openxc/openxc-accessories/README.md

# openxc-accessories
OpenXC Accessories

These devices are not released for public consumption yet.

# License

Copyright (c) 2017 Ford Motor Company Licensed under the BSD license.
