openxc/openxc-accessories/docs/design-sources.rst

==============
Design Sources
==============

.. toctree::
    :maxdepth: 1

    electrical
    mechanical
    assembly
