openxc/openxc-accessories/docs/electrical/Modem/SCHEMATIC-02-Block Diagram.pdf

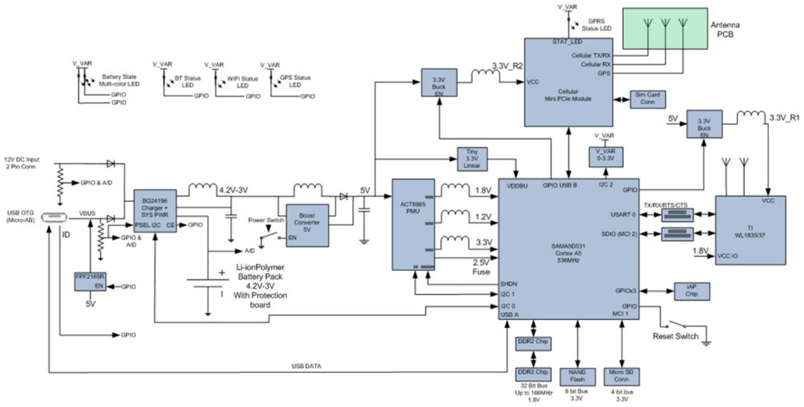
[picture p14: page 1]
