openxc/openxc-accessories/docs/pictures/Figure 5.PNG

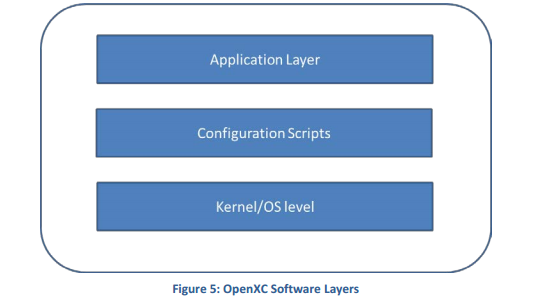
docs/pictures/Figure 5.PNG
