openxc/openxc-accessories/docs/electrical/V2X/BOM_DVT_20160208.xls

Level | Number | Part Type | Description | Commodity Code | BOM.Qty | BOM.UOM | BOM.Ref Des | Manufacturers.Mfr. Name | Manufacturers.Mfr. Part Number
0 | ASY-00001506-001 | Part | ASY,MECHANICAL BOM,OPEN XC V2X
1 | HWR-00001311-000 | Part | ROUND SPACER 0.105" NYLON 5.46MM | HARDWARE (HDW) | 2 | ea |  | BIVAR | 907-215
1 | HWR-00001484-000 | Part | SPACER,NYLON,3/16" OD X 7/32" LENGTH,UNTHREADED,4 | HARDWARE (HDW) | 2 | ea |  | MCMASTER CARR | 94639A617
1 | HWR-00001485-000 | Part | SCR,PAN HD,SLOTTED,MACHINE,NYLON,2x12mm,M2 | HARDWARE (HDW) | 2 | ea |  | MCMASTER CARR | 94270A108
1 | HWR-00001314-000 | Part | SCR,METRIC 18-8 SS PAN HD PHIL MACHINE W/WASHER M2.5 X 8mm LONG | HARDWARE (HDW) | 5 | ea |  | MCMASTER-CARR SUPPLY | 90317A105
1 | HWR-00001317-000 | Part | SCR,18-8 SS FLAT HEAD PHILLIPS BLACK OXIDE, M2 X 10mm LONG | HARDWARE (HDW) | 4 | ea |  | MCMASTER-CARR SUPPLY | 91698A206
1 | HWR-00001489-000 | Part | WASHER,LOCK,SPLIT,18-8 SS,M2 Screw Size,2.4mm ID,4.4mm OD | HARDWARE (HDW) | 2 | ea |  | MCMASTER CARR SUPPLY | 92148A050
1 | HWR-00001490-000 | Part | NUT,HIGH HEX,STEEL,ZINC,LOW-STRENGTH,M2x0.4 THREAD,4mm WIDE,2mm HIGH | HARDWARE (HDW) | 2 | ea |  | MCMASTER CARR SUPPLY | 90725A010
1 | MCH-00002535-000 | Part | BATTERY ADHESSIVE STRIP, 5930P .75in x 4.5 |  | 2 | ea |  | DUMMY MANUFACTURER | No MPN
1 | HWR-00001493-000 | Part | ADHESIVE,J-B WELD,50112, QUICK SETTING, 0.85 OUNCE SYRINGE | HARDWARE (HDW) | 0.001 | ea |  | MCMASTER-CARR SUPPLY | 7605A18
1 | ELC-00002536-000 | Part | ANTENNA,TERMINAL MOUNTED VERTICAL,W/SWIVEL CONNECTOR |  | 2 | ea |  | PULSE ELECTRONICS | W1010
1 | MCH-00001323-000 | Part | TOP HOUSING,INJECTION MOLDED, FMC OPENXC MODEM | NONE | 1 | ea |  | MODEL SOLUTION | MCH-00001323-000
1 | MCH-00001324-000 | Part | BOTTOM HOUSING,INJECTION MOLDED, FMC OPENXC MODEM | NONE | 1 | ea |  | MODEL SOLUTION | MCH-00001324-000
1 | MCH-00001326-000 | Part | BUTTON,INJECTION MOLDED, FMC OPENXC MODEM | NONE | 1 | ea |  | MODEL SOLUTION | MCH-00001326-000
1 | MCH-00001842-000 | Part | Custom Part: Battery Light Pipe-Injection Molded |  | 1 | ea |  | MODEL SOLUTION | No MPN
1 | MCH-00002537-000 | Part | CUSTOM PART: BLUETOOTH LIGHT PIPE-INJECTION MOLDED-V2X |  | 1 | ea |  | MODEL SOLUTION | MCH-00002537-000
1 | MCH-00002538-000 | Part | CUSTOM PART: WIFI LIGHT PIPE-INJECTION MOLDED-V2X |  | 1 | ea |  | MODEL SOLUTION | MCH-00002538-000
1 | MCH-00002539-000 | Part | CUSTOM PART: 802.11P LIGHT PIPE-INJECTION MOLDED-V2X |  | 1 | ea |  | MODEL SOLUTION | MCH-00002539-000
1 | PCA-00001143-002 | Part | PCA,FMC,MAIN,OpenXC | PCA's | 1 | ea |  | FLEXTRONICS INTERNATIONAL | PCA-00001143-001
2 | ELC-00001205-000 | Part | ANTENNA WLAN DUALBAND CERAM CHIP | NONE | 2 | EA | ANT1,ANT2 | PULSE | W3006
2 | CAP-00001213-000 | Part | CAP CER 10UF 35V 10% X7R 1206 | CAP,CERAMIC | 3 | EA | C1,C3,C5 | SAMSUNG | CL31B106KLHNFNE
2 | CAP-00000023-000 | Part | CAP CER 4.7UF 10V 10% X5R 0402 | Capacitors | 16 | EA | C2,C9,C10,C17,C29,C33,C46,C47,C48,C52,C53,C74,C114,C116,C149,C154 | SAMSUNG ELECTRONICS | CL05A475KP5NRNC
2 | CAP-00000018-000 | Part | CAP CER 1UF 10V 20% X5R 0201 | CAP, CER, SMT, 0201 PCK | 50 | EA | C4,C16,C22,C26,C27,C28,C42,C44,C45,C50,C51,C54,C55,C56,C57,C58,C59,C60,C61,C62,C63,C64,C65,C67,C69,C71,C72,C75,C76,C118,C119,C120,C121,C126,C128,C132,C133,C138,C141,C142,C143,C145,C147,C148,C150,C151,C152,C155,C158,C159 | SAMSUNG ELECTRONICS | CL03A105MP3NSNC
2 | CAP-00001214-000 | Part | CAP CER 0.047UF 10V 10% X5R 0201 | CAP, CER, SMT, 0402 PCK | 2 | EA | C6,C40 | SAMSUNG | CL03A473KP3NNNC
2 | CAP-00001215-000 | Part | CAP CER 22UF 25V 20% X5R 0805 | CAP, CER, SMT, 0805 PCK | 9 | EA | C7,C14,C15,C19,C20,C21,C125,C137,C156 | SAMSUNG | CL21A226MAQNNNE
2 | CAP-00001216-000 | Part | CAP CER 10UF 25V 10% X5R 0805 | CAP, CER, SMT, 0805 PCK | 6 | EA | C8,C23,C24,C25,C124,C136 | SAMSUNG | CL21A106KAFN3NE
2 | CAP-00000020-000 | Part | CAP CER 10UF 10V 20% X5R 0402 | CAP, CER, SMT, 0402 PCK | 9 | EA | C11,C12,C30,C31,C34,C35,C37,C38,C144 | SAMSUNG | CL05A106MP5NUNC
2 | CAP-00000024-000 | Part | CAP CER 0.1UF 10V 10% X5R 0201 | Capacitors | 47 | EA | C13,C32,C36,C39,C41,C43,C79,C80,C81,C82,C83,C84,C85,C86,C87,C88,C89,C90,C91,C92,C93,C94,C95,C96,C97,C98,C99,C100,C101,C102,C103,C104,C105,C106,C107,C108,C109,C110,C111,C112,C113,C115,C117,C146,C153,C157,C160 | SAMSUNG ELECTRONICS | CL03A104KP3NNNC
2 | CAP-00000025-000 | Part | CAP CER 10000PF 10V 10% X5R 0201 | Capacitors | 6 | EA | C18,C49,C127,C129,C139,C140 | MURATA ELECTRONICS | GRM033R61A103KA01D
2 | CAP-00001217-000 | Part | CAP CER 15PF 50V 5% NP0 0201 | CAP, CER, SMT, 0201 PCK | 2 | EA | C66,C68 | MURATA MANUFACTURING | GRM0335C1H150JA01D
2 | CAP-00001218-000 | Part | CAP CER 20PF 25V 5% NP0 0201 | CAP, CER, SMT, 0201 PCK | 2 | EA | C70,C73 | MURATA MANUFACTURING | GRM0335C1E200JA01D
2 | CAP-00000122-000 | Part | CAP CER 10PF 50V 2% NP0 0402 | CAP, CER, SMT, 0402 PCK | 1 | EA | C77 | MURATA MANUFACTURING | GRM1555C1H100GA01D
2 | RES-00000102-000 | Part | RES,0R OHM,1/16W,0402 | RESISTORS | 1 | EA | C130 | WALSIN TECHNOLOGY | WR04X000 PTL
 |  |  |  |  |  |  |  | YAGEO | RC0402JR-070RL
 |  |  |  |  |  |  |  | KOA SPEER ELECTRONICS | RK73Z1ETTP
2 | CAP-00001468-000 | Part | CAP CER 1.2PF 50V NP0 0402 | CAP,CERAMIC | 1 | EA | C131 | MURATA MANUFACTURING | GJM1555C1H1R2BB01D
2 | DIO-00001221-000 | Part | DIODE SCHOTTKY 100V 2A POWERMITE | Diodes | 1 | EA | D1 | ON SEMICONDUCTOR | MBRM2H100T3G
2 | DIO-00001222-000 | Part | TVS DIODE 14VWM 23.2VC SMB | Diodes | 1 | EA | D2 | ON SEMICONDUCTOR | 1SMB14CAT3G
2 | DIO-00001469-000 | Part | DIODE SCHOTTKY 20V 2A SOD323 | Diodes | 4 | EA | D3,D4,D6,D15 | NXP SEMICONDUCTORS | PMEG2020AEA,115
2 | DIO-00000623-000 | Part | TVS DIODE 5VWM 18VC SOD882 | Diodes | 2 | EA | D5,D9 | NXP SEMICONDUCTORS | PESD5V0S1UL,315
 |  |  |  |  |  |  |  | NXP SEMICONDUCTORS | PESD9X5.0L
2 | DIO-00000029-000 | Part | TVS DIODE 5VWM SOD882 | Diodes | 2 | EA | D7,D8 | NXP SEMICONDUCTORS | PESD5V0X1BL
 |  |  |  |  |  |  |  | NXP SEMICONDUCTORS | PESD5V0X1BL,315
2 | DIO-00001224-000 | Part | LED 3.2X1.0MM RD/GRN R/A SMD | Diodes | 1 | EA | D10 | KINGBRIGHT | APBA3010SURKCGKC-GX
2 | DIO-00001470-000 | Part | LED RA SMD BLUE 470NM | Diodes | 4 | EA | D11,D12,D13,D14 | KINGBRIGHT | APA3010QBC/D-GX
2 | CON-00001226-000 | Part | CONN HEADER 3POS .100" SNGL SMD | Diodes | 1 | EA | JP1 | SAMTEC | TSM-103-01-L-SV
2 | CON-00001150-000 | Part | CONN HEADER 3MM 2POS R/A TIN | CAP, CER, SMT, 0402 PCK | 1 | EA | J1 | TE CONNECTIVITY | 2-1445055-2
2 | CON-00001227-000 | Part | CONN HEADER PH SIDE 2POS 2MM SMD | CONNECTORS | 1 | EA | J2 | JST | S2B-PH-SM4-TB(LF)(SN)
2 | CON-00001228-000 | Part | CONN UUSB AB REC TOPMT FLANGE TH GRAY | CONNECTORS | 1 | EA | J3 | MOLEX | 47590-1001
2 | CON-00001229-000 | Part | CONN SOCKET MEMORY PCI-E 8H Type I PKG G/F 52P | CONNECTORS | 1 | EA | J4 | MOLEX | 48338-0080
 |  |  |  |  |  |  |  | TE CONNECTIVITY | 1759503-1
2 | CON-00001230-000 | Part | CONN SIM CARD PUSH-PUSH R/A SMD | CONNECTORS | 1 | EA | J5 | WURTH ELECTRONICS | 693 013 050 811
2 | CON-00000134-000 | Part | CONN MICRO SD R/A PUSH-PUSH SMD | CONNECTORS | 1 | EA | J6 | HIROSE | DM3AT-SF-PEJM5
2 | CON-00001471-000 | Part | CONN HEADER 6POS .100" SGL HRZ SMD | CONNECTORS | 1 | EA | J8 | SAMTEC | TSM-106-02-L-SH-P
2 | CON-00001307-000 | Part | CONN UMC JACK STR 50 OHM SMD | CONNECTORS | 2 | EA | J9,J10 | HIROSE | U.FL-R-SMT-1 (10)
2 | IND-00001233-000 | Part | FIXED POWER IND 2.2uH 20% 8A | Inductors | 1 | EA | L1 | COILCRAFT | XFL4020-222MEC
2 | IND-00001234-000 | Part | INDUCTOR 1uH 20% 11A FIXED PWR COMPOS | Inductors | 1 | EA | L2 | COILCRAFT | XFL4020-102MEC
2 | IND-00001235-000 | Part | FIXED IND 10UH 300MA 600 MOHM | Inductors | 4 | EA | L3,L5,L11,L12 | TDK | MLZ1608N100LT000
2 | IND-00001268-000 | Part | FIXED IND 2.2UH 1.3A 80 MOHM SMD | Inductors | 3 | EA | L4,L6,L7 | MURATA MANUFACTURING | LQM2HPN2R2MG0L
2 | IND-00001269-000 | Part | FERRITE CHIP 180OHM 1500MA 0603 | Inductors | 3 | EA | L8,L9,L10 | MURATA MANUFACTURING | BLM18PG181SN1D
2 | IND-00001270-000 | Part | IND .47uH 5.5A XFL4012 | Inductors | 2 | EA | L13,L18 | COILCRAFT | XFL4012-471MEC
2 | IND-00001272-000 | Part | FIXED IND 2.2NH 220MA 300 MOHM | Inductors | 1 | EA | L16 | MURATA ELECTRONICS | LQP15MN2N2B02D
2 | IND-00001472-000 | Part | FIXED IND 4.7NH 160MA 600 MOHM | Inductors | 1 | EA | L17 | MURATA MANUFACTURING | LQP15MN4N7B02D
2 | ICS-00001274-000 | Part | IC,MOSFET N-CH 20V 4.2A SOT-23 | IC,PROC,MICROPROCES | 5 | EA | Q1,Q3,Q4,Q5,Q6 | INTERNATIONAL RECTIFIER | IRLML2502TRPBF
2 | ICS-00001473-000 | Part | IC MOSFET P-CH 30V 3.6A SOT-23-3 | IC | 1 | ea | Q2 | INTERNATIONAL RECTIFIER | IRLML9301TRPBF
2 | RES-00000048-000 | Part | RES 15K OHM 1/20W 1% 0201 SMD | RES,CHIP THICK FILM,0201 | 1 | EA | R1 | PANASONIC | ERJ-1GEF1502C
2 | RES-00000039-000 | Part | RES 10K OHM 1/20W 1% 0201 SMD | RES,CHIP THICK FILM,0201 | 29 | ea | R2,R6,R7,R14,R15,R16,R17,R19,R21,R24,R34,R47,R51,R105,R139,R141,R148,R152,R188,R189,R190,R195,R200,R201,R202,R203,R209,R210,R215 | KOA SPEER ELECTRONICS | RK73H1HTTC1002F
2 | RES-00001275-000 | Part | RES 2K OHM 1/20W 1% 0201 SMD | RES,CHIP THICK FILM,0603 | 8 | ea | R3,R5,R13,R27,R28,R30,R31,R214 | PANASONIC | ERJ-1GEF2001C
2 | RES-00001474-000 | Part | RES SMD 4.32K OHM 1% 1/20W 0201 | RES,CHIP THICK FILM,0402 | 1 | ea | R4 | PANASONIC | ERJ-1GEF4321C
2 | RES-00000684-000 | Part | RES 20K OHM 1/20W 1% 0201 SMD | RES,CHIP THICK FILM,0201 | 1 | EA | R9 | PANASONIC | ERJ-1GEF2002C
2 | RES-00001278-000 | Part | THERMISTOR NTC 10K OHM 1% 0402 | RES,CHIP THICK FILM,0201 | 1 | EA | R11 | PANASONIC | ERT-J0EG103FA
2 | RES-00001279-000 | Part | RES 267 OHM 1/20W 1% 0201 SMD | RES,CHIP THICK FILM,0201 | 1 | EA | R12 | PANASONIC | ERJ-1GEF2670C
2 | RES-00000041-000 | Part | RES 1K OHM 1/20W 1% 0201 SMD | RES,CHIP THICK FILM,0201 | 5 | EA | R18,R36,R143,R144,R145 | KOA SPEER ELECTRONICS | RK73H1HTTC1001F
2 | RES-00000053-000 | Part | RES 200 OHM 1/20W 1% 0201 SMD | RES,CHIP THICK FILM,0201 | 5 | EA | R20,R65,R68,R187,R216 | PANASONIC | ERJ-1GEF2000C
2 | RES-00001280-000 | Part | RES 374 OHM 1/20W 1% 0201 SMD | RES,CHIP THICK FILM,0201 | 1 | EA | R22 | PANASONIC | ERJ-1GEF3740C
2 | RES-00001281-000 | Part | RES 1.27K OHM 1/20W 1% 0201 SMD | RES,CHIP THICK FILM,0201 | 1 | EA | R23 | PANASONIC | ERJ-1GEF1271C
2 | RES-00001478-000 | Part | RES SMD 33.2K OHM 1% 1/20W 0201 | RES,CHIP THICK FILM,0402 | 1 | ea | R25 | PANASONIC | ERJ-1GEF3322C
2 | RES-00000045-000 | Part | RES 100K OHM 1/20W 1% 0201 SMD | RES,CHIP THICK FILM,0201 | 13 | EA | R26,R40,R41,R44,R70,R71,R72,R107,R140,R154,R155,R156,R157 | PANASONIC | ERJ-1GEF1003C
2 | RES-00000872-000 | Part | RES 1 OHM 1/10W 5% 0402 SMD | RESISTORS | 3 | EA | R29,R48,R66 | PANASONIC | ERJ-2GEJ1R0X
2 | RES-00001282-000 | Part | RES 2.2 OHM 1/10W 5% 0402 SMD | RESISTORS | 3 | EA | R32,R35,R39 | PANASONIC | ERJ-2GEJ2R2X
2 | RES-00000040-000 | Part | RES 49.9K OHM 1/20W 1% 0201 SMD | RES,CHIP THICK FILM,0201 | 26 | ea | R37,R38,R146,R147,R149,R150,R158,R159,R169,R170,R171,R172,R173,R174,R175,R176,R177,R178,R179,R180,R181,R182,R183,R184,R185,R186 | PANASONIC | ERJ-1GEF4992C
2 | RES-00001283-000 | Part | RES 1.5K OHM 1/20W 1% 0201 SMD | RES,CHIP THICK FILM,0201 | 3 | EA | R43,R67,R69 | PANASONIC | ERJ-1GEF1501C
2 | RES-00001284-000 | Part | RES 5.62K OHM 1/20W 1% 0201 SMD | RES,CHIP THICK FILM,0201 | 1 | EA | R49 | PANASONIC | ERJ-1GEF5621C
2 | RES-00000148-000 | Part | RES 0.0 OHM 1/8W JUMP 0805 SMD | RES,CHIP THICK FILM,0805 | 2 | EA | R50,R206 | YAGEO | RC0805FR-070RL
2 | RES-00000043-000 | Part | RES 0.0 OHM 1/20W JUMP 0201 SMD | RES,CHIP THICK FILM,0201 | 18 | EA | R52,R59,R60,R106,R108,R162,R163,R164,R165,R166,R167,R168,R196,R198,R204,R208,R212,R217 | YAGEO | RC0201JR-070RL
2 | RES-00001479-000 | Part | RES SMD 140 OHM 1% 1/20W 0201 | RES,CHIP THICK FILM,0402 | 1 | ea | R53 | PANASONIC | ERJ-1GEF1400C
2 | RES-00001480-000 | Part | RES SMD 84.5 OHM 1% 1/20W 0201 | RES,CHIP THICK FILM,0402 | 4 | ea | R54,R55,R56,R142 | PANASONIC | ERJ-1GEF84R5C
2 | RES-00001285-000 | Part | RES 4.7K OHM 1/20W 1% 0201 SMD | RES,CHIP THICK FILM,0201 | 6 | EA | R61,R62,R63,R64,R194,R219 | PANASONIC | ERJ-1GEF4701C
2 | RES-00000050-000 | Part | RES 20 OHM 1/20W 1% 0201 SMD | RES,CHIP THICK FILM,0201 | 1 | EA | R153 | PANASONIC | ERJ-1GEF20R0C
2 | RES-00001481-000 | Part | RES SMD 402 OHM 1% 1/20W 0201 | RES,CHIP THICK FILM,0402 | 2 | ea | R191,R192 | PANASONIC | ERJ-1GEF4020C
2 | RES-00001276-000 | Part | RES 5.49K OHM 1/20W 1% 0201 SMD | RES,CHIP THICK FILM,0201 | 1 | EA | R193 | PANASONIC | ERJ-1GEF5491C
2 | RES-00001482-000 | Part | RES SMD 576 OHM 1% 1/20W 0201 | RES,CHIP THICK FILM,0201 | 1 | EA | R207 | PANASONIC | ERJ-1GEF5760C
2 | ELC-00001286-000 | Part | SWITCH PUSH SPDT 0.2A 30V | SWITCHES | 1 | EA | SW1 | C & K COMPONENTS | PN12SJNA03QE
2 | ELC-00000526-002 | Part | SWITCH TACTILE SPST-NO 0.05A 12V | Electrical | 1 | EA | SW2 | PANASONIC | EVQPUK02K
2 | ICS-00001287-000 | Part | IC BATT CHARGE MGMT 24VQFN | IC | 1 | EA | U1 | TEXAS INSTRUMENTS | bq24196RGET
2 | ICS-00001288-000 | Part | IC LOAD SW FULL FUNCT ADJ 6MLP | IC | 1 | EA | U2 | FAIRCHILD | FPF2165R
2 | ICS-00001289-000 | Part | IC REG LDO ADJ 0.15A 6MLF | IC | 1 | EA | U3 | MICREL | MIC5305YML
2 | ICS-00001290-000 | Part | IC REG BOOST SYNC 5V 5A 10SON | IC | 1 | EA | U4 | TEXAS INSTRUMENTS | TPS61232DRCT
2 | ICS-00001291-000 | Part | IC POT DGTL 32TAP NV TSOT23-6 | IC | 1 | EA | U5 | MAXIM INTEGRATED PRODUCTS | MAX5434LEZT+T
2 | ICS-00001292-000 | Part | IC PMU CONV/LDO REG 32TQFN | IC | 1 | EA | U6 | ACTIVE SEMI | ACT8865QI305-T
2 | ICS-00001293-000 | Part | IC REG LDO 3.3V 0.15A SOT23 | IC | 1 | EA | U7 | DIODES | AP2120N-3.3TRG1
2 | ICS-00001294-000 | Part | IC MCU 32BIT 160KB FLASH 324BGA | IC | 1 | EA | U8 | ATMEL | ATSAMA5D31A-CU
2 | ICS-00001295-000 | Part | IC DDR2 SDRAM 1GBIT 2.5NS 84FBGA | IC | 2 | EA | U9,U10 | MICRON | MT47H64M16HR-25E:H
2 | ICS-00001308-000 | Part | IC BUS TRANSCVR 4BIT 16-UQFN | IC | 2 | EA | U12,U13 | TEXAS INSTRUMENTS | SN74AVC4T245RSVR
2 | ICS-00001298-000 | Part | IC REG BUCK SYNC 3.3V 3A 16QFN | IC | 2 | EA | U14,U18 | TEXAS INSTRUMENTS | TPS62091RGTT
2 | ELC-00001299-000 | Part | MODULE WIFI WILINK | NONE | 1 | EA | U15 | TEXAS INSTRUMENTS | WL1835MODGBMOCT
 |  |  |  |  |  |  |  | TEXAS INSTRUMENTS | WL1835MODGBMOCR
 |  |  |  |  |  |  |  | TEXAS INSTRUMENTS | WL1837MODGIMOCT
 |  |  |  |  |  |  |  | TEXAS INSTRUMENTS | WL1837MODGIMOCR
2 | ICS-00001309-000 | Part | IC XLATR VOLT-LVL 8B BDIR 20QFN | IC | 1 | EA | U16 | TEXAS INSTRUMENTS | TXS0108ERGYR
2 | ICS-00001303-000 | Part | IC EEPROM 2KBIT 400KHZ TSOT23-5 | IC | 1 | EA | U19 | ON SEMICONDUCTOR | CAT24AA02TDI-GT3
2 | ICS-00001310-000 | Part | IC BUFF/DVR NON-INVERT SC705 | IC | 1 | EA | U21 | TEXAS INSTRUMENTS | SN74AUC1G07DCKR
2 | ICS-00001476-000 | Part | IC USB FS SERIAL UART 32-QFN | IC | 1 | ea | U22 | FUTURE TECHNOLOGY DEVICES INTERNATIONAL | FT232RQ-REEL
2 | OSC-00001304-000 | Part | OSC XO 32.768KHZ CMOS SMD | OSC | 1 | EA | X1 | TXC CORPORATION | 7XZ-32.768KDA-T
2 | XTL-00001305-000 | Part | CRYSTAL 12MHZ 12PF SMD | Crystal | 1 | EA | Y1 | EPSON | FA-238V 12.0000MB-W3
2 | XTL-00000186-003 | Part | CRYSTAL 32.768KHZ 12.5PF SMD | Crystal | 1 | EA | Y2 | SEIKO INSTRUMENTS | SSPT7F-12.5PF20-R
2 | PCB-00001143-002 | Part | PCB,(FAB),FMC,MAIN,OpenXC | PCA's | 1 | EA |  | HALLMARK CIRCUITS | PCB-00001143-001
2 | RES-00001597-000 | Part | RES SMD 2.15K OHM 1% 1/20W 0201 | RES,CHIP THIN FILM | 1 | ea | R8 | PANASONIC | ERJ-1GNF2151C
2 | RES-00001598-000 | Part | RES SMD 7.5K OHM 1% 1/20W 0201 | RES,CHIP THIN FILM | 1 | ea | R10 | PANASONIC | ERJ-1GNF7501C
2 | RES-00001599-000 | Part | RES SMD 41.2K OHM 1% 1/20W 0201 | RES,CHIP THIN FILM | 1 | ea | R211 | PANASONIC | ERJ-1GNF4122C
2 | ICS-00001593-000 | Part | IC FLASH 4GBIT 48TSOP | IC | 1 | ea | U11 | MICRON TECHNOLOGY | MT29F4G08ABADAWP:D TR
1 | PCA-00001382-001 | Part | PCA Board, FMC,CARRIER,OpenXC V2X V2 |  | 1 | ea
2 | CAP-00002250-000 | Part | CAP CER 47UF 10V X5R 0805 | CAP, CER, SMT, 0805 PCK | 4 | ea | C15,C16,C17,C18 | TDK | C2012X5R1A476M125AC
2 | CAP-00000925-000 | Part | CAP CER 0.1UF 50V 10% X7R 0805 | CAP, CER, SMT, 0805 PCK | 1 | ea | C19 | KEMET ELECTRONICS | C0805C104K5RACAUTO
2 | RES-00002253-000 | Part | RES SMD 0.0 OHM JUMPER 1/16W 0402 | RES,CHIP THICK FILM | 4 | ea | C20,C21,C26,C27 | VISHAY | CRCW04020000Z0ED
2 | CON-00001431-000 | Part | CONN SMA JACK 50 OHM EDGE MNT | Connectors/Terminals/Lugs | 2 | ea | J2,J3 | AMPHENOL | 132289
2 | RES-00001380-000 | Part | RES SMD 0.0 OHM JUMPER 1/16W | RES,CHIP THICK FILM | 9 | ea | L1,L2,R1,R4,R5,R7,R8,R9,R10 | VISHAY | CRCW04020000Z0EDHP
2 | ICS-00001432-000 | Part | IC MOSFET N-CH 20V 1.2A SOT-23 | IC | 1 | ea | Q1 | INTERNATIONAL RECTIFIER | IRLML2502TRPBF
2 | RES-00000104-000 | Part | RES 10K OHM 1/16W 1% 0402 SMD | RESISTORS | 1 | ea | R3 | KOA SPEER ELECTRONICS | RK73H1ETTP1002F
 |  |  |  |  |  |  |  | YAGEO | RC0402FR-0710KL
 |  |  |  |  |  |  |  | WALSIN TECHNOLOGY | WR04X1002FTL
2 | ELC-00001440-000 | Part | MODULE,COHDA WIRELESS,MOBILE BROADBAND,MK5 | NONE | 1 | ea | U1 | COHDA WIRELESS | CWD-P0052-HWM-DATA-WW01-061
2 | PCB-00001382-001 | Part | PCB Board, FMC,CARRIER,OpenXC V2X V2 |  | 1 | ea
1 | LBL-00002540-000 | Part | LABEL,OPENXC V2X,1.5 Inch WIDE X .4 Inch HIGH |  | 1 | ea |  | DUMMY MANUFACTURER | No MPN
1 | ELC-00002541-000 | Part | BATTERY SUBASSEMBLY |  | 1 | ea
2 | CON-00001851-000 | Part | CONN HOUSING PH 2POS 2MM WHITE |  | 1 | ea |  | JST | PHR-2
2 | CON-00001852-000 | Part | CONN TERMINAL 28-24AWG TIN |  | 2 | ea |  | JST | SPH-002T-P0.5L
2 | ELC-00002542-000 | Part | Tenergy Li-Polymer 3.7V 5500mAh (7550140) Battery w/ PCB |  | 1 | ea |  | DUMMY MANUFACTURER | No MPN
