openxc/openxc-accessories/docs/electrical/Modem/Modem_COSTED_BOM_QUOTE.xlsx

Sheet: CBOM
Costed BOM |  |  |  |  |  |  |  |  |  |  |  |  | Quote Terms & Condition:
Project: |  |  | QUOTE ID#: 580 FORD |  |  |  |  |  |  |  |  |  | Quote valid for current revision of BOM
Volume: |  |  | 1-3 |  |  |  |  |  |  |  |  |  | Quote is based on combination of distributor and mfg stock.
Currency: |  |  | USD |  |  |  |  |  |  |  |  |  | Est cost on no distributor stock items will be updated once stock is found
Report On: |  |  | Selected Cost |  |  |  |  |  |  |  |  |  | Stock for low volumes reflects current avail and may be sold at any time - true price will be what is avail at time of purchase
Sort By: |  |  | Line Number |  |  |  |  |  |  |  |  |  | Quoted Price is valid for 30 days – subject to market conditions
Time Generated: |  |  | 8/4/15 5:22:50 PM |  |  |  |  |  |  |  |  |  | NCNR, MOQ and Excess buys, to be approved as required
 |  |  |  |  |  |  |  |  |  |  |  |  | Customer help is needed for missing pricing due to imcomplete AVL
*** Assembly Summary |  |  |  |  |  |  |  |  |  |  |  |  | Customer help is needed in the case of LOA and misalignment condition
Assembly | Line | Description | Ext Cost #1 | Ext Vol Qty #1 | Ext Vol Cost #1 | Ext Cost #2 | Ext Vol Qty #2 | Ext Vol Cost #2 | Ext Cost #3 | Ext Vol Qty #3 | Ext Vol Cost #3
TLA-00001300-002 | 1 | TLA,FMC,XCMODEM V1-DVT VERSION | 441.564379 | 50 | 22078.21895 | 409.633019 | 100 | 40963.3019 | 332.465999 | 500 | 166232.9995
TLA-00001300-002 ATTRITION | 2 | TLA,FMC,XCMODEM V1-DVT VERSION | 24.75356 | 50 | 618.839 | 10.94097 | 100 | 547.0485 | 1.5792912 | 500 | 394.8228
 |  |  | 466.317939 |  | 22697.05795 | 420.573989 |  | 41510.3504 | 334.0452902 |  | 166627.8223
*** Assembly: TLA-00001300-002 rev 1 Line #1
Part Number | Line | Part Qty | Unit | Description | Commodity | AML | Mfg ID | Mfg Part Number | Corrected MPN | Supp ID | No Bid | Lead Time | Inventory | MOQ | Delivery Terms | NCNR | Short Comment | Long Comment | Raw Currency | Currency | NRE Charge | Cost #1 | Ext Cost #1 | Cost #2 | Ext Cost #2 | Cost #3 | Ext Cost #3 | Ownership
ELC-00001321-000 | 1 | 1 | EA | MODULE,3G,MINI PCIE |  | X | TELIT | HEPCIGPS204T701 |  | ARROW |  | 7 | 498 | 3 | FOB |  |  |  | USD | USD |  | 87.52 | 87.52 | 87.52 | 87.52 | 81.14 | 81.14
ELC-00001327-000 | 2 | 1 | EA | PCA,ANTENNA BOARD,FMC OPENXC |  |  | WORLDPROD | WPANT10074-C2A |  | WPG |  | 16 | 100 | 100 |  |  |  |  | USD | USD |  | 2.48 | 2.48 | 2.48 | 2.48 | 2.48 | 2.48
ELC-00001836-000 | 3 | 1 | EA | 12 * 12 * 2MM PASSIVE GPS ANTENNA CABLE LENGTH 70MM |  | X | ISSUE | ELC-00001836-000 |  | ISSUE |  |  |  |  |  |  |  |  | USD | USD |  | 0 | 0
ELC-00001847-000 | 4 | 1 |  | BATTERY SUBASSEMBLY |  |  |  |  |  |  |  |  |  |  |  |  |  |  |  | USD |  | 40.1518 | 40.1518 | 40.1502 | 40.1502 | 40.12642 | 40.12642
HWR-00001311-000 | 5 | 2 | EA | ROUND SPACER 0.105 NYLON 5.46MM |  | X | BIVAR | 907-215 | 907-215 | MOUSER ELE |  | 4 | 3000 | 1 | N/A |  |  | QUOTE VALID FOR 30 DAYS - STANDOFFS & SPACERS PLASTIC SPCR .215 IN NYLON WHITE | USD | USD |  | 0.051 | 0.102 | 0.051 | 0.102 | 0.034 | 0.068
HWR-00001312-000 | 6 | 2 | EA | 18-8 STAINLESS STEEL METRIC PAN HEAD PHILLIPS MACHINE SCREW |  | X | MCMASTER | 92000A019 |  | MCMASTER |  | 4 | 2000 | 100 |  |  |  |  | USD | USD |  | 0.0476 | 0.0952 | 0.0476 | 0.0952 | 0.0476 | 0.0952
HWR-00001314-000 | 7 | 5 | EA | SCR,METRIC 18-8 SS PAN HD PHIL MACHINE W/WASHER M2.5 X 8MM LONG |  | X | MCMASTER | 90317A105 |  | MCMASTER |  | 4 | 5000 | 25 |  |  |  |  | USD | USD |  | 0.328 | 1.64 | 0.328 | 1.64 | 0.328 | 1.64
HWR-00001317-000 | 8 | 4 | EA | SCR,18-8 SS FLAT HEAD PHILLIPS BLACK OXIDE, M2 X 10MM LONG |  | X | MCMASTER | 91698A206 |  | MCMASTER |  | 4 | 4000 | 100 |  |  |  |  | USD | USD |  | 0.0992 | 0.3968 | 0.0992 | 0.3968 | 0.0992 | 0.3968
HWR-00001489-000 | 9 | 2 | EA | WASHER,LOCK,SPLIT,18-8 SS,M2 SCREW SIZE,2.4MM ID,4.4MM OD |  | X | MCMASTER | 92148A050 |  | MCMASTER |  | 4 | 2000 | 100 |  |  |  |  | USD | USD |  | 0.0118 | 0.0236 | 0.0118 | 0.0236 | 0.0118 | 0.0236
HWR-00001490-000 | 10 | 2 | EA | NUT,HIGH HEX,STEEL,ZINC,LOW-STRENGTH,M2X0.4 THREAD,4MM WIDE,2MM HIGH |  | X | MCMASTER | 90725A010 |  | MCMASTER |  | 4 | 2000 | 25 |  |  |  |  | USD | USD |  | 0.3128 | 0.6256 | 0.3128 | 0.6256 | 0.3128 | 0.6256
HWR-00001491-000 | 11 | 17.67 | IN | TAPE,FOAM,3M VHB,ADHESIVE ON BOTH SIDES,#4926,3/4 W X 72 YARDS L, .015 THICK |  | X | MCMASTER | 8127A72 |  | MCMASTER |  | 4 | 50000 | 2592 |  |  |  | PRICE FOR EACH INCHE | USD | USD |  | 0.0757 | 1.337619 | 0.0757 | 1.337619 | 0.0757 | 1.337619
HWR-00001492-000 | 12 | 1 | EA | TIE,CABLE,NYLON,4 LONG, 7/8 BUNDLE DIAMETER,10 LB. BREAK STRENGTH, BLACK |  | X | MCMASTER | 7130K52 |  | MCMASTER |  | 4 | 2000 | 100 |  |  |  |  | USD | USD |  | 0.0243 | 0.0243 | 0.0243 | 0.0243 | 0.0243 | 0.0243
HWR-00001493-000 | 13 | 0.07 | EA | ADHESIVE,J-B WELD,50112, QUICK SETTING, 0.85 OUNCE SYRINGE |  | X | MCMASTER | 7605A18 |  | MCMASTER |  | 4 | 100 | 1 |  |  |  | PRICE FOR BOTTLE OF 0.85 OUNCE | USD | USD |  | 5.74 | 0.4018 | 5.74 | 0.4018 | 5.74 | 0.4018
LBL-00001884-000 | 14 | 1 | EA | LABEL,OPENXC MODEM,1.5 INCH WIDE X .4 INCH HIGH |  | X | ISSUE | LBL-00001884-000 |  | ISSUE |  |  |  |  |  |  |  |  | USD | USD |  | 0 | 0
MCH-00001323-000 | 15 | 1 | EA | TOP HOUSING,INJECTION MOLDED, FMC OPENXC MODEM |  | X | CONSIGN | MCH-00001323-000 |  | CONSIGNED |  |  |  |  |  |  |  |  | USD | USD |  | 0 | 0
MCH-00001324-000 | 16 | 1 | EA | BOTTOM HOUSING,INJECTION MOLDED, FMC OPENXC MODEM |  | X | CONSIGN | MCH-00001324-000 |  | CONSIGNED |  |  |  |  |  |  |  |  | USD | USD |  | 0 | 0
MCH-00001326-000 | 17 | 1 | EA | BUTTON,INJECTION MOLDED, FMC OPENXC MODEM |  | X | CONSIGN | MCH-00001326-000 |  | CONSIGNED |  |  |  |  |  |  |  |  | USD | USD |  | 0 | 0
MCH-00001837-000 | 18 | 1 | EA | FERRITE COVER FOR PCB-NEC/TOKIN FLEX SUPPRESSOR EFF(03) T0800 |  | X | KEMET | EFF(03)-240X240T0800 |  | DIGIKEY |  | 18 |  | 10 |  |  |  |  | USD | USD |  | 85.74 | 85.74 | 85.74 | 85.74 | 82.5088 | 82.5088
MCH-00001842-000 | 19 | 1 | EA | CUSTOM PART: BATTERY LIGHT PIPE-INJECTION MOLDED |  | X | CONSIGN | MCH-00001842-000 |  | CONSIGNED |  |  |  |  |  |  |  |  | USD | USD |  | 0 | 0
MCH-00001843-000 | 20 | 1 | EA | CUSTOM PART:BLUETOOTH LIGHT PIPE-INJECTION MOLDED |  | X | CONSIGN | MCH-00001843-000 |  | CONSIGNED |  |  |  |  |  |  |  |  | USD | USD |  | 0 | 0
MCH-00001844-000 | 21 | 1 | EA | CUSTOM PART: 3G LIGHT PIPE-INJECTION MOLDED |  | X | CONSIGN | MCH-00001844-000 |  | CONSIGNED |  |  |  |  |  |  |  |  | USD | USD |  | 0 | 0
MCH-00001845-000 | 22 | 1 | EA | CUSTOM PART: GPS LIGHT PIPE-INJECTION MOLDED |  | X | CONSIGN | MCH-00001845-000 |  | CONSIGNED |  |  |  |  |  |  |  |  | USD | USD |  | 0 | 0
MCH-00001846-000 | 23 | 1 | EA | CUSTOM PART: WIFI LIGHT PIPE-INJECTION MOLDED |  | X | CONSIGN | MCH-00001846-000 |  | CONSIGNED |  |  |  |  |  |  |  |  | USD | USD |  | 0 | 0
PCA-00001143-002 | 24 | 1 |  | PCA,FMC,MAIN,OPENXC |  |  |  |  |  |  |  |  |  |  |  |  |  |  |  | USD |  | 221.02566 | 221.02566 | 189.0959 | 189.0959 | 121.59786 | 121.59786
SWR-00001994-000 | 25 | 1 | EA | XCMODEM-UPGRADE-0.14.MD5 |  | X | REFERENCE | SWR-00001994-000 |  | REFERENCE |  |  |  |  |  |  |  |  | USD | USD |  | 0 | 0
SWR-00001995-000 | 26 | 1 | EA | SAMA5D3_XPLAINED-V1.1 |  | X | REFERENCE | SWR-00001995-000 |  | REFERENCE |  |  |  |  |  |  |  |  | USD | USD |  | 0 | 0
TLA-00001300-002-BOMCHECKER | 27 | 0 | EA | BOMCHECKER |  | X | REFERENCE | TLA-00001300-002-BOMCHECKER |  | REFERENCE |  |  |  |  |  |  |  |  | USD | USD |  | 0 | 0
TLA-00001300-002-ORIGINAL BOM | 28 | 0 | EA | ORIGINAL BOM |  | X | REFERENCE | TLA-00001300-002-ORIGINAL BOM |  | REFERENCE |  |  |  |  |  |  |  |  | USD | USD |  | 0 | 0
TLA-00001300-002-PI | 29 | 0 | EA | PROCESS INSTRUCTIONS |  | X | REFERENCE | TLA-00001300-002-PI |  | REFERENCE |  |  |  |  |  |  |  |  | USD | USD |  | 0 | 0
 |  |  |  |  |  |  |  |  |  |  |  |  |  |  |  |  |  |  |  |  |  |  | 441.564379 |  | 409.633019 |  | 332.465999
*** Assembly: ELC-00001847-000 Line #1.4
Part Number | Line | Part Qty | Unit | Description | Commodity | AML | Mfg ID | Mfg Part Number | Corrected MPN | Supp ID | No Bid | Lead Time | Inventory | MOQ | Delivery Terms | NCNR | Short Comment | Long Comment | Raw Currency | Currency | NRE Charge | Cost #1 | Ext Cost #1 | Cost #2 | Ext Cost #2 | Cost #3 | Ext Cost #3 | Ownership
CON-00001851-000 | 1 | 1 | EA | CONN HOUSING PH 2POS 2MM WHITE |  | X | JST | PHR-2 |  | DIGIKEY |  | 14 | 191030 | 50 |  |  |  |  | USD | USD |  | 0.05 | 0.05 | 0.0484 | 0.0484 | 0.04004 | 0.04004
CON-00001852-000 | 2 | 2 | EA | CONN TERMINAL 28-24AWG TIN |  | X | JST | SPH-002T-P0.5L |  | DIGIKEY |  | 14 | 22349 | 100 |  |  |  |  | USD | USD |  | 0.0309 | 0.0618 | 0.0309 | 0.0618 | 0.02319 | 0.04638
ELC-00001848-000 | 3 | 1 | EA | HIGH CAPACITY 3200MAH 3.8V LI-ION RECHARGEABLE |  | X | SAMSUNG | B800BU | EB-B800BUBESTA | SAMSUNG EM |  | 16 | 0 | 1 |  |  |  |  | USD | USD |  | 39.99 | 39.99 | 39.99 | 39.99 | 39.99 | 39.99
ELC-00001849-000 | 4 | 1 | EA | STRANDED WIRE, 300V AC, 24 GAUGE,BLACK |  |  | MCMASTER | 8054T22 |  | MCMASTER |  | 4 | 2000 | 127 |  |  |  | ROLL OF 25 FT | USD | USD |  | 0.025 | 0.025 | 0.025 | 0.025 | 0.025 | 0.025
ELC-00001850-000 | 5 | 1 | EA | STRANDED WIRE, 300V AC, 24 GAUGE,RED |  |  | MCMASTER | 8054T22-RED |  | MCMASTER |  | 4 |  | 127 |  |  |  | ROLL OF 25 FT | USD | USD |  | 0.025 | 0.025 | 0.025 | 0.025 | 0.025 | 0.025
 |  |  |  |  |  |  |  |  |  |  |  |  |  |  |  |  |  |  |  |  |  |  | 40.1518 |  | 40.1502 |  | 40.12642
*** Assembly: PCA-00001143-002 Line #1.24
Part Number | Line | Part Qty | Unit | Description | Commodity | AML | Mfg ID | Mfg Part Number | Corrected MPN | Supp ID | No Bid | Lead Time | Inventory | MOQ | Delivery Terms | NCNR | Short Comment | Long Comment | Raw Currency | Currency | NRE Charge | Cost #1 | Ext Cost #1 | Cost #2 | Ext Cost #2 | Cost #3 | Ext Cost #3 | Ownership
ELC-00001205-000 | 1 | 2 | EA | ANTENNA WLAN DUALBAND CERAM CHIP |  | X | PULSE | W3006 |  | DIGIKEY |  | 6 | 2796 | 100 |  |  |  |  | USD | USD |  | 1.4848 | 2.9696 | 1.4848 | 2.9696 | 0.851 | 1.702
CAP-00001213-000 | 2 | 3 | EA | CAP CER 10UF 35V 10% X7R 1206 |  | X | SAMSUNG | CL31B106KLHNFNE |  | DIGIKEY |  | 13 | 3487 | 100 |  |  |  |  | USD | USD |  | 0.471 | 1.413 | 0.471 | 1.413 | 0.32665 | 0.97995
CAP-00000023-000 | 3 | 16 | EA | CAP CER 4.7UF 10V 10% X5R 0402 |  | X | SAMSUNG | CL05A475KP5NRNC |  | DIGIKEY |  | 10 | 92941 | 500 |  |  |  |  | USD | USD |  | 0.20188 | 3.23008 | 0.1854 | 2.9664 | 0.15244 | 2.43904
CAP-00000018-000 | 4 | 50 | EA | CAP CER 1UF 10V 20% X5R 0201 |  | X | SAMSUNG | CL03A105MP3NSNC |  | DIGIKEY |  | 13 | 1060904 | 1000 |  |  |  |  | USD | USD |  | 0.18127 | 9.0635 | 0.17198 | 8.599 | 0.17198 | 8.599
CAP-00001214-000 | 5 | 2 | EA | CAP CER 0.047UF 10V 10% X5R 0201 |  | X | SAMSUNG | CL03A473KP3NNNC |  | DIGIKEY |  | 10 | 13387 | 100 |  |  |  |  | USD | USD |  | 0.0856 | 0.1712 | 0.0856 | 0.1712 | 0.05199 | 0.10398
CAP-00001215-000 | 6 | 9 | EA | CAP CER 22UF 25V 20% X5R 0805 |  | X | SAMSUNG | CL21A226MAQNNNE |  | DIGIKEY |  | 10 | 492320 | 250 |  |  |  |  | USD | USD |  | 0.6 | 5.4 | 0.45 | 4.05 | 0.41 | 3.69
CAP-00001216-000 | 7 | 6 | EA | CAP CER 10UF 25V 10% X5R 0805 |  | X | SAMSUNG | CL21A106KAFN3NE |  | DIGIKEY |  | 10 | 92000 | 250 |  |  |  |  | USD | USD |  | 0.1024 | 0.6144 | 0.06784 | 0.40704 | 0.06016 | 0.36096
CAP-00000020-000 | 8 | 9 | EA | CAP CER 10UF 10V 20% X5R 0402 |  | X | SAMSUNG | CL05A106MP5NUNC |  | DIGIKEY |  | 10 | 1365756 | 250 |  |  |  |  | USD | USD |  | 0.3021 | 2.7189 | 0.22776 | 2.04984 | 0.18127 | 1.63143
CAP-00000024-000 | 9 | 47 | EA | CAP CER 0.1UF 10V 10% X5R 0201 |  | X | SAMSUNG | CL03A104KP3NNNC |  | DIGIKEY |  | 10 | 134292 | 1000 |  |  |  |  | USD | USD |  | 0.0081 | 0.3807 | 0.00729 | 0.34263 | 0.00675 | 0.31725
CAP-00000025-000 | 10 | 6 | EA | CAP CER 10000PF 10V 10% X5R 0201 |  | X | MURATA | GRM033R61A103KA01D |  | DIGIKEY |  | 10 | 1305112 | 250 |  |  |  |  | USD | USD |  | 0.009 | 0.054 | 0.0077 | 0.0462 | 0.006 | 0.036
CAP-00001217-000 | 11 | 2 | EA | CAP CER 15PF 50V 5% NP0 0201 |  | X | MURATA | GRM0335C1H150JA01D |  | DIGIKEY |  | 18 | 352426 | 100 |  |  |  |  | USD | USD |  | 0.0107 | 0.0214 | 0.0107 | 0.0214 | 0.0057 | 0.0114
CAP-00001218-000 | 12 | 2 | EA | CAP CER 20PF 25V 5% NP0 0201 |  | X | MURATA | GRM0335C1E200JA01D |  | DIGIKEY |  | 15 | 29288 | 100 |  |  |  |  | USD | USD |  | 0.0105 | 0.021 | 0.0105 | 0.021 | 0.0057 | 0.0114
CAP-00000122-000 | 13 | 1 | EA | CAP CER 10PF 50V 2% NP0 0402 |  | X | MURATA | GRM1555C1H100GA01D |  | DIGIKEY |  | 10 | 66090 | 50 |  |  |  |  | USD | USD |  | 0.0312 | 0.0312 | 0.0264 | 0.0264 | 0.01848 | 0.01848
RES-00000102-000 | 14 | 1 | EA | RES,0R OHM,1/16W,0402 |  | X | YAGEO | RC0402JR-070RL |  | DIGIKEY |  | 20 | 8438507 | 50 |  |  |  |  | USD | USD |  | 0.0092 | 0.0092 | 0.0053 | 0.0053 | 0.0032 | 0.0032
CAP-00001468-000 | 15 | 1 | EA | CAP CER 1.2PF 50V NP0 0402 |  | X | MURATA | GJM1555C1H1R2BB01D |  | DIGIKEY |  | 9 | 8252 | 50 |  |  |  |  | USD | USD |  | 0.0804 | 0.0804 | 0.0664 | 0.0664 | 0.04682 | 0.04682
DIO-00001221-000 | 16 | 1 | EA | DIODE SCHOTTKY 100V 2A POWERMITE |  | X | ON | MBRM2H100T3G |  | DIGIKEY |  | 4 | 15869 | 50 |  |  |  |  | USD | USD |  | 0.7576 | 0.7576 | 0.6603 | 0.6603 | 0.48926 | 0.48926
DIO-00001222-000 | 17 | 1 | EA | TVS DIODE 14VWM 23.2VC SMB |  | X | ON | 1SMB14CAT3G | 1SMB14CAT3G | MOUSER ELE |  | 14 | 1835 | 1 | N/A |  |  | QUOTE VALID FOR 30 DAYS - TVS DIODES - TRANSIENT VOLTAGE SUPPRESSORS 14V 600W BIDIRECTIONAL | USD | USD |  | 0.347 | 0.347 | 0.194 | 0.194 | 0.194 | 0.194
DIO-00001469-000 | 18 | 4 | EA | DIODE SCHOTTKY 20V 2A SOD323 |  | X | NXP | PMEG2020AEA,115 |  | DIGIKEY |  | 6 | 6420 | 100 |  |  |  |  | USD | USD |  | 0.2505 | 1.002 | 0.20752 | 0.83008 | 0.12839 | 0.51356
DIO-00000623-000 | 19 | 2 | EA | TVS DIODE 5VWM 18VC SOD882 |  | X | NXP | PESD9X5.0L,315 | PESD5V0L1UL,315 | DIGIKEY |  | 16 | 12864 | 100 |  |  |  |  | USD | USD |  | 0.2165 | 0.433 | 0.2165 | 0.433 | 0.0985 | 0.197
DIO-00000029-000 | 20 | 2 | EA | TVS DIODE 5VWM SOD882 |  | X | NXP | PESD5V0X1BL |  | DIGIKEY |  | 14 | 59069 | 100 |  |  |  |  | USD | USD |  | 0.3634 | 0.7268 | 0.3634 | 0.7268 | 0.2058 | 0.4116
DIO-00001224-000 | 21 | 1 | EA | LED 3.2X1.0MM RD/GRN R/A SMD |  | X | KINGBRIGHT | APBA3010SURKCGKC-GX |  | DIGIKEY |  | 8 | 82194 | 50 |  |  |  |  | USD | USD |  | 0.3432 | 0.3432 | 0.273 | 0.273 | 0.2028 | 0.2028
DIO-00001470-000 | 22 | 4 | EA | LED RA SMD BLUE 470NM |  | X | KINGBRIGHT | APA3010QBC/D-GX |  | DIGIKEY |  | 8 | 22986 | 100 |  |  |  |  | USD | USD |  | 0.2765 | 1.106 | 0.237 | 0.948 | 0.111 | 0.444
CON-00001226-000 | 23 | 1 | EA | CONN HEADER 3POS .100 SNGL SMD |  | X | SAMTEC | TSM-103-01-L-SV-P-TR |  | DIGIKEY |  | 2 |  | 325 |  |  |  |  | USD | USD |  | 0.58 | 0.58 | 0.58 | 0.58 | 0.58 | 0.58
CON-00001150-000 | 24 | 1 | EA | CONN HEADER 3MM 2POS R/A TIN |  | X | TE CONNEC | 2-1445055-2 |  | DIGIKEY |  | 14 | 2566 | 50 |  |  |  |  | USD | USD |  | 0.607 | 0.607 | 0.58 | 0.58 | 0.475 | 0.475
CON-00001227-000 | 25 | 1 | EA | CONN HEADER PH SIDE 2POS 2MM SMD |  | X | JST | S2B-PH-SM4-TB(LF)(SN) |  | DIGIKEY |  | 14 | 196000 | 50 |  |  |  |  | USD | USD |  | 0.4168 | 0.4168 | 0.3994 | 0.3994 | 0.34734 | 0.34734
CON-00001228-000 | 26 | 1 | EA | CONN UUSB AB REC TOPMT FLANGE TH GRAY |  | X | MOLEX | 47590-1001 | 47590-1001 | MOUSER ELE |  | 18 | 11779 | 1 | N/A |  |  | QUOTE VALID FOR 30 DAYS - USB CONNECTORS UUSB AB REC TOPMT FLANGE TH GRAY 0.60 | USD | USD |  | 0.822 | 0.822 | 0.708 | 0.708 | 0.517 | 0.517
CON-00001229-000 | 27 | 1 | EA | CONN SOCKET MEMORY PCI-E 8H TYPE I PKG G/F 52P |  | X | TE CONNEC | 1759503-1 |  | ARROW |  | 6 | 1200 | 2400 | FOB |  |  |  | USD | USD |  | 1.77 | 1.77 | 1.77 | 1.77 | 1.77 | 1.77
CON-00001230-000 | 28 | 1 | EA | CONN SIM CARD PUSH-PUSH R/A SMD |  | X | WURTH | 693 013 050 811 | 6.93E+11 | MOUSER ELE |  | 6 | 807 | 1 | N/A |  |  | QUOTE VALID FOR 30 DAYS - MEMORY CARD CONNECTORS WR-CRD MEGA SIM CARD 8PIN PUSH & PUSH | USD | USD |  | 3.03 | 3.03 | 2.48 | 2.48 | 2.48 | 2.48
CON-00000134-000 | 29 | 1 | EA | CONN MICRO SD R/A PUSH-PUSH SMD |  | X | HIROSE | DM3AT-SF-PEJM5 |  | DIGIKEY |  | 8 | 12647 | 50 |  |  |  |  | USD | USD |  | 2.3798 | 2.3798 | 2.2664 | 2.2664 | 1.92648 | 1.92648
CON-00001471-000 | 30 | 1 | EA | CONN HEADER 6POS .100 SGL HRZ SMD |  | X | SAMTEC | TSM-106-02-L-SH-P-TR |  | SAMTEC |  | 2 |  | 125 | FCA |  |  |  | USD | USD |  | 0.3 | 0.3 | 0.3 | 0.3 | 0.3 | 0.3
CON-00001307-000 | 31 | 2 | EA | CONN UMC JACK STR 50 OHM SMD |  | X | HIROSE | U.FL-R-SMT-1 (10) |  | DIGIKEY |  | 18 | 107993 | 100 |  |  |  |  | USD | USD |  | 0.9922 | 1.9844 | 0.9922 | 1.9844 | 0.7216 | 1.4432
IND-00001233-000 | 32 | 1 | EA | FIXED POWER IND 2.2UH 20% 8A |  | X | COILCRAFT | XFL4020-222MEB |  | COILCRAFT |  | 8 | 3269 | 100 | FCA |  |  |  | USD | USD |  | 1.85 | 1.85 | 1.55 | 1.55 | 0.75 | 0.75
IND-00001234-000 | 33 | 1 | EA | INDUCTOR 1UH 20% 11A FIXED PWR COMPOS |  | X | COILCRAFT | XFL4020-102MEC | XFL4020-102MEB | COILCRAFT |  | 8 | 266 | 100 | FCA |  |  |  | USD | USD |  | 1.85 | 1.85 | 1.55 | 1.55 | 0.75 | 0.75
IND-00001235-000 | 34 | 4 | EA | FIXED IND 10UH 300MA 600 MOHM |  | X | TDK | MLZ1608N100LT000 |  | DIGIKEY |  | 10 | 42905 | 100 |  |  |  |  | USD | USD |  | 0.105 | 0.42 | 0.105 | 0.42 | 0.078 | 0.312
IND-00001268-000 | 35 | 3 | EA | FIXED IND 2.2UH 1.3A 80 MOHM SMD |  | X | MURATA | LQM2HPN2R2MG0L |  | DIGIKEY |  | 7 | 134373 | 100 |  |  |  |  | USD | USD |  | 0.2217 | 0.6651 | 0.2046 | 0.6138 | 0.15686 | 0.47058
IND-00001269-000 | 36 | 3 | EA | FERRITE CHIP 180OHM 1500MA 0603 |  | X | MURATA | BLM18PG181SN1D |  | DIGIKEY |  | 6 | 143781 | 100 |  |  |  |  | USD | USD |  | 0.0501 | 0.1503 | 0.03644 | 0.10932 | 0.02884 | 0.08652
IND-00001270-000 | 37 | 2 | EA | IND .47UH 5.5A XFL4012 |  | X | COILCRAFT | XFL4012-471MEC |  | COILCRAFT |  | 8 | 376 | 1 | FCA |  |  |  | USD | USD |  | 1.23 | 2.46 | 1.23 | 2.46 | 0.68 | 1.36
IND-00001272-000 | 38 | 1 | EA | FIXED IND 2.2NH 220MA 300 MOHM |  | X | MURATA | LQP15MN2N2B02D |  | DIGIKEY |  | 8 | 165297 | 50 |  |  |  |  | USD | USD |  | 0.1302 | 0.1302 | 0.1169 | 0.1169 | 0.1002 | 0.1002
IND-00001472-000 | 39 | 1 | EA | FIXED IND 4.7NH 160MA 600 MOHM |  | X | MURATA | LQP15MN4N7B02D |  | DIGIKEY |  | 8 | 92971 | 50 |  |  |  |  | USD | USD |  | 0.1302 | 0.1302 | 0.1169 | 0.1169 | 0.1002 | 0.1002
ICS-00001274-000 | 40 | 5 | EA | IC,MOSFET N-CH 20V 4.2A SOT-23 |  | X | IR | IRLML2502TRPBF |  | DIGIKEY |  | 12 | 55266 | 250 |  |  |  |  | USD | USD |  | 0.131 | 0.655 | 0.11784 | 0.5892 | 0.11031 | 0.55155
ICS-00001473-000 | 41 | 1 | EA | IC MOSFET P-CH 30V 3.6A SOT-23-3 |  | X | IR | IRLML9301TRPBF |  | DIGIKEY |  | 14 | 19399 | 50 |  |  |  |  | USD | USD |  | 0.2306 | 0.2306 | 0.2062 | 0.2062 | 0.16864 | 0.16864
RES-00000048-000 | 42 | 1 | EA | RES 15K OHM 1/20W 1% 0201 SMD |  | X | PANASONIC | ERJ-1GEF1502C |  | DIGIKEY |  | 8 | 195230 | 50 |  |  |  |  | USD | USD |  | 0.0316 | 0.0316 | 0.0234 | 0.0234 | 0.01426 | 0.01426
RES-00000039-000 | 43 | 29 | EA | RES 10K OHM 1/20W 1% 0201 SMD |  | X | KOA | RK73H1HTTC1002F | RK73H1HTTC1002F | MOUSER ELE |  | 11 | 165247 | 1 | N/A |  |  | QUOTE VALID FOR 30 DAYS - THICK FILM RESISTORS - SMD 10K OHM 1% | USD | USD |  | 0.011 | 0.319 | 0.011 | 0.319 | 0.009 | 0.261
RES-00001275-000 | 44 | 8 | EA | RES 2K OHM 1/20W 1% 0201 SMD |  | X | PANASONIC | ERJ-1GEF2001C |  | DIGIKEY |  | 8 | 180974 | 250 |  |  |  |  | USD | USD |  | 0.01784 | 0.14272 | 0.01426 | 0.11408 | 0.01049 | 0.08392
RES-00001474-000 | 45 | 1 | EA | RES SMD 4.32K OHM 1% 1/20W 0201 |  | X | PANASONIC | ERJ1GEF4321C |  | DIGIKEY |  | 14 | 39030 | 50 |  |  |  |  | USD | USD |  | 0.0316 | 0.0316 | 0.0234 | 0.0234 | 0.0143 | 0.0143
RES-00000684-000 | 46 | 1 | EA | RES 20K OHM 1/20W 1% 0201 SMD |  | X | PANASONIC | ERJ-1GEF2002C |  | DIGIKEY |  | 8 | 386762 | 50 |  |  |  |  | USD | USD |  | 0.0316 | 0.0316 | 0.0234 | 0.0234 | 0.01426 | 0.01426
RES-00001278-000 | 47 | 1 | EA | THERMISTOR NTC 10K OHM 1% 0402 |  | X | PANASONIC | ERT-J0EG103FA |  | DIGIKEY |  | 6 | 5005 | 50 |  |  |  |  | USD | USD |  | 0.342 | 0.342 | 0.2342 | 0.2342 | 0.19722 | 0.19722
RES-00001279-000 | 48 | 1 | EA | RES 267 OHM 1/20W 1% 0201 SMD |  | X | PANASONIC | ERJ-1GEF2670C |  | DIGIKEY |  | 8 | 45663 | 50 |  |  |  |  | USD | USD |  | 0.0316 | 0.0316 | 0.0234 | 0.0234 | 0.01426 | 0.01426
RES-00000041-000 | 49 | 5 | EA | RES 1K OHM 1/20W 1% 0201 SMD |  | X | KOA | RK73H1HTTC1001F | RK73H1HTTC1001F | MOUSER ELE |  | 11 | 46356 | 1 | N/A |  |  | QUOTE VALID FOR 30 DAYS - THICK FILM RESISTORS - SMD 1/20W 1K OHM 1% 200PPM | USD | USD |  | 0.017 | 0.085 | 0.017 | 0.085 | 0.011 | 0.055
RES-00000053-000 | 50 | 5 | EA | RES 200 OHM 1/20W 1% 0201 SMD |  | X | PANASONIC | ERJ-1GEF2000C |  | DIGIKEY |  | 8 | 151292 | 250 |  |  |  |  | USD | USD |  | 0.01784 | 0.0892 | 0.01426 | 0.0713 | 0.01049 | 0.05245
RES-00001280-000 | 51 | 1 | EA | RES 374 OHM 1/20W 1% 0201 SMD |  | X | PANASONIC | ERJ-1GEF3740C |  | DIGIKEY |  | 8 | 32427 | 50 |  |  |  |  | USD | USD |  | 0.0316 | 0.0316 | 0.0234 | 0.0234 | 0.01426 | 0.01426
RES-00001281-000 | 52 | 1 | EA | RES 1.27K OHM 1/20W 1% 0201 SMD |  | X | PANASONIC | ERJ-1GEF1271C |  | DIGIKEY |  | 8 | 43165 | 50 |  |  |  |  | USD | USD |  | 0.0316 | 0.0316 | 0.0234 | 0.0234 | 0.01426 | 0.01426
RES-00001478-000 | 53 | 1 | EA | RES SMD 33.2K OHM 1% 1/20W 0201 |  | X | PANASONIC | ERJ1GEF3322C |  | DIGIKEY |  | 14 | 70498 | 50 |  |  |  |  | USD | USD |  | 0.0316 | 0.0316 | 0.0234 | 0.0234 | 0.0143 | 0.0143
RES-00000045-000 | 54 | 13 | EA | RES 100K OHM 1/20W 1% 0201 SMD |  | X | PANASONIC | ERJ-1GEF1003C |  | DIGIKEY |  | 8 | 5634508 | 500 |  |  |  |  | USD | USD |  | 0.01426 | 0.18538 | 0.01049 | 0.13637 | 0.00752 | 0.09776
RES-00000872-000 | 55 | 3 | EA | RES 1 OHM 1/10W 5% 0402 SMD |  | X | PANASONIC | ERJ-2GEJ1R0X |  | DIGIKEY |  | 6 | 291926 | 100 |  |  |  |  | USD | USD |  | 0.0078 | 0.0234 | 0.00596 | 0.01788 | 0.0035 | 0.0105
RES-00001282-000 | 56 | 3 | EA | RES 2.2 OHM 1/10W 5% 0402 SMD |  | X | PANASONIC | ERJ-2GEJ2R2X |  | DIGIKEY |  | 6 | 650460 | 100 |  |  |  |  | USD | USD |  | 0.0078 | 0.0234 | 0.00596 | 0.01788 | 0.0035 | 0.0105
RES-00000040-000 | 57 | 26 | EA | RES 49.9K OHM 1/20W 1% 0201 SMD |  | X | PANASONIC | ERJ-1GEF4992C |  | DIGIKEY |  | 8 | 1508030 | 1000 |  |  |  |  | USD | USD |  | 0.01049 | 0.27274 | 0.01049 | 0.27274 | 0.00752 | 0.19552
RES-00001283-000 | 58 | 3 | EA | RES 1.5K OHM 1/20W 1% 0201 SMD |  | X | PANASONIC | ERJ-1GEF1501C |  | DIGIKEY |  | 8 | 804079 | 100 |  |  |  |  | USD | USD |  | 0.0234 | 0.0702 | 0.01784 | 0.05352 | 0.01049 | 0.03147
RES-00001284-000 | 59 | 1 | EA | RES 5.62K OHM 1/20W 1% 0201 SMD |  | X | PANASONIC | ERJ-1GEF5621C |  | DIGIKEY |  | 8 | 26637 | 50 |  |  |  |  | USD | USD |  | 0.0316 | 0.0316 | 0.0234 | 0.0234 | 0.01426 | 0.01426
RES-00000148-000 | 60 | 2 | EA | RES 0.0 OHM 1/8W JUMP 0805 SMD |  | X | YAGEO | RC0805FR-070RL |  | DIGIKEY |  | 20 | 162017 | 100 |  |  |  |  | USD | USD |  | 0.0099 | 0.0198 | 0.0099 | 0.0198 | 0.00443 | 0.00886
RES-00000043-000 | 61 | 18 | EA | RES 0.0 OHM 1/20W JUMP 0201 SMD |  | X | YAGEO | RC0201JR-070RL |  | DIGIKEY |  | 20 | 1136671 | 500 |  |  |  |  | USD | USD |  | 0.0109 | 0.1962 | 0.00802 | 0.14436 | 0.00575 | 0.1035
RES-00001479-000 | 62 | 1 | EA | RES SMD 140 OHM 1% 1/20W 0201 |  | X | PANASONIC | ERJ1GEF1400C |  | DIGIKEY |  | 14 | 65631 | 50 |  |  |  |  | USD | USD |  | 0.0316 | 0.0316 | 0.0234 | 0.0234 | 0.0143 | 0.0143
RES-00001480-000 | 63 | 4 | EA | RES SMD 84.5 OHM 1% 1/20W 0201 |  | X | PANASONIC | ERJ1GEF84R5C |  | DIGIKEY |  | 14 | 68353 | 100 |  |  |  |  | USD | USD |  | 0.0234 | 0.0936 | 0.0178 | 0.0712 | 0.01 | 0.04
RES-00001285-000 | 64 | 6 | EA | RES 4.7K OHM 1/20W 1% 0201 SMD |  | X | PANASONIC | ERJ-1GEF4701C |  | DIGIKEY |  | 8 | 398674 | 250 |  |  |  |  | USD | USD |  | 0.01784 | 0.10704 | 0.01426 | 0.08556 | 0.01049 | 0.06294
RES-00000050-000 | 65 | 1 | EA | RES 20 OHM 1/20W 1% 0201 SMD |  | X | PANASONIC | ERJ-1GEF20R0C |  | DIGIKEY |  | 8 | 30482 | 50 |  |  |  |  | USD | USD |  | 0.0316 | 0.0316 | 0.0234 | 0.0234 | 0.01426 | 0.01426
RES-00001481-000 | 66 | 2 | EA | RES SMD 402 OHM 1% 1/20W 0201 |  | X | PANASONIC | ERJ1GEF4020C |  | DIGIKEY |  | 14 | 55759 | 100 |  |  |  |  | USD | USD |  | 0.0234 | 0.0468 | 0.0234 | 0.0468 | 0.0105 | 0.021
RES-00001276-000 | 67 | 1 | EA | RES 5.49K OHM 1/20W 1% 0201 SMD |  | X | PANASONIC | ERJ-1GEF5491C |  | DIGIKEY |  | 8 | 39417 | 50 |  |  |  |  | USD | USD |  | 0.0316 | 0.0316 | 0.0234 | 0.0234 | 0.01426 | 0.01426
RES-00001482-000 | 68 | 1 | EA | RES SMD 576 OHM 1% 1/20W 0201 |  | X | PANASONIC | ERJ1GEF5760C |  | DIGIKEY |  | 14 | 120378 | 50 |  |  |  |  | USD | USD |  | 0.0316 | 0.0316 | 0.0234 | 0.0234 | 0.0143 | 0.0143
ELC-00001286-000 | 69 | 1 | EA | SWITCH PUSH SPDT 0.2A 30V |  | X | C&K | PN12SJNA03QE |  | DIGIKEY |  | 8 | 2067 | 50 |  |  |  |  | USD | USD |  | 0.76 | 0.76 | 0.74 | 0.74 | 0.578 | 0.578
ELC-00000526-002 | 70 | 1 | EA | SWITCH TACTILE SPST-NO 0.05A 12V |  | X | PANASONIC | EVQPUK02K |  | DIGIKEY |  | 14 | 5389 | 50 |  |  |  |  | USD | USD |  | 0.5618 | 0.5618 | 0.538 | 0.538 | 0.3862 | 0.3862
ICS-00001287-000 | 71 | 1 | EA | IC BATT CHARGE MGMT 24VQFN |  | X | TI | BQ24196RGET |  | DIGIKEY |  | 6 | 670 | 50 |  |  |  |  | USD | USD |  | 5.01 | 5.01 | 4.77 | 4.77 | 3.29 | 3.29
ICS-00001288-000 | 72 | 1 | EA | IC LOAD SW FULL FUNCT ADJ 6MLP |  | X | FAIRCHILD | FPF2165R |  | DIGIKEY |  | 6 | 12448 | 50 |  |  |  |  | USD | USD |  | 1.0312 | 1.0312 | 0.9022 | 0.9022 | 0.70168 | 0.70168
ICS-00001289-000 | 73 | 1 | EA | IC REG LDO ADJ 0.15A 6MLF |  | X | MICREL | MIC5305YML |  | DIGIKEY |  | 16 | 14970 | 25 |  |  |  |  | USD | USD |  | 0.7776 | 0.7776 | 0.6804 | 0.6804 | 0.5292 | 0.5292
ICS-00001290-000 | 74 | 1 | EA | IC REG BOOST SYNC 5V 5A 10SON |  | X | TI | TPS61232DRCT | TPS61232DRCT | MOUSER ELE |  | 6 | 6332 | 1 | N/A |  |  | QUOTE VALID FOR 30 DAYS - VOLTAGE REGULATORS - SWITCHING REGULATORS HIGH EFF SYNC STEP UP CONVERTER | USD | USD |  | 2.55 | 2.55 | 2.43 | 2.43 | 1.97 | 1.97
ICS-00001291-000 | 75 | 1 | EA | IC POT DGTL 32TAP NV TSOT23-6 |  | X | MAXIM | MAX5434LEZT+T |  | DIGIKEY |  | 8 | 28309 | 50 |  |  |  |  | USD | USD |  | 1.2598 | 1.2598 | 1.1603 | 1.1603 | 1.0608 | 1.0608
ICS-00001292-000 | 76 | 1 | EA | IC PMU CONV/LDO REG 32TQFN |  | X | ACTIVE SEM | ACT8865QI305-T |  | DIGIKEY |  | 16 | 12599 | 50 |  |  |  |  | USD | USD |  | 2.3452 | 2.3452 | 2.1089 | 2.1089 | 1.6362 | 1.6362
ICS-00001293-000 | 77 | 1 | EA | IC REG LDO 3.3V 0.15A SOT23 |  | X | DIODES | AP2120N-3.3TRG1 |  | DIGIKEY |  | 9 | 3763 | 50 |  |  |  |  | USD | USD |  | 0.2388 | 0.2388 | 0.1807 | 0.1807 | 0.10228 | 0.10228
ICS-00001294-000 | 78 | 1 | EA | IC MCU 32BIT 160KB FLASH 324BGA |  | X | ATMEL | ATSAMA5D31A-CUR |  | DIGIKEY |  | 7 | 7137 | 50 |  |  |  |  | USD | USD |  | 12.1188 | 12.1188 | 11.1038 | 11.1038 | 9.20026 | 9.20026
ICS-00001295-000 | 79 | 2 | EA | IC DDR2 SDRAM 1GBIT 2.5NS 84FBGA |  | X | MICRON | MT47H64M16HR-25E:H TR | MT47H64M16NF-25E:M | DIGIKEY |  | 20 | 0 | 1000 |  |  |  |  | USD | USD |  | 3.3 | 6.6 | 3.3 | 6.6 | 3.3 | 6.6
ICS-00001308-000 | 80 | 2 | EA | IC BUS TRANSCVR 4BIT 16-UQFN |  | X | TI | SN74AVC4T245RSVR |  | DIGIKEY |  | 12 | 22415 | 100 |  |  |  |  | USD | USD |  | 0.71 | 1.42 | 0.71 | 1.42 | 0.495 | 0.99
ICS-00001298-000 | 81 | 2 | EA | IC REG BUCK SYNC 3.3V 3A 16QFN |  | X | TI | TPS62091RGTT | TPS62091RGTT | MOUSER ELE |  | 6 | 939 | 1 | N/A |  |  | QUOTE VALID FOR 30 DAYS - VOLTAGE REGULATORS - SWITCHING REGULATORS 3A,2.5-6VIN,97% EFF SYNC SD CONVERTER | USD | USD |  | 2.26 | 4.52 | 2.26 | 4.52 | 1.22 | 2.44
ELC-00001299-000 | 82 | 1 | EA | MODULE WIFI WILINK |  | X | TI | WL1835MODGBMOCT |  | DIGIKEY |  | 10 | 974 | 50 |  |  |  |  | USD | USD |  | 21.69 | 21.69 | 21.24 | 21.24 | 17.88002 | 17.88002
ICS-00001309-000 | 83 | 1 | EA | IC XLATR VOLT-LVL 8B BDIR 20QFN |  | X | TI | TXS0108ERGYR |  | DIGIKEY |  | 2 | 6325 | 50 |  |  |  |  | USD | USD |  | 1.69 | 1.69 | 1.67 | 1.67 | 1.26 | 1.26
ICS-00001303-000 | 84 | 1 | EA | IC EEPROM 2KBIT 400KHZ TSOT23-5 |  | X | ON | CAT24AA02TDI-GT3 |  | DIGIKEY |  | 15 | 21947 | 50 |  |  |  |  | USD | USD |  | 0.2908 | 0.2908 | 0.2368 | 0.2368 | 0.16204 | 0.16204
ICS-00001310-000 | 85 | 1 | EA | IC BUFF/DVR NON-INVERT SC705 |  | X | TI | SN74AUC1G07DCKR |  | DIGIKEY |  | 6 | 10662 | 50 |  |  |  |  | USD | USD |  | 0.33 | 0.33 | 0.155 | 0.155 | 0.155 | 0.155
ICS-00001476-000 | 86 | 1 | EA | IC USB FS SERIAL UART 32-QFN |  | X | FTDI | FT232RQ-REEL |  | DIGIKEY |  | 12 | 88474 | 50 |  |  |  |  | USD | USD |  | 3.85 | 3.85 | 3.65 | 3.65 | 2.85 | 2.85
OSC-00001304-000 | 87 | 1 | EA | OSC XO 32.768KHZ CMOS SMD |  | X | TXC | 7XZ-32.768KDA-T |  | DIGIKEY |  | 14 | 8414 | 50 |  |  |  |  | USD | USD |  | 2.3814 | 2.3814 | 2.0866 | 2.0866 | 2.02986 | 2.02986
XTL-00001305-000 | 88 | 1 | EA | CRYSTAL 12MHZ 12PF SMD |  | X | EPSON | FA-238V 12.0000MB-W3 |  | DIGIKEY |  | 10 | 5480 | 50 |  |  |  |  | USD | USD |  | 0.904 | 0.904 | 0.8 | 0.8 | 0.612 | 0.612
XTL-00000186-003 | 89 | 1 | EA | CRYSTAL 32.768KHZ 12.5PF SMD |  | X | SEIKO | SSPT7F-12.5PF20-R |  | DIGIKEY |  | 10 | 22567 | 50 |  |  |  |  | USD | USD |  | 0.472 | 0.472 | 0.42 | 0.42 | 0.4 | 0.4
PCB-00001143-002 | 90 | 1 | EA | PCB,(FAB),FMC,MAIN,OPENXC |  | X | HALLCIRCT | PCB-00001143-001 |  | HALLCIRCT |  | 5 |  | 50 |  |  |  |  | USD | USD |  | 90.93 | 90.93 | 68.75 | 68.75 | 23.85 | 23.85
RES-00001597-000 | 91 | 1 | EA | RES SMD 2.15K OHM 1% 1/20W 0201 |  | X | PANASONIC | ERJ-1GNF2151C | ERJ-1GNF2151C | MOUSER ELE |  | 10 | 0 | 1 | N/A |  |  | QUOTE VALID FOR 30 DAYS - THICK FILM RESISTORS - SMD 0201 2.15KOHM 1% HALOGEN FREE | USD | USD |  | 0.041 | 0.041 | 0.017 | 0.017 | 0.017 | 0.017
RES-00001598-000 | 92 | 1 | EA | RES SMD 7.5K OHM 1% 1/20W 0201 |  | X | PANASONIC | ERJ-1GNF7501C | ERJ-1GNF7501C | MOUSER ELE |  | 10 | 27400 | 1 | N/A |  |  | QUOTE VALID FOR 30 DAYS - THICK FILM RESISTORS - SMD 0201 7.5KOHM 1% HALOGEN FREE | USD | USD |  | 0.04 | 0.04 | 0.017 | 0.017 | 0.017 | 0.017
RES-00001599-000 | 93 | 1 | EA | RES SMD 41.2K OHM 1% 1/20W 0201 |  | X | PANASONIC | ERJ-1GNF4122C | ERJ-1GNF4122C | MOUSER ELE |  | 8 | 15618 | 1 | N/A |  |  | QUOTE VALID FOR 30 DAYS - THICK FILM RESISTORS - SMD 0201 41.2KOHM 1% HALOGEN FREE | USD | USD |  | 0.04 | 0.04 | 0.017 | 0.017 | 0.017 | 0.017
ICS-00001593-000 | 94 | 1 | EA | IC FLASH 4GBIT 48TSOP |  | X | MICRON | MT29F4G08ABADAWP:D TR |  | DIGIKEY |  | 12 | 2650 | 50 |  |  |  |  | USD | USD |  | 5.452 | 5.452 | 4.8906 | 4.8906 | 4.56856 | 4.56856
DWG-00001143-002-PCA | 95 | 0 | EA | DWG,PCA,FMC,MAIN,OPENXC |  | X | REFERENCE | DWG-00001143-002-PCA |  | REFERENCE |  |  |  |  |  |  |  |  | USD | USD |  | 0 | 0
DWG-00001143-002-SCH | 96 | 0 | EA | DWG,SCHEMATIC,FMC,MAIN,OPENXC |  | X | REFERENCE | DWG-00001143-002-SCH |  | REFERENCE |  |  |  |  |  |  |  |  | USD | USD |  | 0 | 0
PCA-00001143-002-BOMCHECKER | 97 | 0 | EA | BOMCHECKER |  | X | REFERENCE | PCA-00001143-002-BOMCHECKER |  | REFERENCE |  |  |  |  |  |  |  |  | USD | USD |  | 0 | 0
PCA-00001143-002-CADMATCHER | 98 | 0 | EA | CADMATCHER |  | X | REFERENCE | PCA-00001143-002-CADMATCHER |  | REFERENCE |  |  |  |  |  |  |  |  | USD | USD |  | 0 | 0
PCA-00001143-002-FABMASTER | 99 | 0 | EA | FABMASTER |  | X | REFERENCE | PCA-00001143-002-FABMASTER |  | REFERENCE |  |  |  |  |  |  |  |  | USD | USD |  | 0 | 0
PCA-00001143-002-ORIGINAL BOM | 100 | 0 | EA | ORIGINAL BOM |  | X | REFERENCE | PCA-00001143-002-ORIGINAL BOM |  | REFERENCE |  |  |  |  |  |  |  |  | USD | USD |  | 0 | 0
PCA-00001143-002-PI | 101 | 0 | EA | PROCESS INSTRUCTIONS |  | X | REFERENCE | PCA-00001143-002-PI |  | REFERENCE |  |  |  |  |  |  |  |  | USD | USD |  | 0 | 0
PCA-00001143-002-QA | 102 | 0 | EA | QUALITY ASSURANCE |  | X | REFERENCE | PCA-00001143-002-QA |  | REFERENCE |  |  |  |  |  |  |  |  | USD | USD |  | 0 | 0
PCA-00001143-002-SMT PROGRAM | 103 | 0 | EA | SMT PROGRAM |  | X | REFERENCE | PCA-00001143-002-SMT PROGRAM |  | REFERENCE |  |  |  |  |  |  |  |  | USD | USD |  | 0 | 0
PCA-00001143-002-VISUAL AIDE | 104 | 0 | EA | VISUAL AIDE |  | X | REFERENCE | PCA-00001143-002-VISUAL AIDE |  | REFERENCE |  |  |  |  |  |  |  |  | USD | USD |  | 0 | 0
 |  |  |  |  |  |  |  |  |  |  |  |  |  |  |  |  |  |  |  |  |  |  | 221.02566 |  | 189.0959 |  | 121.59786
*** Assembly: TLA-00001300-002 ATTRITION rev 1 Line #2
Part Number | Line | Part Qty | Unit | Description | Commodity | AML | Mfg ID | Mfg Part Number | Corrected MPN | Supp ID | No Bid | Lead Time | Inventory | MOQ | Delivery Terms | NCNR | Short Comment | Long Comment | Raw Currency | Currency | NRE Charge | Cost #1 | Ext Cost #1 | Cost #2 | Ext Cost #2 | Cost #3 | Ext Cost #3 | Ownership
ELC-00001321-000 | 1 | 0 | EA | MODULE,3G,MINI PCIE |  | X | TELIT | HEPCIGPS204T701 |  | ARROW |  | 7 | 498 | 3 | FOB |  |  |  | USD | USD |  | 87.52 | 0 | 87.52 | 0 | 81.14 | 0
ELC-00001327-000 | 2 | 0 | EA | PCA,ANTENNA BOARD,FMC OPENXC |  |  | WORLDPROD | WPANT10074-C2A |  | WPG |  | 16 | 100 | 100 |  |  |  |  | USD | USD |  | 2.48 | 0 | 2.48 | 0 | 2.48 | 0
ELC-00001836-000 | 3 | 0 | EA | 12 * 12 * 2MM PASSIVE GPS ANTENNA CABLE LENGTH 70MM |  | X | ISSUE | ELC-00001836-000 |  | ISSUE |  |  |  |  |  |  |  |  | USD | USD |  | 0 | 0
ELC-00001847-000 ATTRITION | 4 | 1 |  | BATTERY SUBASSEMBLY |  |  |  |  |  |  |  |  |  |  |  |  |  |  |  | USD |  | 0 | 0 | 0 | 0 | 0 | 0
HWR-00001311-000 | 5 | 5 | EA | ROUND SPACER 0.105 NYLON 5.46MM |  | X | BIVAR | 907-215 | 907-215 | MOUSER ELE |  | 4 | 3000 | 1 | N/A |  |  | QUOTE VALID FOR 30 DAYS - STANDOFFS & SPACERS PLASTIC SPCR .215 IN NYLON WHITE | USD | USD |  | 0.051 | 0.255 | 0.051 | 0.255 | 0.034 | 0.17
HWR-00001312-000 | 6 | 5 | EA | 18-8 STAINLESS STEEL METRIC PAN HEAD PHILLIPS MACHINE SCREW |  | X | MCMASTER | 92000A019 |  | MCMASTER |  | 4 | 2000 | 100 |  |  |  |  | USD | USD |  | 0.0476 | 0.238 | 0.0476 | 0.238 | 0.0476 | 0.238
HWR-00001314-000 | 7 | 5 | EA | SCR,METRIC 18-8 SS PAN HD PHIL MACHINE W/WASHER M2.5 X 8MM LONG |  | X | MCMASTER | 90317A105 |  | MCMASTER |  | 4 | 5000 | 25 |  |  |  |  | USD | USD |  | 0.328 | 1.64 | 0.328 | 1.64 | 0.328 | 1.64
HWR-00001317-000 | 8 | 5 | EA | SCR,18-8 SS FLAT HEAD PHILLIPS BLACK OXIDE, M2 X 10MM LONG |  | X | MCMASTER | 91698A206 |  | MCMASTER |  | 4 | 4000 | 100 |  |  |  |  | USD | USD |  | 0.0992 | 0.496 | 0.0992 | 0.496 | 0.0992 | 0.496
HWR-00001489-000 | 9 | 5 | EA | WASHER,LOCK,SPLIT,18-8 SS,M2 SCREW SIZE,2.4MM ID,4.4MM OD |  | X | MCMASTER | 92148A050 |  | MCMASTER |  | 4 | 2000 | 100 |  |  |  |  | USD | USD |  | 0.0118 | 0.059 | 0.0118 | 0.059 | 0.0118 | 0.059
HWR-00001490-000 | 10 | 5 | EA | NUT,HIGH HEX,STEEL,ZINC,LOW-STRENGTH,M2X0.4 THREAD,4MM WIDE,2MM HIGH |  | X | MCMASTER | 90725A010 |  | MCMASTER |  | 4 | 2000 | 25 |  |  |  |  | USD | USD |  | 0.3128 | 1.564 | 0.3128 | 1.564 | 0.3128 | 1.564
HWR-00001491-000 | 11 | 5 | IN | TAPE,FOAM,3M VHB,ADHESIVE ON BOTH SIDES,#4926,3/4 W X 72 YARDS L, .015 THICK |  | X | MCMASTER | 8127A72 |  | MCMASTER |  | 4 | 50000 | 2592 |  |  |  | PRICE FOR EACH INCHE | USD | USD |  | 0.0757 | 0.3785 | 0.0757 | 0.3785 | 0.0757 | 0.3785
HWR-00001492-000 | 12 | 5 | EA | TIE,CABLE,NYLON,4 LONG, 7/8 BUNDLE DIAMETER,10 LB. BREAK STRENGTH, BLACK |  | X | MCMASTER | 7130K52 |  | MCMASTER |  | 4 | 2000 | 100 |  |  |  |  | USD | USD |  | 0.0243 | 0.1215 | 0.0243 | 0.1215 | 0.0243 | 0.1215
HWR-00001493-000 | 13 | 0 | EA | ADHESIVE,J-B WELD,50112, QUICK SETTING, 0.85 OUNCE SYRINGE |  | X | MCMASTER | 7605A18 |  | MCMASTER |  | 4 | 100 | 1 |  |  |  | PRICE FOR BOTTLE OF 0.85 OUNCE | USD | USD |  | 5.74 | 0 | 5.74 | 0 | 5.74 | 0
LBL-00001884-000 | 14 | 0 | EA | LABEL,OPENXC MODEM,1.5 INCH WIDE X .4 INCH HIGH |  | X | ISSUE | LBL-00001884-000 |  | ISSUE |  |  |  |  |  |  |  |  | USD | USD |  | 0 | 0
MCH-00001323-000 | 15 | 0 | EA | TOP HOUSING,INJECTION MOLDED, FMC OPENXC MODEM |  | X | CONSIGN | MCH-00001323-000 |  | CONSIGNED |  |  |  |  |  |  |  |  | USD | USD |  | 0 | 0
MCH-00001324-000 | 16 | 0 | EA | BOTTOM HOUSING,INJECTION MOLDED, FMC OPENXC MODEM |  | X | CONSIGN | MCH-00001324-000 |  | CONSIGNED |  |  |  |  |  |  |  |  | USD | USD |  | 0 | 0
MCH-00001326-000 | 17 | 0 | EA | BUTTON,INJECTION MOLDED, FMC OPENXC MODEM |  | X | CONSIGN | MCH-00001326-000 |  | CONSIGNED |  |  |  |  |  |  |  |  | USD | USD |  | 0 | 0
MCH-00001837-000 | 18 | 0 | EA | FERRITE COVER FOR PCB-NEC/TOKIN FLEX SUPPRESSOR EFF(03) T0800 |  | X | KEMET | EFF(03)-240X240T0800 |  | DIGIKEY |  | 18 |  | 10 |  |  |  |  | USD | USD |  | 85.74 | 0 | 85.74 | 0 | 82.5088 | 0
MCH-00001842-000 | 19 | 0 | EA | CUSTOM PART: BATTERY LIGHT PIPE-INJECTION MOLDED |  | X | CONSIGN | MCH-00001842-000 |  | CONSIGNED |  |  |  |  |  |  |  |  | USD | USD |  | 0 | 0
MCH-00001843-000 | 20 | 0 | EA | CUSTOM PART:BLUETOOTH LIGHT PIPE-INJECTION MOLDED |  | X | CONSIGN | MCH-00001843-000 |  | CONSIGNED |  |  |  |  |  |  |  |  | USD | USD |  | 0 | 0
MCH-00001844-000 | 21 | 0 | EA | CUSTOM PART: 3G LIGHT PIPE-INJECTION MOLDED |  | X | CONSIGN | MCH-00001844-000 |  | CONSIGNED |  |  |  |  |  |  |  |  | USD | USD |  | 0 | 0
MCH-00001845-000 | 22 | 0 | EA | CUSTOM PART: GPS LIGHT PIPE-INJECTION MOLDED |  | X | CONSIGN | MCH-00001845-000 |  | CONSIGNED |  |  |  |  |  |  |  |  | USD | USD |  | 0 | 0
MCH-00001846-000 | 23 | 0 | EA | CUSTOM PART: WIFI LIGHT PIPE-INJECTION MOLDED |  | X | CONSIGN | MCH-00001846-000 |  | CONSIGNED |  |  |  |  |  |  |  |  | USD | USD |  | 0 | 0
PCA-00001143-002 ATTRITION | 24 | 1 |  | PCA,FMC,MAIN,OPENXC |  |  |  |  |  |  |  |  |  |  |  |  |  |  |  | USD |  | 614.087 | 614.087 | 542.2965 | 542.2965 | 390.1558 | 390.1558
SWR-00001994-000 | 25 | 0 | EA | XCMODEM-UPGRADE-0.14.MD5 |  | X | REFERENCE | SWR-00001994-000 |  | REFERENCE |  |  |  |  |  |  |  |  | USD | USD |  | 0 | 0
SWR-00001995-000 | 26 | 0 | EA | SAMA5D3_XPLAINED-V1.1 |  | X | REFERENCE | SWR-00001995-000 |  | REFERENCE |  |  |  |  |  |  |  |  | USD | USD |  | 0 | 0
TLA-00001300-002-BOMCHECKER | 27 | 0 | EA | BOMCHECKER |  | X | REFERENCE | TLA-00001300-002-BOMCHECKER |  | REFERENCE |  |  |  |  |  |  |  |  | USD | USD |  | 0 | 0
TLA-00001300-002-ORIGINAL BOM | 28 | 0 | EA | ORIGINAL BOM |  | X | REFERENCE | TLA-00001300-002-ORIGINAL BOM |  | REFERENCE |  |  |  |  |  |  |  |  | USD | USD |  | 0 | 0
TLA-00001300-002-PI | 29 | 0 | EA | PROCESS INSTRUCTIONS |  | X | REFERENCE | TLA-00001300-002-PI |  | REFERENCE |  |  |  |  |  |  |  |  | USD | USD |  | 0 | 0
 |  |  |  |  |  |  |  |  |  |  |  |  |  |  |  |  |  |  |  |  |  |  | 618.839 |  | 547.0485 |  | 394.8228
*** Assembly: ELC-00001847-000 ATTRITION Line #2.4
Part Number | Line | Part Qty | Unit | Description | Commodity | AML | Mfg ID | Mfg Part Number | Corrected MPN | Supp ID | No Bid | Lead Time | Inventory | MOQ | Delivery Terms | NCNR | Short Comment | Long Comment | Raw Currency | Currency | NRE Charge | Cost #1 | Ext Cost #1 | Cost #2 | Ext Cost #2 | Cost #3 | Ext Cost #3 | Ownership
CON-00001851-000 | 1 | 0 | EA | CONN HOUSING PH 2POS 2MM WHITE |  | X | JST | PHR-2 |  | DIGIKEY |  | 14 | 191030 | 50 |  |  |  |  | USD | USD |  | 0.05 | 0 | 0.0484 | 0 | 0.04004 | 0
CON-00001852-000 | 2 | 0 | EA | CONN TERMINAL 28-24AWG TIN |  | X | JST | SPH-002T-P0.5L |  | DIGIKEY |  | 14 | 22349 | 100 |  |  |  |  | USD | USD |  | 0.0309 | 0 | 0.0309 | 0 | 0.02319 | 0
ELC-00001848-000 | 3 | 0 | EA | HIGH CAPACITY 3200MAH 3.8V LI-ION RECHARGEABLE |  | X | SAMSUNG | B800BU | EB-B800BUBESTA | SAMSUNG EM |  | 16 | 0 | 1 |  |  |  |  | USD | USD |  | 39.99 | 0 | 39.99 | 0 | 39.99 | 0
ELC-00001849-000 | 4 | 0 | EA | STRANDED WIRE, 300V AC, 24 GAUGE,BLACK |  |  | MCMASTER | 8054T22 |  | MCMASTER |  | 4 | 2000 | 127 |  |  |  | ROLL OF 25 FT | USD | USD |  | 0.025 | 0 | 0.025 | 0 | 0.025 | 0
ELC-00001850-000 | 5 | 0 | EA | STRANDED WIRE, 300V AC, 24 GAUGE,RED |  |  | MCMASTER | 8054T22-RED |  | MCMASTER |  | 4 |  | 127 |  |  |  | ROLL OF 25 FT | USD | USD |  | 0.025 | 0 | 0.025 | 0 | 0.025 | 0
 |  |  |  |  |  |  |  |  |  |  |  |  |  |  |  |  |  |  |  |  |  |  | 0 |  | 0 |  | 0
*** Assembly: PCA-00001143-002 ATTRITION Line #2.24
Part Number | Line | Part Qty | Unit | Description | Commodity | AML | Mfg ID | Mfg Part Number | Corrected MPN | Supp ID | No Bid | Lead Time | Inventory | MOQ | Delivery Terms | NCNR | Short Comment | Long Comment | Raw Currency | Currency | NRE Charge | Cost #1 | Ext Cost #1 | Cost #2 | Ext Cost #2 | Cost #3 | Ext Cost #3 | Ownership
ELC-00001205-000 | 1 | 0 | EA | ANTENNA WLAN DUALBAND CERAM CHIP |  | X | PULSE | W3006 |  | DIGIKEY |  | 6 | 2796 | 100 |  |  |  |  | USD | USD |  | 1.4848 | 0 | 1.4848 | 0 | 0.851 | 0
CAP-00001213-000 | 2 | 20 | EA | CAP CER 10UF 35V 10% X7R 1206 |  | X | SAMSUNG | CL31B106KLHNFNE |  | DIGIKEY |  | 13 | 3487 | 100 |  |  |  |  | USD | USD |  | 0.471 | 9.42 | 0.471 | 9.42 | 0.32665 | 6.533
CAP-00000023-000 | 3 | 60 | EA | CAP CER 4.7UF 10V 10% X5R 0402 |  | X | SAMSUNG | CL05A475KP5NRNC |  | DIGIKEY |  | 10 | 92941 | 500 |  |  |  |  | USD | USD |  | 0.20188 | 12.1128 | 0.1854 | 11.124 | 0.15244 | 9.1464
CAP-00000018-000 | 4 | 80 | EA | CAP CER 1UF 10V 20% X5R 0201 |  | X | SAMSUNG | CL03A105MP3NSNC |  | DIGIKEY |  | 13 | 1060904 | 1000 |  |  |  |  | USD | USD |  | 0.18127 | 14.5016 | 0.17198 | 13.7584 | 0.17198 | 13.7584
CAP-00001214-000 | 5 | 80 | EA | CAP CER 0.047UF 10V 10% X5R 0201 |  | X | SAMSUNG | CL03A473KP3NNNC |  | DIGIKEY |  | 10 | 13387 | 100 |  |  |  |  | USD | USD |  | 0.0856 | 6.848 | 0.0856 | 6.848 | 0.05199 | 4.1592
CAP-00001215-000 | 6 | 30 | EA | CAP CER 22UF 25V 20% X5R 0805 |  | X | SAMSUNG | CL21A226MAQNNNE |  | DIGIKEY |  | 10 | 492320 | 250 |  |  |  |  | USD | USD |  | 0.6 | 18 | 0.45 | 13.5 | 0.41 | 12.3
CAP-00001216-000 | 7 | 30 | EA | CAP CER 10UF 25V 10% X5R 0805 |  | X | SAMSUNG | CL21A106KAFN3NE |  | DIGIKEY |  | 10 | 92000 | 250 |  |  |  |  | USD | USD |  | 0.1024 | 3.072 | 0.06784 | 2.0352 | 0.06016 | 1.8048
CAP-00000020-000 | 8 | 60 | EA | CAP CER 10UF 10V 20% X5R 0402 |  | X | SAMSUNG | CL05A106MP5NUNC |  | DIGIKEY |  | 10 | 1365756 | 250 |  |  |  |  | USD | USD |  | 0.3021 | 18.126 | 0.22776 | 13.6656 | 0.18127 | 10.8762
CAP-00000024-000 | 9 | 80 | EA | CAP CER 0.1UF 10V 10% X5R 0201 |  | X | SAMSUNG | CL03A104KP3NNNC |  | DIGIKEY |  | 10 | 134292 | 1000 |  |  |  |  | USD | USD |  | 0.0081 | 0.648 | 0.00729 | 0.5832 | 0.00675 | 0.54
CAP-00000025-000 | 10 | 80 | EA | CAP CER 10000PF 10V 10% X5R 0201 |  | X | MURATA | GRM033R61A103KA01D |  | DIGIKEY |  | 10 | 1305112 | 250 |  |  |  |  | USD | USD |  | 0.009 | 0.72 | 0.0077 | 0.616 | 0.006 | 0.48
CAP-00001217-000 | 11 | 80 | EA | CAP CER 15PF 50V 5% NP0 0201 |  | X | MURATA | GRM0335C1H150JA01D |  | DIGIKEY |  | 18 | 352426 | 100 |  |  |  |  | USD | USD |  | 0.0107 | 0.856 | 0.0107 | 0.856 | 0.0057 | 0.456
CAP-00001218-000 | 12 | 80 | EA | CAP CER 20PF 25V 5% NP0 0201 |  | X | MURATA | GRM0335C1E200JA01D |  | DIGIKEY |  | 15 | 29288 | 100 |  |  |  |  | USD | USD |  | 0.0105 | 0.84 | 0.0105 | 0.84 | 0.0057 | 0.456
CAP-00000122-000 | 13 | 60 | EA | CAP CER 10PF 50V 2% NP0 0402 |  | X | MURATA | GRM1555C1H100GA01D |  | DIGIKEY |  | 10 | 66090 | 50 |  |  |  |  | USD | USD |  | 0.0312 | 1.872 | 0.0264 | 1.584 | 0.01848 | 1.1088
RES-00000102-000 | 14 | 60 | EA | RES,0R OHM,1/16W,0402 |  | X | YAGEO | RC0402JR-070RL |  | DIGIKEY |  | 20 | 8438507 | 50 |  |  |  |  | USD | USD |  | 0.0092 | 0.552 | 0.0053 | 0.318 | 0.0032 | 0.192
CAP-00001468-000 | 15 | 60 | EA | CAP CER 1.2PF 50V NP0 0402 |  | X | MURATA | GJM1555C1H1R2BB01D |  | DIGIKEY |  | 9 | 8252 | 50 |  |  |  |  | USD | USD |  | 0.0804 | 4.824 | 0.0664 | 3.984 | 0.04682 | 2.8092
DIO-00001221-000 | 16 | 15 | EA | DIODE SCHOTTKY 100V 2A POWERMITE |  | X | ON | MBRM2H100T3G |  | DIGIKEY |  | 4 | 15869 | 50 |  |  |  |  | USD | USD |  | 0.7576 | 11.364 | 0.6603 | 9.9045 | 0.48926 | 7.3389
DIO-00001222-000 | 17 | 10 | EA | TVS DIODE 14VWM 23.2VC SMB |  | X | ON | 1SMB14CAT3G | 1SMB14CAT3G | MOUSER ELE |  | 14 | 1835 | 1 | N/A |  |  | QUOTE VALID FOR 30 DAYS - TVS DIODES - TRANSIENT VOLTAGE SUPPRESSORS 14V 600W BIDIRECTIONAL | USD | USD |  | 0.347 | 3.47 | 0.194 | 1.94 | 0.194 | 1.94
DIO-00001469-000 | 18 | 20 | EA | DIODE SCHOTTKY 20V 2A SOD323 |  | X | NXP | PMEG2020AEA,115 |  | DIGIKEY |  | 6 | 6420 | 100 |  |  |  |  | USD | USD |  | 0.2505 | 5.01 | 0.20752 | 4.1504 | 0.12839 | 2.5678
DIO-00000623-000 | 19 | 60 | EA | TVS DIODE 5VWM 18VC SOD882 |  | X | NXP | PESD9X5.0L,315 | PESD5V0L1UL,315 | DIGIKEY |  | 16 | 12864 | 100 |  |  |  |  | USD | USD |  | 0.2165 | 12.99 | 0.2165 | 12.99 | 0.0985 | 5.91
DIO-00000029-000 | 20 | 60 | EA | TVS DIODE 5VWM SOD882 |  | X | NXP | PESD5V0X1BL |  | DIGIKEY |  | 14 | 59069 | 100 |  |  |  |  | USD | USD |  | 0.3634 | 21.804 | 0.3634 | 21.804 | 0.2058 | 12.348
DIO-00001224-000 | 21 | 20 | EA | LED 3.2X1.0MM RD/GRN R/A SMD |  | X | KINGBRIGHT | APBA3010SURKCGKC-GX |  | DIGIKEY |  | 8 | 82194 | 50 |  |  |  |  | USD | USD |  | 0.3432 | 6.864 | 0.273 | 5.46 | 0.2028 | 4.056
DIO-00001470-000 | 22 | 20 | EA | LED RA SMD BLUE 470NM |  | X | KINGBRIGHT | APA3010QBC/D-GX |  | DIGIKEY |  | 8 | 22986 | 100 |  |  |  |  | USD | USD |  | 0.2765 | 5.53 | 0.237 | 4.74 | 0.111 | 2.22
CON-00001226-000 | 23 | 5 | EA | CONN HEADER 3POS .100 SNGL SMD |  | X | SAMTEC | TSM-103-01-L-SV-P-TR |  | DIGIKEY |  | 2 |  | 325 |  |  |  |  | USD | USD |  | 0.58 | 2.9 | 0.58 | 2.9 | 0.58 | 2.9
CON-00001150-000 | 24 | 5 | EA | CONN HEADER 3MM 2POS R/A TIN |  | X | TE CONNEC | 2-1445055-2 |  | DIGIKEY |  | 14 | 2566 | 50 |  |  |  |  | USD | USD |  | 0.607 | 3.035 | 0.58 | 2.9 | 0.475 | 2.375
CON-00001227-000 | 25 | 5 | EA | CONN HEADER PH SIDE 2POS 2MM SMD |  | X | JST | S2B-PH-SM4-TB(LF)(SN) |  | DIGIKEY |  | 14 | 196000 | 50 |  |  |  |  | USD | USD |  | 0.4168 | 2.084 | 0.3994 | 1.997 | 0.34734 | 1.7367
CON-00001228-000 | 26 | 0 | EA | CONN UUSB AB REC TOPMT FLANGE TH GRAY |  | X | MOLEX | 47590-1001 | 47590-1001 | MOUSER ELE |  | 18 | 11779 | 1 | N/A |  |  | QUOTE VALID FOR 30 DAYS - USB CONNECTORS UUSB AB REC TOPMT FLANGE TH GRAY 0.60 | USD | USD |  | 0.822 | 0 | 0.708 | 0 | 0.517 | 0
CON-00001229-000 | 27 | 0 | EA | CONN SOCKET MEMORY PCI-E 8H TYPE I PKG G/F 52P |  | X | TE CONNEC | 1759503-1 |  | ARROW |  | 6 | 1200 | 2400 | FOB |  |  |  | USD | USD |  | 1.77 | 0 | 1.77 | 0 | 1.77 | 0
CON-00001230-000 | 28 | 0 | EA | CONN SIM CARD PUSH-PUSH R/A SMD |  | X | WURTH | 693 013 050 811 | 6.93E+11 | MOUSER ELE |  | 6 | 807 | 1 | N/A |  |  | QUOTE VALID FOR 30 DAYS - MEMORY CARD CONNECTORS WR-CRD MEGA SIM CARD 8PIN PUSH & PUSH | USD | USD |  | 3.03 | 0 | 2.48 | 0 | 2.48 | 0
CON-00000134-000 | 29 | 0 | EA | CONN MICRO SD R/A PUSH-PUSH SMD |  | X | HIROSE | DM3AT-SF-PEJM5 |  | DIGIKEY |  | 8 | 12647 | 50 |  |  |  |  | USD | USD |  | 2.3798 | 0 | 2.2664 | 0 | 1.92648 | 0
CON-00001471-000 | 30 | 0 | EA | CONN HEADER 6POS .100 SGL HRZ SMD |  | X | SAMTEC | TSM-106-02-L-SH-P-TR |  | SAMTEC |  | 2 |  | 125 | FCA |  |  |  | USD | USD |  | 0.3 | 0 | 0.3 | 0 | 0.3 | 0
CON-00001307-000 | 31 | 5 | EA | CONN UMC JACK STR 50 OHM SMD |  | X | HIROSE | U.FL-R-SMT-1 (10) |  | DIGIKEY |  | 18 | 107993 | 100 |  |  |  |  | USD | USD |  | 0.9922 | 4.961 | 0.9922 | 4.961 | 0.7216 | 3.608
IND-00001233-000 | 32 | 10 | EA | FIXED POWER IND 2.2UH 20% 8A |  | X | COILCRAFT | XFL4020-222MEB |  | COILCRAFT |  | 8 | 3269 | 100 | FCA |  |  |  | USD | USD |  | 1.85 | 18.5 | 1.55 | 15.5 | 0.75 | 7.5
IND-00001234-000 | 33 | 10 | EA | INDUCTOR 1UH 20% 11A FIXED PWR COMPOS |  | X | COILCRAFT | XFL4020-102MEC | XFL4020-102MEB | COILCRAFT |  | 8 | 266 | 100 | FCA |  |  |  | USD | USD |  | 1.85 | 18.5 | 1.55 | 15.5 | 0.75 | 7.5
IND-00001235-000 | 34 | 40 | EA | FIXED IND 10UH 300MA 600 MOHM |  | X | TDK | MLZ1608N100LT000 |  | DIGIKEY |  | 10 | 42905 | 100 |  |  |  |  | USD | USD |  | 0.105 | 4.2 | 0.105 | 4.2 | 0.078 | 3.12
IND-00001268-000 | 35 | 20 | EA | FIXED IND 2.2UH 1.3A 80 MOHM SMD |  | X | MURATA | LQM2HPN2R2MG0L |  | DIGIKEY |  | 7 | 134373 | 100 |  |  |  |  | USD | USD |  | 0.2217 | 4.434 | 0.2046 | 4.092 | 0.15686 | 3.1372
IND-00001269-000 | 36 | 40 | EA | FERRITE CHIP 180OHM 1500MA 0603 |  | X | MURATA | BLM18PG181SN1D |  | DIGIKEY |  | 6 | 143781 | 100 |  |  |  |  | USD | USD |  | 0.0501 | 2.004 | 0.03644 | 1.4576 | 0.02884 | 1.1536
IND-00001270-000 | 37 | 10 | EA | IND .47UH 5.5A XFL4012 |  | X | COILCRAFT | XFL4012-471MEC |  | COILCRAFT |  | 8 | 376 | 1 | FCA |  |  |  | USD | USD |  | 1.23 | 12.3 | 1.23 | 12.3 | 0.68 | 6.8
IND-00001272-000 | 38 | 60 | EA | FIXED IND 2.2NH 220MA 300 MOHM |  | X | MURATA | LQP15MN2N2B02D |  | DIGIKEY |  | 8 | 165297 | 50 |  |  |  |  | USD | USD |  | 0.1302 | 7.812 | 0.1169 | 7.014 | 0.1002 | 6.012
IND-00001472-000 | 39 | 60 | EA | FIXED IND 4.7NH 160MA 600 MOHM |  | X | MURATA | LQP15MN4N7B02D |  | DIGIKEY |  | 8 | 92971 | 50 |  |  |  |  | USD | USD |  | 0.1302 | 7.812 | 0.1169 | 7.014 | 0.1002 | 6.012
ICS-00001274-000 | 40 | 20 | EA | IC,MOSFET N-CH 20V 4.2A SOT-23 |  | X | IR | IRLML2502TRPBF |  | DIGIKEY |  | 12 | 55266 | 250 |  |  |  |  | USD | USD |  | 0.131 | 2.62 | 0.11784 | 2.3568 | 0.11031 | 2.2062
ICS-00001473-000 | 41 | 20 | EA | IC MOSFET P-CH 30V 3.6A SOT-23-3 |  | X | IR | IRLML9301TRPBF |  | DIGIKEY |  | 14 | 19399 | 50 |  |  |  |  | USD | USD |  | 0.2306 | 4.612 | 0.2062 | 4.124 | 0.16864 | 3.3728
RES-00000048-000 | 42 | 80 | EA | RES 15K OHM 1/20W 1% 0201 SMD |  | X | PANASONIC | ERJ-1GEF1502C |  | DIGIKEY |  | 8 | 195230 | 50 |  |  |  |  | USD | USD |  | 0.0316 | 2.528 | 0.0234 | 1.872 | 0.01426 | 1.1408
RES-00000039-000 | 43 | 80 | EA | RES 10K OHM 1/20W 1% 0201 SMD |  | X | KOA | RK73H1HTTC1002F | RK73H1HTTC1002F | MOUSER ELE |  | 11 | 165247 | 1 | N/A |  |  | QUOTE VALID FOR 30 DAYS - THICK FILM RESISTORS - SMD 10K OHM 1% | USD | USD |  | 0.011 | 0.88 | 0.011 | 0.88 | 0.009 | 0.72
RES-00001275-000 | 44 | 80 | EA | RES 2K OHM 1/20W 1% 0201 SMD |  | X | PANASONIC | ERJ-1GEF2001C |  | DIGIKEY |  | 8 | 180974 | 250 |  |  |  |  | USD | USD |  | 0.01784 | 1.4272 | 0.01426 | 1.1408 | 0.01049 | 0.8392
RES-00001474-000 | 45 | 80 | EA | RES SMD 4.32K OHM 1% 1/20W 0201 |  | X | PANASONIC | ERJ1GEF4321C |  | DIGIKEY |  | 14 | 39030 | 50 |  |  |  |  | USD | USD |  | 0.0316 | 2.528 | 0.0234 | 1.872 | 0.0143 | 1.144
RES-00000684-000 | 46 | 80 | EA | RES 20K OHM 1/20W 1% 0201 SMD |  | X | PANASONIC | ERJ-1GEF2002C |  | DIGIKEY |  | 8 | 386762 | 50 |  |  |  |  | USD | USD |  | 0.0316 | 2.528 | 0.0234 | 1.872 | 0.01426 | 1.1408
RES-00001278-000 | 47 | 60 | EA | THERMISTOR NTC 10K OHM 1% 0402 |  | X | PANASONIC | ERT-J0EG103FA |  | DIGIKEY |  | 6 | 5005 | 50 |  |  |  |  | USD | USD |  | 0.342 | 20.52 | 0.2342 | 14.052 | 0.19722 | 11.8332
RES-00001279-000 | 48 | 80 | EA | RES 267 OHM 1/20W 1% 0201 SMD |  | X | PANASONIC | ERJ-1GEF2670C |  | DIGIKEY |  | 8 | 45663 | 50 |  |  |  |  | USD | USD |  | 0.0316 | 2.528 | 0.0234 | 1.872 | 0.01426 | 1.1408
RES-00000041-000 | 49 | 80 | EA | RES 1K OHM 1/20W 1% 0201 SMD |  | X | KOA | RK73H1HTTC1001F | RK73H1HTTC1001F | MOUSER ELE |  | 11 | 46356 | 1 | N/A |  |  | QUOTE VALID FOR 30 DAYS - THICK FILM RESISTORS - SMD 1/20W 1K OHM 1% 200PPM | USD | USD |  | 0.017 | 1.36 | 0.017 | 1.36 | 0.011 | 0.88
RES-00000053-000 | 50 | 80 | EA | RES 200 OHM 1/20W 1% 0201 SMD |  | X | PANASONIC | ERJ-1GEF2000C |  | DIGIKEY |  | 8 | 151292 | 250 |  |  |  |  | USD | USD |  | 0.01784 | 1.4272 | 0.01426 | 1.1408 | 0.01049 | 0.8392
RES-00001280-000 | 51 | 80 | EA | RES 374 OHM 1/20W 1% 0201 SMD |  | X | PANASONIC | ERJ-1GEF3740C |  | DIGIKEY |  | 8 | 32427 | 50 |  |  |  |  | USD | USD |  | 0.0316 | 2.528 | 0.0234 | 1.872 | 0.01426 | 1.1408
RES-00001281-000 | 52 | 80 | EA | RES 1.27K OHM 1/20W 1% 0201 SMD |  | X | PANASONIC | ERJ-1GEF1271C |  | DIGIKEY |  | 8 | 43165 | 50 |  |  |  |  | USD | USD |  | 0.0316 | 2.528 | 0.0234 | 1.872 | 0.01426 | 1.1408
RES-00001478-000 | 53 | 80 | EA | RES SMD 33.2K OHM 1% 1/20W 0201 |  | X | PANASONIC | ERJ1GEF3322C |  | DIGIKEY |  | 14 | 70498 | 50 |  |  |  |  | USD | USD |  | 0.0316 | 2.528 | 0.0234 | 1.872 | 0.0143 | 1.144
RES-00000045-000 | 54 | 80 | EA | RES 100K OHM 1/20W 1% 0201 SMD |  | X | PANASONIC | ERJ-1GEF1003C |  | DIGIKEY |  | 8 | 5634508 | 500 |  |  |  |  | USD | USD |  | 0.01426 | 1.1408 | 0.01049 | 0.8392 | 0.00752 | 0.6016
RES-00000872-000 | 55 | 60 | EA | RES 1 OHM 1/10W 5% 0402 SMD |  | X | PANASONIC | ERJ-2GEJ1R0X |  | DIGIKEY |  | 6 | 291926 | 100 |  |  |  |  | USD | USD |  | 0.0078 | 0.468 | 0.00596 | 0.3576 | 0.0035 | 0.21
RES-00001282-000 | 56 | 60 | EA | RES 2.2 OHM 1/10W 5% 0402 SMD |  | X | PANASONIC | ERJ-2GEJ2R2X |  | DIGIKEY |  | 6 | 650460 | 100 |  |  |  |  | USD | USD |  | 0.0078 | 0.468 | 0.00596 | 0.3576 | 0.0035 | 0.21
RES-00000040-000 | 57 | 80 | EA | RES 49.9K OHM 1/20W 1% 0201 SMD |  | X | PANASONIC | ERJ-1GEF4992C |  | DIGIKEY |  | 8 | 1508030 | 1000 |  |  |  |  | USD | USD |  | 0.01049 | 0.8392 | 0.01049 | 0.8392 | 0.00752 | 0.6016
RES-00001283-000 | 58 | 80 | EA | RES 1.5K OHM 1/20W 1% 0201 SMD |  | X | PANASONIC | ERJ-1GEF1501C |  | DIGIKEY |  | 8 | 804079 | 100 |  |  |  |  | USD | USD |  | 0.0234 | 1.872 | 0.01784 | 1.4272 | 0.01049 | 0.8392
RES-00001284-000 | 59 | 80 | EA | RES 5.62K OHM 1/20W 1% 0201 SMD |  | X | PANASONIC | ERJ-1GEF5621C |  | DIGIKEY |  | 8 | 26637 | 50 |  |  |  |  | USD | USD |  | 0.0316 | 2.528 | 0.0234 | 1.872 | 0.01426 | 1.1408
RES-00000148-000 | 60 | 30 | EA | RES 0.0 OHM 1/8W JUMP 0805 SMD |  | X | YAGEO | RC0805FR-070RL |  | DIGIKEY |  | 20 | 162017 | 100 |  |  |  |  | USD | USD |  | 0.0099 | 0.297 | 0.0099 | 0.297 | 0.00443 | 0.1329
RES-00000043-000 | 61 | 80 | EA | RES 0.0 OHM 1/20W JUMP 0201 SMD |  | X | YAGEO | RC0201JR-070RL |  | DIGIKEY |  | 20 | 1136671 | 500 |  |  |  |  | USD | USD |  | 0.0109 | 0.872 | 0.00802 | 0.6416 | 0.00575 | 0.46
RES-00001479-000 | 62 | 80 | EA | RES SMD 140 OHM 1% 1/20W 0201 |  | X | PANASONIC | ERJ1GEF1400C |  | DIGIKEY |  | 14 | 65631 | 50 |  |  |  |  | USD | USD |  | 0.0316 | 2.528 | 0.0234 | 1.872 | 0.0143 | 1.144
RES-00001480-000 | 63 | 80 | EA | RES SMD 84.5 OHM 1% 1/20W 0201 |  | X | PANASONIC | ERJ1GEF84R5C |  | DIGIKEY |  | 14 | 68353 | 100 |  |  |  |  | USD | USD |  | 0.0234 | 1.872 | 0.0178 | 1.424 | 0.01 | 0.8
RES-00001285-000 | 64 | 80 | EA | RES 4.7K OHM 1/20W 1% 0201 SMD |  | X | PANASONIC | ERJ-1GEF4701C |  | DIGIKEY |  | 8 | 398674 | 250 |  |  |  |  | USD | USD |  | 0.01784 | 1.4272 | 0.01426 | 1.1408 | 0.01049 | 0.8392
RES-00000050-000 | 65 | 80 | EA | RES 20 OHM 1/20W 1% 0201 SMD |  | X | PANASONIC | ERJ-1GEF20R0C |  | DIGIKEY |  | 8 | 30482 | 50 |  |  |  |  | USD | USD |  | 0.0316 | 2.528 | 0.0234 | 1.872 | 0.01426 | 1.1408
RES-00001481-000 | 66 | 80 | EA | RES SMD 402 OHM 1% 1/20W 0201 |  | X | PANASONIC | ERJ1GEF4020C |  | DIGIKEY |  | 14 | 55759 | 100 |  |  |  |  | USD | USD |  | 0.0234 | 1.872 | 0.0234 | 1.872 | 0.0105 | 0.84
RES-00001276-000 | 67 | 80 | EA | RES 5.49K OHM 1/20W 1% 0201 SMD |  | X | PANASONIC | ERJ-1GEF5491C |  | DIGIKEY |  | 8 | 39417 | 50 |  |  |  |  | USD | USD |  | 0.0316 | 2.528 | 0.0234 | 1.872 | 0.01426 | 1.1408
RES-00001482-000 | 68 | 80 | EA | RES SMD 576 OHM 1% 1/20W 0201 |  | X | PANASONIC | ERJ1GEF5760C |  | DIGIKEY |  | 14 | 120378 | 50 |  |  |  |  | USD | USD |  | 0.0316 | 2.528 | 0.0234 | 1.872 | 0.0143 | 1.144
ELC-00001286-000 | 69 | 0 | EA | SWITCH PUSH SPDT 0.2A 30V |  | X | C&K | PN12SJNA03QE |  | DIGIKEY |  | 8 | 2067 | 50 |  |  |  |  | USD | USD |  | 0.76 | 0 | 0.74 | 0 | 0.578 | 0
ELC-00000526-002 | 70 | 5 | EA | SWITCH TACTILE SPST-NO 0.05A 12V |  | X | PANASONIC | EVQPUK02K |  | DIGIKEY |  | 14 | 5389 | 50 |  |  |  |  | USD | USD |  | 0.5618 | 2.809 | 0.538 | 2.69 | 0.3862 | 1.931
ICS-00001287-000 | 71 | 10 | EA | IC BATT CHARGE MGMT 24VQFN |  | X | TI | BQ24196RGET |  | DIGIKEY |  | 6 | 670 | 50 |  |  |  |  | USD | USD |  | 5.01 | 50.1 | 4.77 | 47.7 | 3.29 | 32.9
ICS-00001288-000 | 72 | 30 | EA | IC LOAD SW FULL FUNCT ADJ 6MLP |  | X | FAIRCHILD | FPF2165R |  | DIGIKEY |  | 6 | 12448 | 50 |  |  |  |  | USD | USD |  | 1.0312 | 30.936 | 0.9022 | 27.066 | 0.70168 | 21.0504
ICS-00001289-000 | 73 | 0 | EA | IC REG LDO ADJ 0.15A 6MLF |  | X | MICREL | MIC5305YML |  | DIGIKEY |  | 16 | 14970 | 25 |  |  |  |  | USD | USD |  | 0.7776 | 0 | 0.6804 | 0 | 0.5292 | 0
ICS-00001290-000 | 74 | 15 | EA | IC REG BOOST SYNC 5V 5A 10SON |  | X | TI | TPS61232DRCT | TPS61232DRCT | MOUSER ELE |  | 6 | 6332 | 1 | N/A |  |  | QUOTE VALID FOR 30 DAYS - VOLTAGE REGULATORS - SWITCHING REGULATORS HIGH EFF SYNC STEP UP CONVERTER | USD | USD |  | 2.55 | 38.25 | 2.43 | 36.45 | 1.97 | 29.55
ICS-00001291-000 | 75 | 20 | EA | IC POT DGTL 32TAP NV TSOT23-6 |  | X | MAXIM | MAX5434LEZT+T |  | DIGIKEY |  | 8 | 28309 | 50 |  |  |  |  | USD | USD |  | 1.2598 | 25.196 | 1.1603 | 23.206 | 1.0608 | 21.216
ICS-00001292-000 | 76 | 0 | EA | IC PMU CONV/LDO REG 32TQFN |  | X | ACTIVE SEM | ACT8865QI305-T |  | DIGIKEY |  | 16 | 12599 | 50 |  |  |  |  | USD | USD |  | 2.3452 | 0 | 2.1089 | 0 | 1.6362 | 0
ICS-00001293-000 | 77 | 20 | EA | IC REG LDO 3.3V 0.15A SOT23 |  | X | DIODES | AP2120N-3.3TRG1 |  | DIGIKEY |  | 9 | 3763 | 50 |  |  |  |  | USD | USD |  | 0.2388 | 4.776 | 0.1807 | 3.614 | 0.10228 | 2.0456
ICS-00001294-000 | 78 | 0 | EA | IC MCU 32BIT 160KB FLASH 324BGA |  | X | ATMEL | ATSAMA5D31A-CUR |  | DIGIKEY |  | 7 | 7137 | 50 |  |  |  |  | USD | USD |  | 12.1188 | 0 | 11.1038 | 0 | 9.20026 | 0
ICS-00001295-000 | 79 | 0 | EA | IC DDR2 SDRAM 1GBIT 2.5NS 84FBGA |  | X | MICRON | MT47H64M16HR-25E:H TR | MT47H64M16NF-25E:M | DIGIKEY |  | 20 | 0 | 1000 |  |  |  |  | USD | USD |  | 3.3 | 0 | 3.3 | 0 | 3.3 | 0
ICS-00001308-000 | 80 | 20 | EA | IC BUS TRANSCVR 4BIT 16-UQFN |  | X | TI | SN74AVC4T245RSVR |  | DIGIKEY |  | 12 | 22415 | 100 |  |  |  |  | USD | USD |  | 0.71 | 14.2 | 0.71 | 14.2 | 0.495 | 9.9
ICS-00001298-000 | 81 | 20 | EA | IC REG BUCK SYNC 3.3V 3A 16QFN |  | X | TI | TPS62091RGTT | TPS62091RGTT | MOUSER ELE |  | 6 | 939 | 1 | N/A |  |  | QUOTE VALID FOR 30 DAYS - VOLTAGE REGULATORS - SWITCHING REGULATORS 3A,2.5-6VIN,97% EFF SYNC SD CONVERTER | USD | USD |  | 2.26 | 45.2 | 2.26 | 45.2 | 1.22 | 24.4
ELC-00001299-000 | 82 | 0 | EA | MODULE WIFI WILINK |  | X | TI | WL1835MODGBMOCT |  | DIGIKEY |  | 10 | 974 | 50 |  |  |  |  | USD | USD |  | 21.69 | 0 | 21.24 | 0 | 17.88002 | 0
ICS-00001309-000 | 83 | 20 | EA | IC XLATR VOLT-LVL 8B BDIR 20QFN |  | X | TI | TXS0108ERGYR |  | DIGIKEY |  | 2 | 6325 | 50 |  |  |  |  | USD | USD |  | 1.69 | 33.8 | 1.67 | 33.4 | 1.26 | 25.2
ICS-00001303-000 | 84 | 20 | EA | IC EEPROM 2KBIT 400KHZ TSOT23-5 |  | X | ON | CAT24AA02TDI-GT3 |  | DIGIKEY |  | 15 | 21947 | 50 |  |  |  |  | USD | USD |  | 0.2908 | 5.816 | 0.2368 | 4.736 | 0.16204 | 3.2408
ICS-00001310-000 | 85 | 30 | EA | IC BUFF/DVR NON-INVERT SC705 |  | X | TI | SN74AUC1G07DCKR |  | DIGIKEY |  | 6 | 10662 | 50 |  |  |  |  | USD | USD |  | 0.33 | 9.9 | 0.155 | 4.65 | 0.155 | 4.65
ICS-00001476-000 | 86 | 0 | EA | IC USB FS SERIAL UART 32-QFN |  | X | FTDI | FT232RQ-REEL |  | DIGIKEY |  | 12 | 88474 | 50 |  |  |  |  | USD | USD |  | 3.85 | 0 | 3.65 | 0 | 2.85 | 0
OSC-00001304-000 | 87 | 5 | EA | OSC XO 32.768KHZ CMOS SMD |  | X | TXC | 7XZ-32.768KDA-T |  | DIGIKEY |  | 14 | 8414 | 50 |  |  |  |  | USD | USD |  | 2.3814 | 11.907 | 2.0866 | 10.433 | 2.02986 | 10.1493
XTL-00001305-000 | 88 | 5 | EA | CRYSTAL 12MHZ 12PF SMD |  | X | EPSON | FA-238V 12.0000MB-W3 |  | DIGIKEY |  | 10 | 5480 | 50 |  |  |  |  | USD | USD |  | 0.904 | 4.52 | 0.8 | 4 | 0.612 | 3.06
XTL-00000186-003 | 89 | 10 | EA | CRYSTAL 32.768KHZ 12.5PF SMD |  | X | SEIKO | SSPT7F-12.5PF20-R |  | DIGIKEY |  | 10 | 22567 | 50 |  |  |  |  | USD | USD |  | 0.472 | 4.72 | 0.42 | 4.2 | 0.4 | 4
PCB-00001143-002 | 90 | 0 | EA | PCB,(FAB),FMC,MAIN,OPENXC |  | X | HALLCIRCT | PCB-00001143-001 |  | HALLCIRCT |  | 5 |  | 50 |  |  |  |  | USD | USD |  | 90.93 | 0 | 68.75 | 0 | 23.85 | 0
RES-00001597-000 | 91 | 80 | EA | RES SMD 2.15K OHM 1% 1/20W 0201 |  | X | PANASONIC | ERJ-1GNF2151C | ERJ-1GNF2151C | MOUSER ELE |  | 10 | 0 | 1 | N/A |  |  | QUOTE VALID FOR 30 DAYS - THICK FILM RESISTORS - SMD 0201 2.15KOHM 1% HALOGEN FREE | USD | USD |  | 0.041 | 3.28 | 0.017 | 1.36 | 0.017 | 1.36
RES-00001598-000 | 92 | 80 | EA | RES SMD 7.5K OHM 1% 1/20W 0201 |  | X | PANASONIC | ERJ-1GNF7501C | ERJ-1GNF7501C | MOUSER ELE |  | 10 | 27400 | 1 | N/A |  |  | QUOTE VALID FOR 30 DAYS - THICK FILM RESISTORS - SMD 0201 7.5KOHM 1% HALOGEN FREE | USD | USD |  | 0.04 | 3.2 | 0.017 | 1.36 | 0.017 | 1.36
RES-00001599-000 | 93 | 80 | EA | RES SMD 41.2K OHM 1% 1/20W 0201 |  | X | PANASONIC | ERJ-1GNF4122C | ERJ-1GNF4122C | MOUSER ELE |  | 8 | 15618 | 1 | N/A |  |  | QUOTE VALID FOR 30 DAYS - THICK FILM RESISTORS - SMD 0201 41.2KOHM 1% HALOGEN FREE | USD | USD |  | 0.04 | 3.2 | 0.017 | 1.36 | 0.017 | 1.36
ICS-00001593-000 | 94 | 0 | EA | IC FLASH 4GBIT 48TSOP |  | X | MICRON | MT29F4G08ABADAWP:D TR |  | DIGIKEY |  | 12 | 2650 | 50 |  |  |  |  | USD | USD |  | 5.452 | 0 | 4.8906 | 0 | 4.56856 | 0
DWG-00001143-002-PCA | 95 | 0 | EA | DWG,PCA,FMC,MAIN,OPENXC |  | X | REFERENCE | DWG-00001143-002-PCA |  | REFERENCE |  |  |  |  |  |  |  |  | USD | USD |  | 0 | 0
DWG-00001143-002-SCH | 96 | 0 | EA | DWG,SCHEMATIC,FMC,MAIN,OPENXC |  | X | REFERENCE | DWG-00001143-002-SCH |  | REFERENCE |  |  |  |  |  |  |  |  | USD | USD |  | 0 | 0
PCA-00001143-002-BOMCHECKER | 97 | 0 | EA | BOMCHECKER |  | X | REFERENCE | PCA-00001143-002-BOMCHECKER |  | REFERENCE |  |  |  |  |  |  |  |  | USD | USD |  | 0 | 0
PCA-00001143-002-CADMATCHER | 98 | 0 | EA | CADMATCHER |  | X | REFERENCE | PCA-00001143-002-CADMATCHER |  | REFERENCE |  |  |  |  |  |  |  |  | USD | USD |  | 0 | 0
PCA-00001143-002-FABMASTER | 99 | 0 | EA | FABMASTER |  | X | REFERENCE | PCA-00001143-002-FABMASTER |  | REFERENCE |  |  |  |  |  |  |  |  | USD | USD |  | 0 | 0
PCA-00001143-002-ORIGINAL BOM | 100 | 0 | EA | ORIGINAL BOM |  | X | REFERENCE | PCA-00001143-002-ORIGINAL BOM |  | REFERENCE |  |  |  |  |  |  |  |  | USD | USD |  | 0 | 0
PCA-00001143-002-PI | 101 | 0 | EA | PROCESS INSTRUCTIONS |  | X | REFERENCE | PCA-00001143-002-PI |  | REFERENCE |  |  |  |  |  |  |  |  | USD | USD |  | 0 | 0
PCA-00001143-002-QA | 102 | 0 | EA | QUALITY ASSURANCE |  | X | REFERENCE | PCA-00001143-002-QA |  | REFERENCE |  |  |  |  |  |  |  |  | USD | USD |  | 0 | 0
PCA-00001143-002-SMT PROGRAM | 103 | 0 | EA | SMT PROGRAM |  | X | REFERENCE | PCA-00001143-002-SMT PROGRAM |  | REFERENCE |  |  |  |  |  |  |  |  | USD | USD |  | 0 | 0
PCA-00001143-002-VISUAL AIDE | 104 | 0 | EA | VISUAL AIDE |  | X | REFERENCE | PCA-00001143-002-VISUAL AIDE |  | REFERENCE |  |  |  |  |  |  |  |  | USD | USD |  | 0 | 0
 |  |  |  |  |  |  |  |  |  |  |  |  |  |  |  |  |  |  |  |  |  |  | 614.087 |  | 542.2965 |  | 390.1558

Sheet: ASSUMPTIONS
PRICE NOT INCLUDED IN THE QUOTE - MISSING INFORMATION TO QUOTE
Part Number | Line | Part Qty | Unit | Description | Commodity | AML | Mfg ID | Mfg Part Number | Corrected MPN | Supp ID | No Bid | Lead Time | Inventory | MOQ | Delivery Terms | NCNR | Short Comment | Long Comment | Raw Currency | Currency | NRE Charge | Cost #1 | Ext Cost #1 | Cost #2 | Ext Cost #2 | Cost #3 | Ext Cost #3 | Ownership
ELC-00001836-000 | 3 | 1 | EA | 12 * 12 * 2MM PASSIVE GPS ANTENNA CABLE LENGTH 70MM |  | X | ISSUE | ELC-00001836-000 |  | ISSUE |  |  |  |  |  |  |  | We need know technical information | USD | USD |  | 0 | 0
LBL-00001884-000 | 14 | 1 | EA | LABEL,OPENXC MODEM,1.5 INCH WIDE X .4 INCH HIGH |  | X | ISSUE | LBL-00001884-000 |  | ISSUE |  |  |  |  |  |  |  | we need know the kind of label to buy the Blank label | USD | USD |  | 0 | 0
PRICE NOT INCLUDED IN THE QUOTE - CUSTOMER WILL CONSIGN THESE PARTS
Part Number | Line | Part Qty | Unit | Description | Commodity | AML | Mfg ID | Mfg Part Number | Corrected MPN | Supp ID | No Bid | Lead Time | Inventory | MOQ | Delivery Terms | NCNR | Short Comment | Long Comment | Raw Currency | Currency | NRE Charge | Cost #1 | Ext Cost #1 | Cost #2 | Ext Cost #2 | Cost #3 | Ext Cost #3 | Ownership
MCH-00001323-000 | 15 | 1 | EA | TOP HOUSING,INJECTION MOLDED, FMC OPENXC MODEM |  | X | CONSIGN | MCH-00001323-000 |  | CONSIGNED |  |  |  |  |  |  |  |  | USD | USD |  | 0 | 0
MCH-00001324-000 | 16 | 1 | EA | BOTTOM HOUSING,INJECTION MOLDED, FMC OPENXC MODEM |  | X | CONSIGN | MCH-00001324-000 |  | CONSIGNED |  |  |  |  |  |  |  |  | USD | USD |  | 0 | 0
MCH-00001326-000 | 17 | 1 | EA | BUTTON,INJECTION MOLDED, FMC OPENXC MODEM |  | X | CONSIGN | MCH-00001326-000 |  | CONSIGNED |  |  |  |  |  |  |  |  | USD | USD |  | 0 | 0
MCH-00001842-000 | 19 | 1 | EA | CUSTOM PART: BATTERY LIGHT PIPE-INJECTION MOLDED |  | X | CONSIGN | MCH-00001842-000 |  | CONSIGNED |  |  |  |  |  |  |  |  | USD | USD |  | 0 | 0
MCH-00001843-000 | 20 | 1 | EA | CUSTOM PART:BLUETOOTH LIGHT PIPE-INJECTION MOLDED |  | X | CONSIGN | MCH-00001843-000 |  | CONSIGNED |  |  |  |  |  |  |  |  | USD | USD |  | 0 | 0
MCH-00001844-000 | 21 | 1 | EA | CUSTOM PART: 3G LIGHT PIPE-INJECTION MOLDED |  | X | CONSIGN | MCH-00001844-000 |  | CONSIGNED |  |  |  |  |  |  |  |  | USD | USD |  | 0 | 0
MCH-00001845-000 | 22 | 1 | EA | CUSTOM PART: GPS LIGHT PIPE-INJECTION MOLDED |  | X | CONSIGN | MCH-00001845-000 |  | CONSIGNED |  |  |  |  |  |  |  |  | USD | USD |  | 0 | 0
MCH-00001846-000 | 23 | 1 | EA | CUSTOM PART: WIFI LIGHT PIPE-INJECTION MOLDED |  | X | CONSIGN | MCH-00001846-000 |  | CONSIGNED |  |  |  |  |  |  |  |  | USD | USD |  | 0 | 0
PRICE NOT INCLUDED IN THE QUOTE - REFERENCE ONLY
Part Number | Line | Part Qty | Unit | Description | Commodity | AML | Mfg ID | Mfg Part Number | Corrected MPN | Supp ID | No Bid | Lead Time | Inventory | MOQ | Delivery Terms | NCNR | Short Comment | Long Comment | Raw Currency | Currency | NRE Charge | Cost #1 | Ext Cost #1 | Cost #2 | Ext Cost #2 | Cost #3 | Ext Cost #3 | Ownership
SWR-00001994-000 | 25 | 1 | EA | XCMODEM-UPGRADE-0.14.MD5 |  | X | REFERENCE | SWR-00001994-000 |  | REFERENCE |  |  |  |  |  |  |  |  | USD | USD |  | 0 | 0
SWR-00001995-000 | 26 | 1 | EA | SAMA5D3_XPLAINED-V1.1 |  | X | REFERENCE | SWR-00001995-000 |  | REFERENCE |  |  |  |  |  |  |  |  | USD | USD |  | 0 | 0
TLA-00001300-002-BOMCHECKER | 27 | 0 | EA | BOMCHECKER |  | X | REFERENCE | TLA-00001300-002-BOMCHECKER |  | REFERENCE |  |  |  |  |  |  |  |  | USD | USD |  | 0 | 0
TLA-00001300-002-ORIGINAL BOM | 28 | 0 | EA | ORIGINAL BOM |  | X | REFERENCE | TLA-00001300-002-ORIGINAL BOM |  | REFERENCE |  |  |  |  |  |  |  |  | USD | USD |  | 0 | 0
TLA-00001300-002-PI | 29 | 0 | EA | PROCESS INSTRUCTIONS |  | X | REFERENCE | TLA-00001300-002-PI |  | REFERENCE |  |  |  |  |  |  |  |  | USD | USD |  | 0 | 0
DWG-00001143-002-PCA | 95 | 0 | EA | DWG,PCA,FMC,MAIN,OPENXC |  | X | REFERENCE | DWG-00001143-002-PCA |  | REFERENCE |  |  |  |  |  |  |  |  | USD | USD |  | 0 | 0
DWG-00001143-002-SCH | 96 | 0 | EA | DWG,SCHEMATIC,FMC,MAIN,OPENXC |  | X | REFERENCE | DWG-00001143-002-SCH |  | REFERENCE |  |  |  |  |  |  |  |  | USD | USD |  | 0 | 0
PCA-00001143-002-BOMCHECKER | 97 | 0 | EA | BOMCHECKER |  | X | REFERENCE | PCA-00001143-002-BOMCHECKER |  | REFERENCE |  |  |  |  |  |  |  |  | USD | USD |  | 0 | 0
PCA-00001143-002-CADMATCHER | 98 | 0 | EA | CADMATCHER |  | X | REFERENCE | PCA-00001143-002-CADMATCHER |  | REFERENCE |  |  |  |  |  |  |  |  | USD | USD |  | 0 | 0
PCA-00001143-002-FABMASTER | 99 | 0 | EA | FABMASTER |  | X | REFERENCE | PCA-00001143-002-FABMASTER |  | REFERENCE |  |  |  |  |  |  |  |  | USD | USD |  | 0 | 0
PCA-00001143-002-ORIGINAL BOM | 100 | 0 | EA | ORIGINAL BOM |  | X | REFERENCE | PCA-00001143-002-ORIGINAL BOM |  | REFERENCE |  |  |  |  |  |  |  |  | USD | USD |  | 0 | 0
PCA-00001143-002-PI | 101 | 0 | EA | PROCESS INSTRUCTIONS |  | X | REFERENCE | PCA-00001143-002-PI |  | REFERENCE |  |  |  |  |  |  |  |  | USD | USD |  | 0 | 0
PCA-00001143-002-QA | 102 | 0 | EA | QUALITY ASSURANCE |  | X | REFERENCE | PCA-00001143-002-QA |  | REFERENCE |  |  |  |  |  |  |  |  | USD | USD |  | 0 | 0
PCA-00001143-002-SMT PROGRAM | 103 | 0 | EA | SMT PROGRAM |  | X | REFERENCE | PCA-00001143-002-SMT PROGRAM |  | REFERENCE |  |  |  |  |  |  |  |  | USD | USD |  | 0 | 0
PCA-00001143-002-VISUAL AIDE | 104 | 0 | EA | VISUAL AIDE |  | X | REFERENCE | PCA-00001143-002-VISUAL AIDE |  | REFERENCE |  |  |  |  |  |  |  |  | USD | USD |  | 0 | 0
QUOTED ALTERNATE MPN - CUSTOMER MUST APPROVE FOR BUILD
Part Number | Line | Part Qty | Unit | Description | Commodity | AML | Mfg ID | Mfg Part Number | Corrected MPN | Supp ID | No Bid | Lead Time | Inventory | MOQ | Delivery Terms | NCNR | Short Comment | Long Comment | Raw Currency | Currency | NRE Charge | Cost #1 | Ext Cost #1 | Cost #2 | Ext Cost #2 | Cost #3 | Ext Cost #3 | Ownership
ELC-00001848-000 | 3 | 1 | EA | HIGH CAPACITY 3200MAH 3.8V LI-ION RECHARGEABLE |  | X | SAMSUNG | B800BU | EB-B800BUBESTA | SAMSUNG EM |  | 16 | 0 | 1 |  |  |  |  | USD | USD |  | 39.99 | 39.99 | 39.99 | 39.99 | 39.99 | 39.99
DIO-00000623-000 | 19 | 2 | EA | TVS DIODE 5VWM 18VC SOD882 |  | X | NXP | PESD9X5.0L,315 | PESD5V0L1UL,315 | DIGIKEY |  | 16 | 12864 | 100 |  |  |  |  | USD | USD |  | 0.2165 | 0.433 | 0.2165 | 0.433 | 0.0985 | 0.197
ICS-00001295-000 | 79 | 2 | EA | IC DDR2 SDRAM 1GBIT 2.5NS 84FBGA |  | X | MICRON | MT47H64M16HR-25E:H TR | MT47H64M16NF-25E:M | DIGIKEY |  | 20 | 0 | 1000 |  |  |  |  | USD | USD |  | 3.3 | 6.6 | 3.3 | 6.6 | 3.3 | 6.6
INVENTORY NOT AVAILABLE OR LIMITED STOCK ONLY TO SUPPORT FIRST BUILD - NEED TO EXPEDITE WITH MFG
Part Number | Line | Part Qty | Unit | Description | Commodity | AML | Mfg ID | Mfg Part Number | Corrected MPN | Supp ID | No Bid | Lead Time | Inventory | MOQ | Delivery Terms | NCNR | Short Comment | Long Comment | Raw Currency | Currency | NRE Charge | Cost #1 | Ext Cost #1 | Cost #2 | Ext Cost #2 | Cost #3 | Ext Cost #3 | Ownership
ELC-00001321-000 | 1 | 1 | EA | MODULE,3G,MINI PCIE |  | X | TELIT | HEPCIGPS204T701 |  | ARROW |  | 7 | 498 | 3 | FOB |  |  |  | USD | USD |  | 87.52 | 87.52 | 87.52 | 87.52 | 81.14 | 81.14
ELC-00001327-000 | 2 | 1 | EA | PCA,ANTENNA BOARD,FMC OPENXC |  |  | WORLDPROD | WPANT10074-C2A |  | WPG |  | 16 | 100 | 100 |  |  |  |  | USD | USD |  | 2.48 | 2.48 | 2.48 | 2.48 | 2.48 | 2.48
MCH-00001837-000 | 18 | 1 | EA | FERRITE COVER FOR PCB-NEC/TOKIN FLEX SUPPRESSOR EFF(03) T0800 |  | X | KEMET | EFF(03)-240X240T0800 |  | DIGIKEY |  | 18 |  | 10 |  |  |  |  | USD | USD |  | 85.74 | 85.74 | 85.74 | 85.74 | 82.5088 | 82.5088
ELC-00001850-000 | 5 | 1 | EA | STRANDED WIRE, 300V AC, 24 GAUGE,RED |  |  | MCMASTER | 8054T22-RED |  | MCMASTER |  | 4 |  | 127 |  |  |  | ROLL OF 25 FT | USD | USD |  | 0.025 | 0.025 | 0.025 | 0.025 | 0.025 | 0.025
CON-00001226-000 | 23 | 1 | EA | CONN HEADER 3POS .100 SNGL SMD |  | X | SAMTEC | TSM-103-01-L-SV-P-TR |  | DIGIKEY |  | 2 |  | 325 |  |  |  |  | USD | USD |  | 0.58 | 0.58 | 0.58 | 0.58 | 0.58 | 0.58
CON-00001471-000 | 30 | 1 | EA | CONN HEADER 6POS .100 SGL HRZ SMD |  | X | SAMTEC | TSM-106-02-L-SH-P-TR |  | SAMTEC |  | 2 |  | 125 | FCA |  |  |  | USD | USD |  | 0.3 | 0.3 | 0.3 | 0.3 | 0.3 | 0.3
IND-00001234-000 | 33 | 1 | EA | INDUCTOR 1UH 20% 11A FIXED PWR COMPOS |  | X | COILCRAFT | XFL4020-102MEC | XFL4020-102MEB | COILCRAFT |  | 8 | 266 | 100 | FCA |  |  |  | USD | USD |  | 1.85 | 1.85 | 1.55 | 1.55 | 0.75 | 0.75
IND-00001270-000 | 37 | 2 | EA | IND .47UH 5.5A XFL4012 |  | X | COILCRAFT | XFL4012-471MEC |  | COILCRAFT |  | 8 | 376 | 1 | FCA |  |  |  | USD | USD |  | 1.23 | 2.46 | 1.23 | 2.46 | 0.68 | 1.36
ICS-00001298-000 | 81 | 2 | EA | IC REG BUCK SYNC 3.3V 3A 16QFN |  | X | TI | TPS62091RGTT | TPS62091RGTT | MOUSER ELE |  | 6 | 939 | 1 | N/A |  |  | QUOTE VALID FOR 30 DAYS - VOLTAGE REGULATORS - SWITCHING REGULATORS 3A,2.5-6VIN,97% EFF SYNC SD CONVERTER | USD | USD |  | 2.26 | 4.52 | 2.26 | 4.52 | 1.22 | 2.44
PCB-00001143-002 | 90 | 1 | EA | PCB,(FAB),FMC,MAIN,OPENXC |  | X | HALLCIRCT | PCB-00001143-001 |  | HALLCIRCT |  | 5 |  | 50 |  |  |  |  | USD | USD |  | 90.93 | 90.93 | 68.75 | 68.75 | 23.85 | 23.85
RES-00001597-000 | 91 | 1 | EA | RES SMD 2.15K OHM 1% 1/20W 0201 |  | X | PANASONIC | ERJ-1GNF2151C | ERJ-1GNF2151C | MOUSER ELE |  | 10 | 0 | 1 | N/A |  |  | QUOTE VALID FOR 30 DAYS - THICK FILM RESISTORS - SMD 0201 2.15KOHM 1% HALOGEN FREE | USD | USD |  | 0.041 | 0.041 | 0.017 | 0.017 | 0.017 | 0.017
HIGH IMPACT EXCESS ITEMS
Part Number | Description | Part Qty | Mfg ID | Mfg Part Number | Supp ID | MOQ | Pkg Qty | Volume #1 | Cost #1 | Part Excess Qty #1 | Ext Excess Cost #1 | Volume #2 | Cost #2 | Part Excess Qty #2 | Ext Excess Cost #2 | Volume #3 | Cost #3 | Part Excess Qty #3 | Ext Excess Cost #3
ICS-00001295-000 | IC DDR2 SDRAM 1GBIT 2.5NS 84FBGA | 2 | MICRON | MT47H64M16HR-25E:H TR | DIGIKEY | 1000 | 1000 | 100 | 3.3 | 900 | 2970 | 200 | 3.3 | 800 | 2640 | 1000 | 3.3 |  | 0
CON-00001229-000 | CONN SOCKET MEMORY PCI-E 8H TYPE I PKG G/F 52P | 1 | TE CONNEC | 1759503-1 | ARROW | 2400 | 400 | 50 | 1.77 | 2350 | 4159.5 | 100 | 1.77 | 2300 | 4071 | 500 | 1.77 | 1900 | 3363
