openxc/openxc-accessories/docs/mechanical/Modem/MCH-00001326-000.IGS

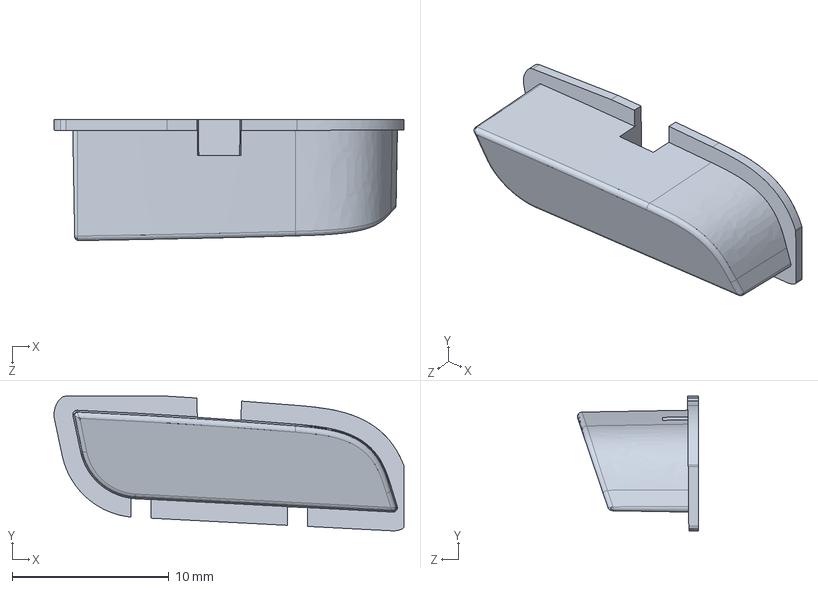
[picture p16: CAD file, 2017-11-17]
docs/mechanical/Modem/MCH-00001326-000.IGS
22.4 x 8.60 x 7.74 mm
