openxc/openxc-accessories/docs/mechanical/V2X/MCH-00002537-000.IGS

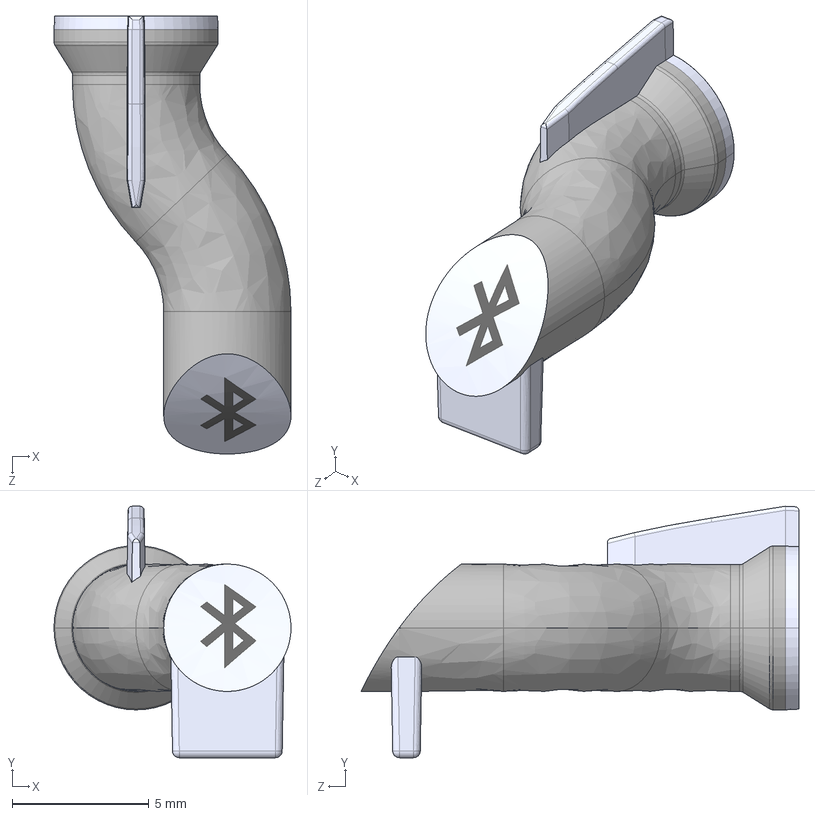
[picture p17: CAD file, 2017-11-17]
docs/mechanical/V2X/MCH-00002537-000.IGS
8.66 x 9.19 x 16.0 mm
