openxc/openxc-accessories/docs/mechanical/Modem/MCH-00001846-000.IGS

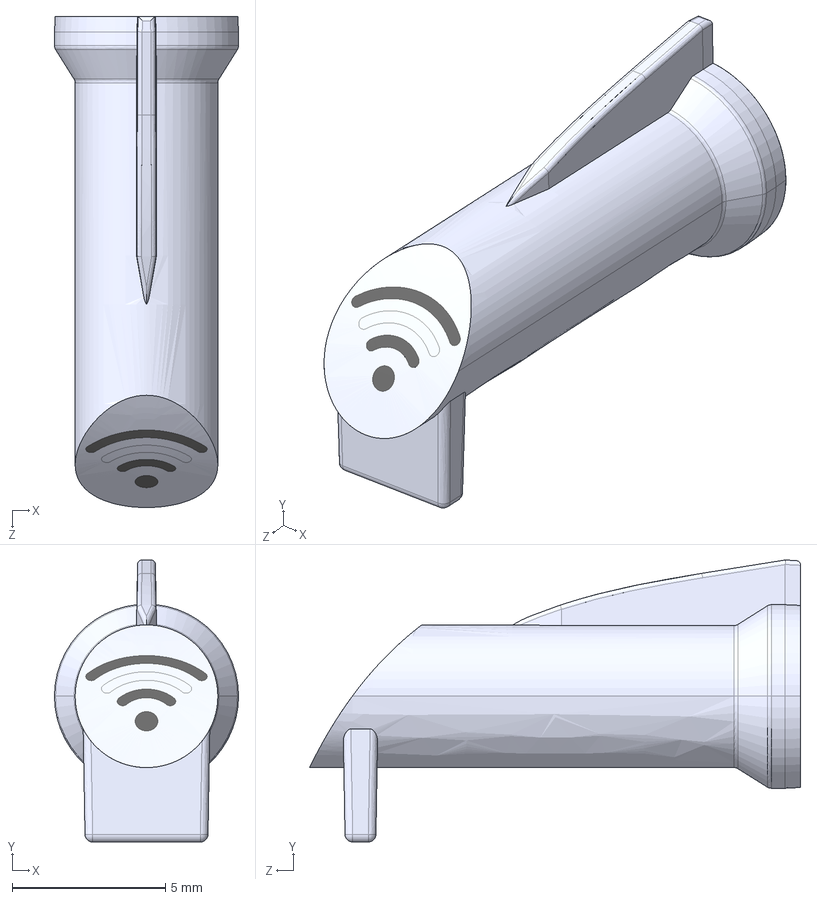
[picture p18: CAD file, 2017-11-17]
docs/mechanical/Modem/MCH-00001846-000.IGS
6.00 x 9.19 x 16.0 mm
