openxc/openxc-accessories/docs/mechanical/V2X/ELC-00002541-000.IGS

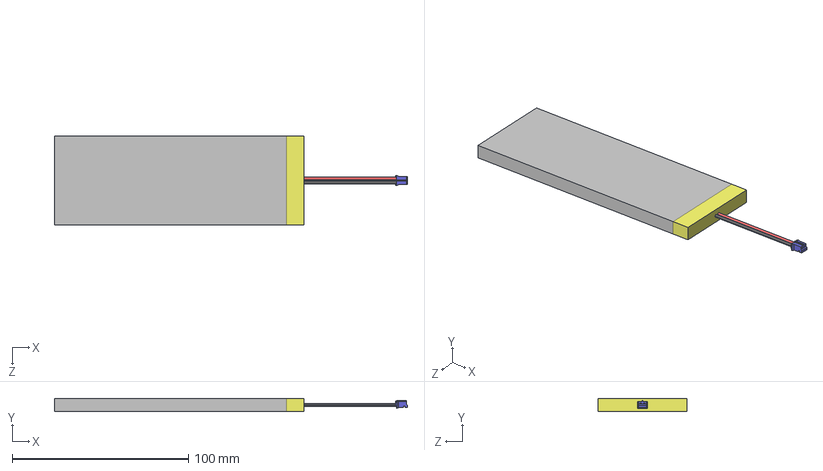
[picture p19: CAD file, 2017-11-17]
docs/mechanical/V2X/ELC-00002541-000.IGS
200.2 x 7.60 x 50.5 mm
