openxc/openxc-accessories/docs/mechanical/V2X/MCH-00002535-000.DXF

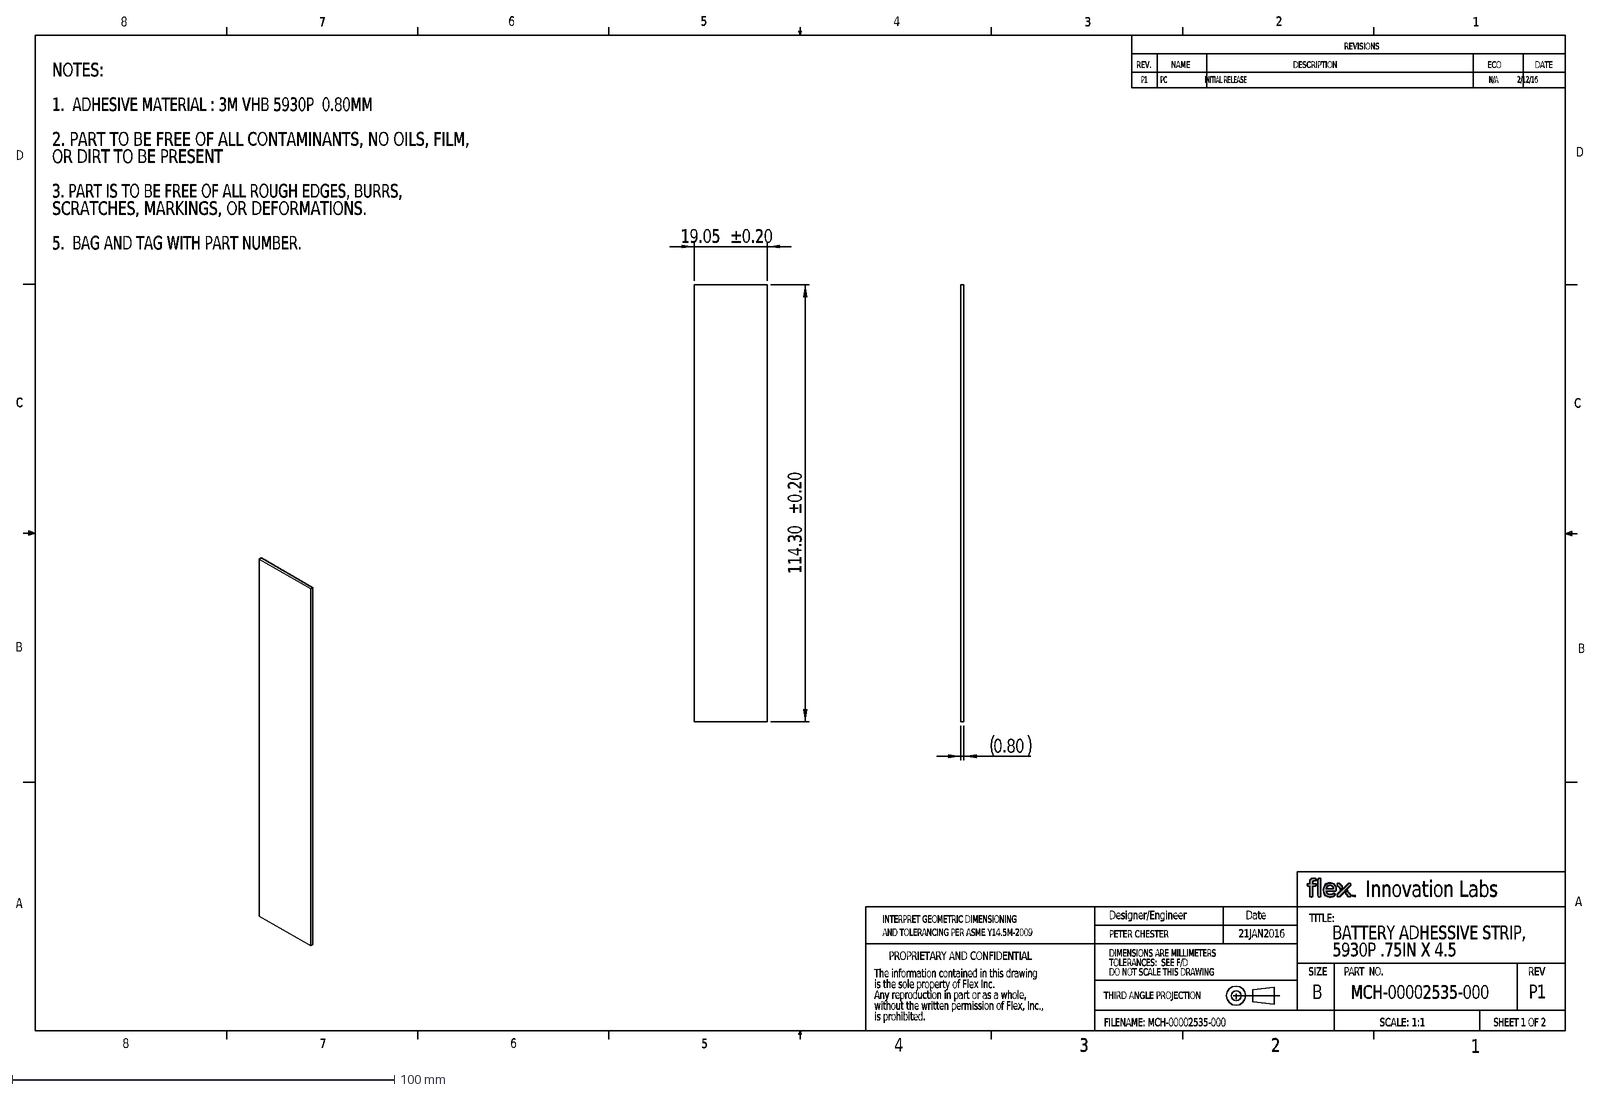
[picture p20: CAD file, 2017-11-17]
docs/mechanical/V2X/MCH-00002535-000.DXF
N/A 2/12/16
REVISIONS
P1 PC INITIAL RELEASE
NAME
DATE
ECO
DESCRIPTION
REV.
NOTES:
1. ADHESIVE MATERIAL : 3M VHB 5930P 0.80MM
2. PART TO BE FREE OF ALL CONTAMINANTS, NO OILS, FILM,
OR DIRT TO BE PRESENT
3. PART IS TO BE FREE OF ALL ROUGH EDGES, BURRS,
SCRATCHES, MARKINGS, OR DEFORMATIONS.
5. BAG AND TAG WITH PART NUMBER.
D
C
B
A
1
2
3
4
5
6
7
8
The information contained in this drawing
is the sole property of Flex Inc.
Any reproduction in part or as a whole,
without the written permission of Flex, Inc.,
is prohibited.
PROPRIETARY AND CONFIDENTIAL
FILENAME: MCH-00002535-000
Date
Designer/Engineer
Innovation Labs
TITLE:
SIZE
PART NO.
REV
SCALE: 1:1
BATTERY ADHESSIVE STRIP,
5930P .75IN X 4.5
MCH-00002535-000
P1
SHEET 1 OF 2
DIMENSIONS ARE MILLIMETERS
TOLERANCES: SEE F/D
DO NOT SCALE THIS DRAWING
PETER CHESTER
21JAN2016
THIRD ANGLE PROJECTION
INTERPRET GEOMETRIC DIMENSIONING
AND TOLERANCING PER ASME Y14.5M-2009
114.30
±0.20
19.05
0.80
