openxc/openxc-accessories/(list of files, cad)

Other CAD files:
docs/mechanical/Modem/MCH-00001842-000.IGS
docs/mechanical/V2X/MCH-00001326-000.IGS
docs/mechanical/Modem/MCH-00001845-000.IGS
docs/mechanical/V2X/MCH-00002538-000.IGS
docs/mechanical/Modem/MCH-00001844-000.IGS
docs/mechanical/V2X/MCH-00001842-000.IGS
docs/mechanical/Modem/MCH-00001843-000.IGS
docs/mechanical/V2X/MCH-00002539-000.IGS
