openxc/openxc-accessories/tools/ModemConnect/Documents/OpenXC Modem Connect App Installation Procedure.docx

REVISION HISTORY
Revision | Description of Change | | Writer/Reviser | | Effective Date
0.1 | Initial Version | | Anthony-Hung Tran
Author Name | | Title | | Department Name
Anthony-Hung Tran | | OpenXC-Modem Connect PC App Installation Procedure

APPROVERS

Name | Title | Department | Approval Status | Approval Date
Anthony-Hung Tran | Software Engineer

ABOUT FLEXTRONICS

Flextronics is a leading Electronics Manufacturing Services (EMS) provider focused on delivering complete design, engineering and manufacturing services to automotive, computing, consumer, industrial, infrastructure, medical, clean tech and mobile OEMs. Flextronics helps customers design, build, ship, and service electronics products through a network of facilities in 30 countries on four continents. This global presence provides design and engineering solutions that are combined with core electronics manufacturing and logistics services, and vertically integrated with components technologies, to optimize customer operations by lowering costs and reducing time to market.

# Table of Contents

# 1 INTRODUCTION

This document describes OpenXC Modem Connect PC Application Installation procedure.

## 1.1 Scope and Purpose of the document

This document demonstrates installation procedure of OpenXC Modem Connect PC Application which would automatically detect OpenXC Modem connectivity to the PC then open or close TeraTerm (or other configured terminal application) on the proper port accordingly.

## 1.2 Intended Audience or Applicability

This document is intended for team members/users who need to install terminal application to connect with an OpenXC Modem

# 2 INSTALLATION PROCEDURE

1. Download the installation package (ModemConnect-v1.0.0.143.msi) into your PC and invoke the setup wizard.

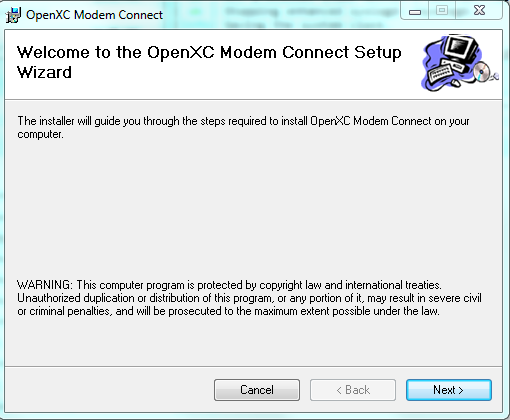
[picture p29: figure]

Figure 1

2. You might also select to install TeraTerm installation as well.

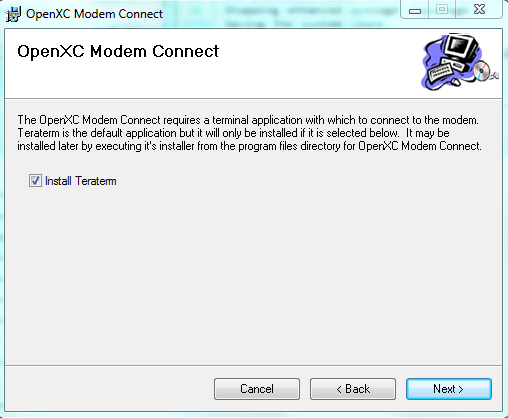
[picture p30: figure]

Figure 2

3. Follow on-screen instructions to select installation options as needed.

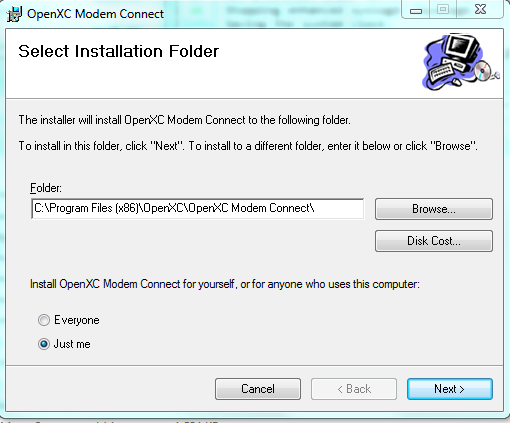
[picture p31: figure]

Figure 3

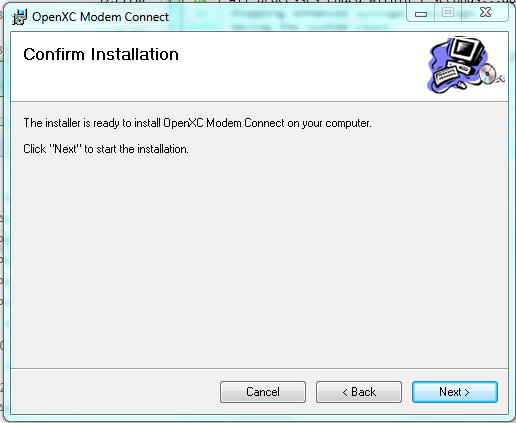
[picture p32: figure]

Figure 4

4. If TereTerm installation option is selected, please follow TeraTerm Setup Wizard instructions to proceed accordingly

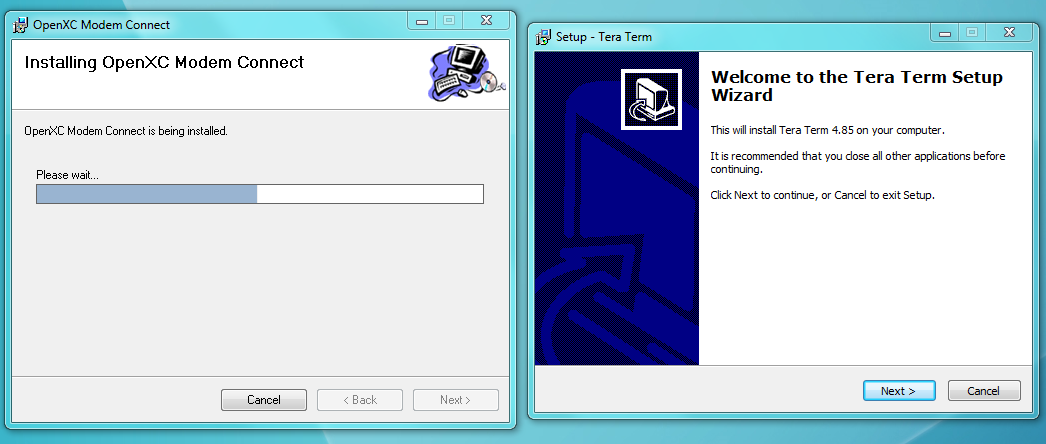
[picture p33: figure]

Figure 5

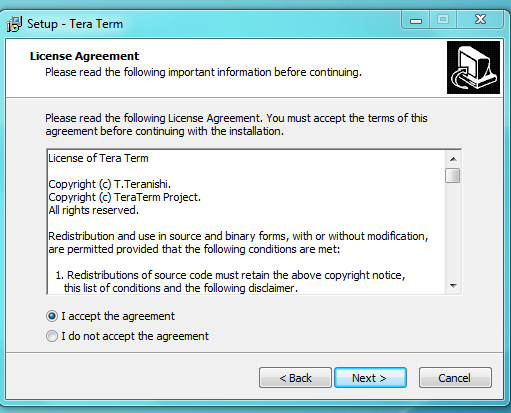
[picture p34: figure]

Figure 6

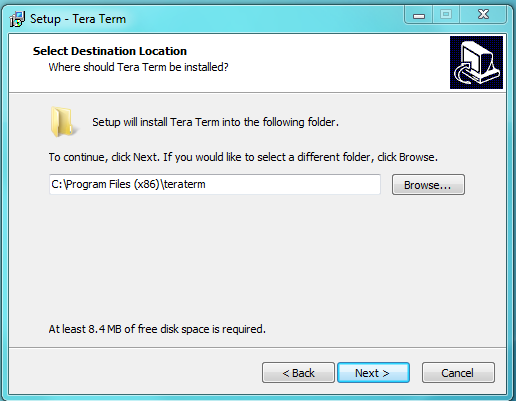
[picture p35: figure]

Figure 7

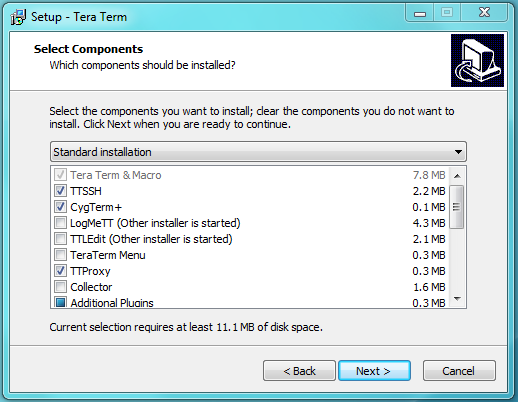
[picture p36: figure]

Figure 8

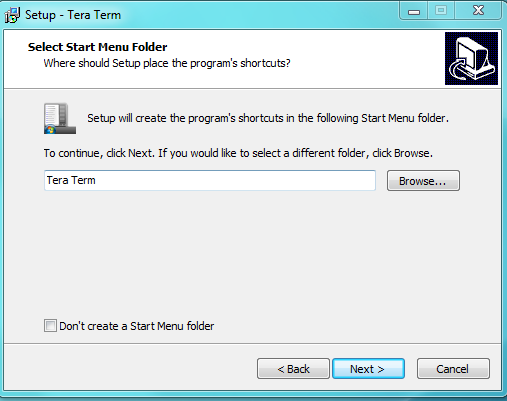
[picture p37: figure]

Figure 9

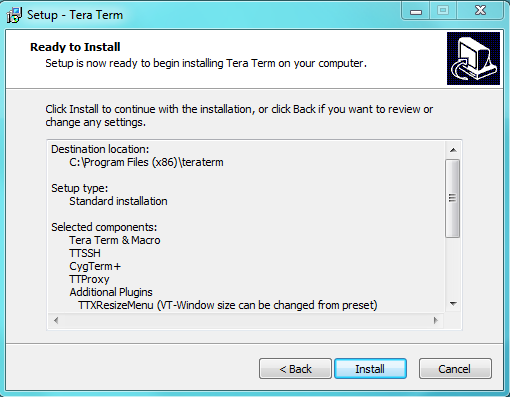
[picture p38: figure]

Figure 10

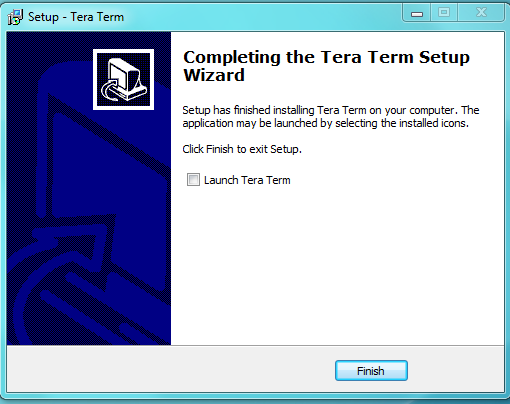
[picture p39: figure]

Figure 11

5. You can close the setup wizard after the installation is completed.

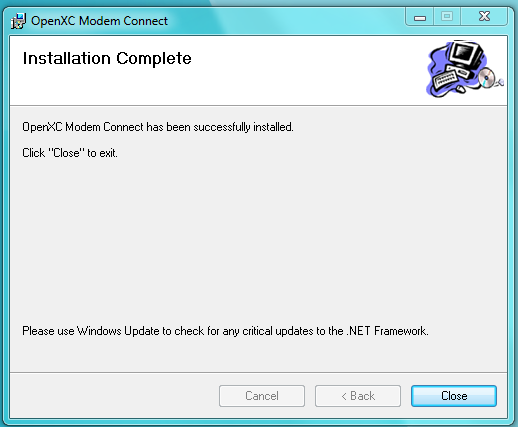
[picture p40: figure]

Figure 12

6. Modem Connect without OpenXC Modem connection or the connection hasn’t yet ready

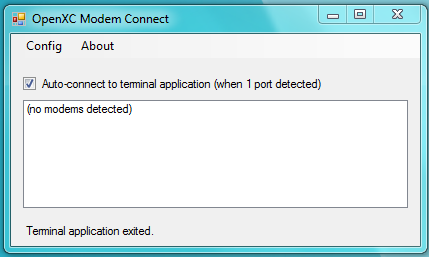
[picture p41: figure]

Figure 13

7. Modem Connect once the connection is ready. You might need to press Enter to obtain log-in prompt

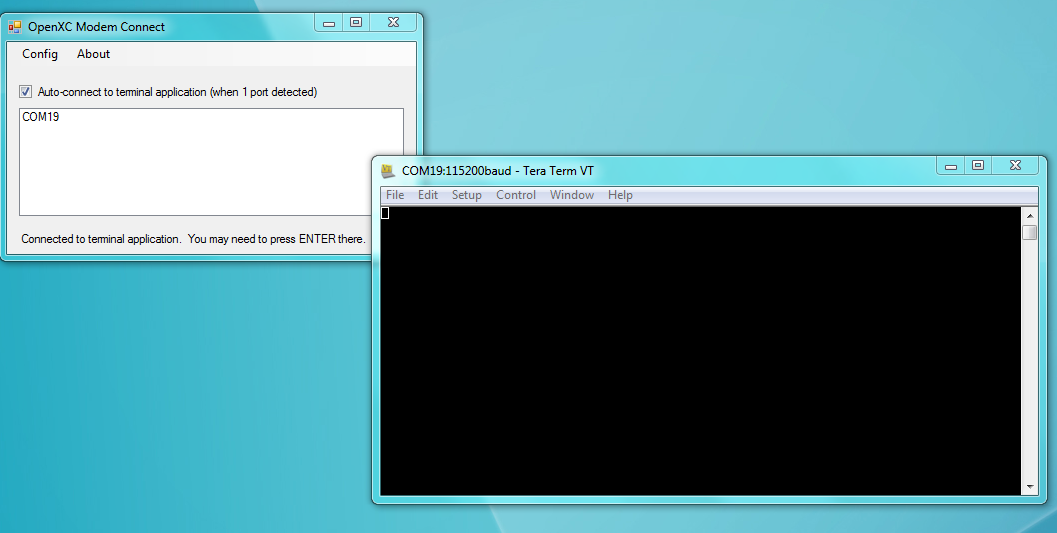
[picture p42: figure]

Figure 14

# 3 REVIEW CHECKLIST

This document should be reviewed using the below checkout.

Number | Checklist Item | Reviewer Name | Reviewed Yes/ No | Review Comments

OpenXC-Modem Connect PC App Installation Procedure Document # : TBD Revision: 0.1 Document Author:

Title: Software Design Document Document #: TBD Revision: 0.1 Document Author:
