openxc/openxc-accessories/docs/assembly/ferrite_sheild1.png

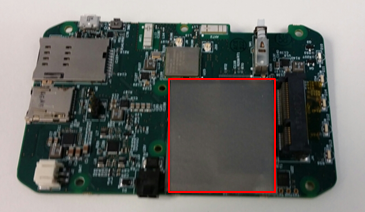
docs/assembly/ferrite_sheild1.png
