openxc/openxc-accessories/docs/assembly/ferrite_sheild2.jpg

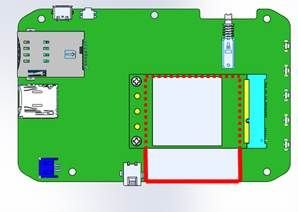
docs/assembly/ferrite_sheild2.jpg
