openxc/openxc-accessories/docs/mechanical/Modem/ELC-00001847-000.PDF

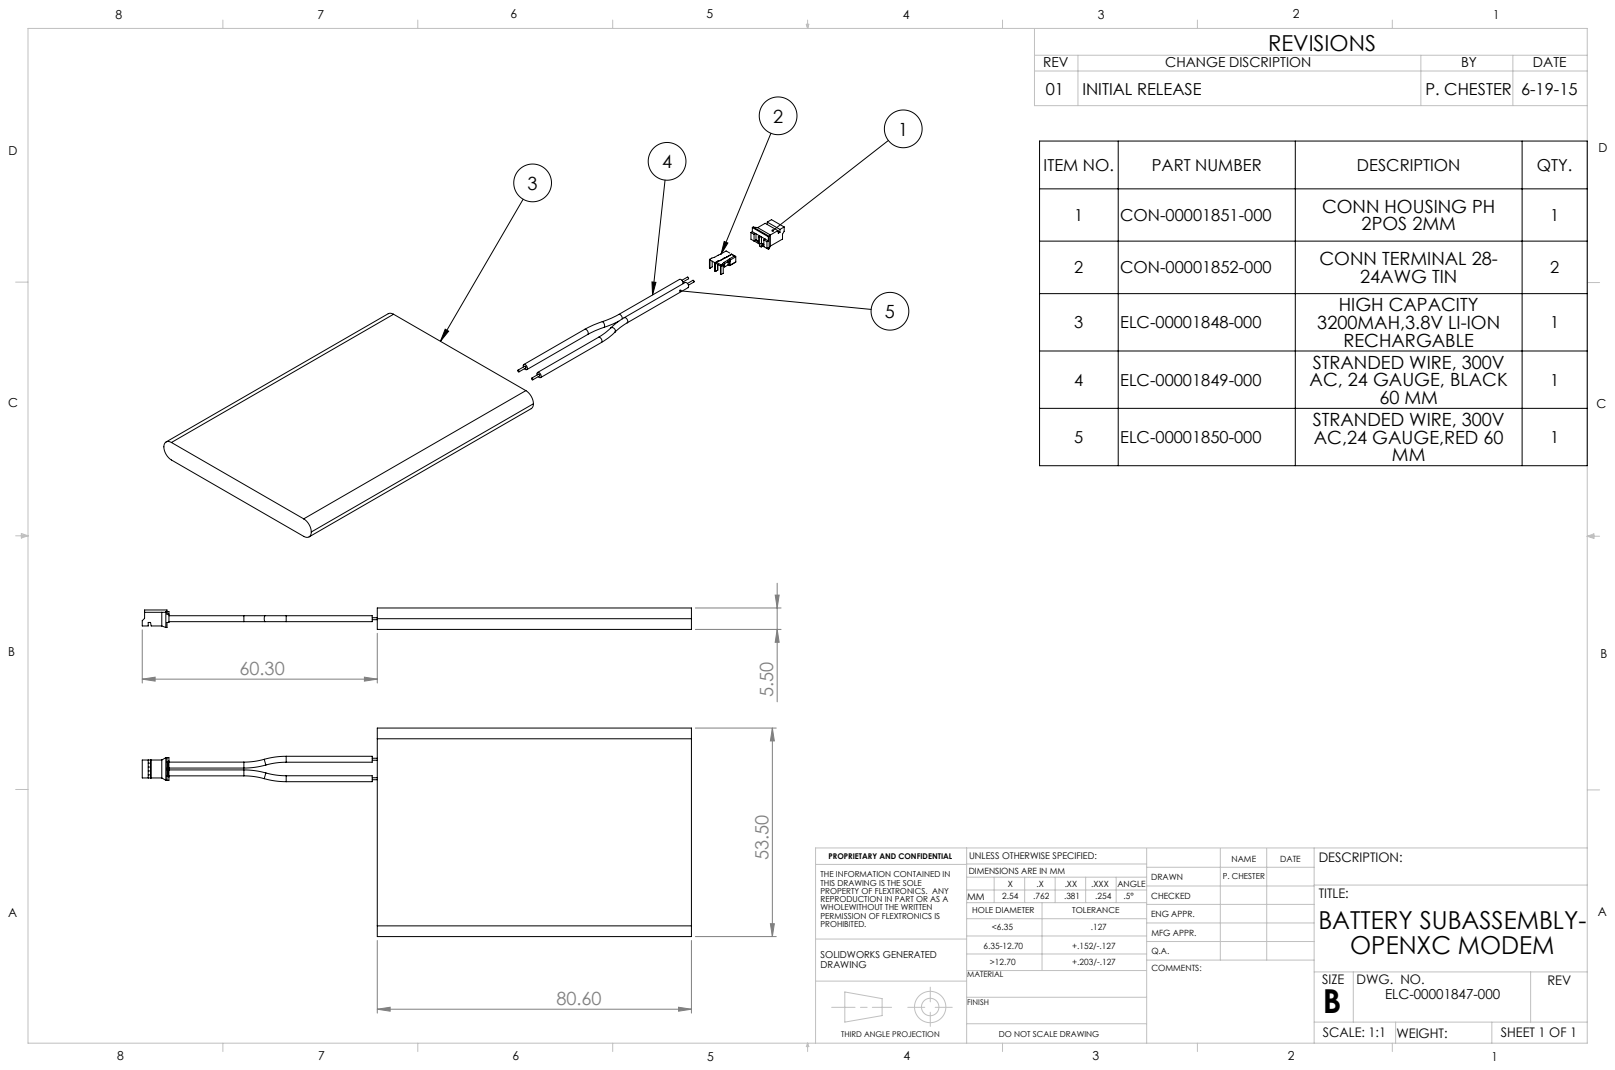
[picture p45: page 1]
ENG APPR.; MFG APPR.; DWG. NO.; REV; SCALE: 1:1 WEIGHT:; UNLESS OTHERWISE SPECIFIED:; P. CHESTER; BATTERY SUBASSEMBLY- OPENXC MODEM; SHEET 1 OF 1; CHANGE DISCRIPTION; DATE; 01 INITIAL RELEASE; P. CHESTER 6-19-15; DIMENSIONS ARE IN MM; .XX .XXX ANGLE; HOLE DIAMETER; TOLERANCE; SOLIDWORKS GENERATED

ITEM NO. | PART NUMBER | DESCRIPTION | QTY.
1 | CON-00001851-000 | CONN HOUSING PH 2POS 2MM | 1

2 | CON-00001852-000 | CONN TERMINAL 28-24AWG TIN | 2

3 | ELC-00001848-000 | HIGH CAPACITY 3200MAH,3.8V LI-ION RECHARGABLE | 1

4 | ELC-00001849-000 | STRANDED WIRE, 300V AC, 24 GAUGE, BLACK 60 MM | 1

5 | ELC-00001850-000 | STRANDED WIRE, 300V AC,24 GAUGE,RED 60 MM | 1

PROPRIETARY AND CONFIDENTIAL
THE INFORMATION CONTAINED IN
THIS DRAWING IS THE SOLE
PROPERTY OF FLEXTRONICS. ANY
REPRODUCTION IN PART OR AS A
WHOLEWITHOUT THE WRITTEN
PERMISSION OF FLEXTRONICS IS
PROHIBITED.

THIRD ANGLE PROJECTION

DO NOT SCALE DRAWING
