openxc/openxc-accessories/docs/mechanical/Modem/MCH-00001326-000.PDF

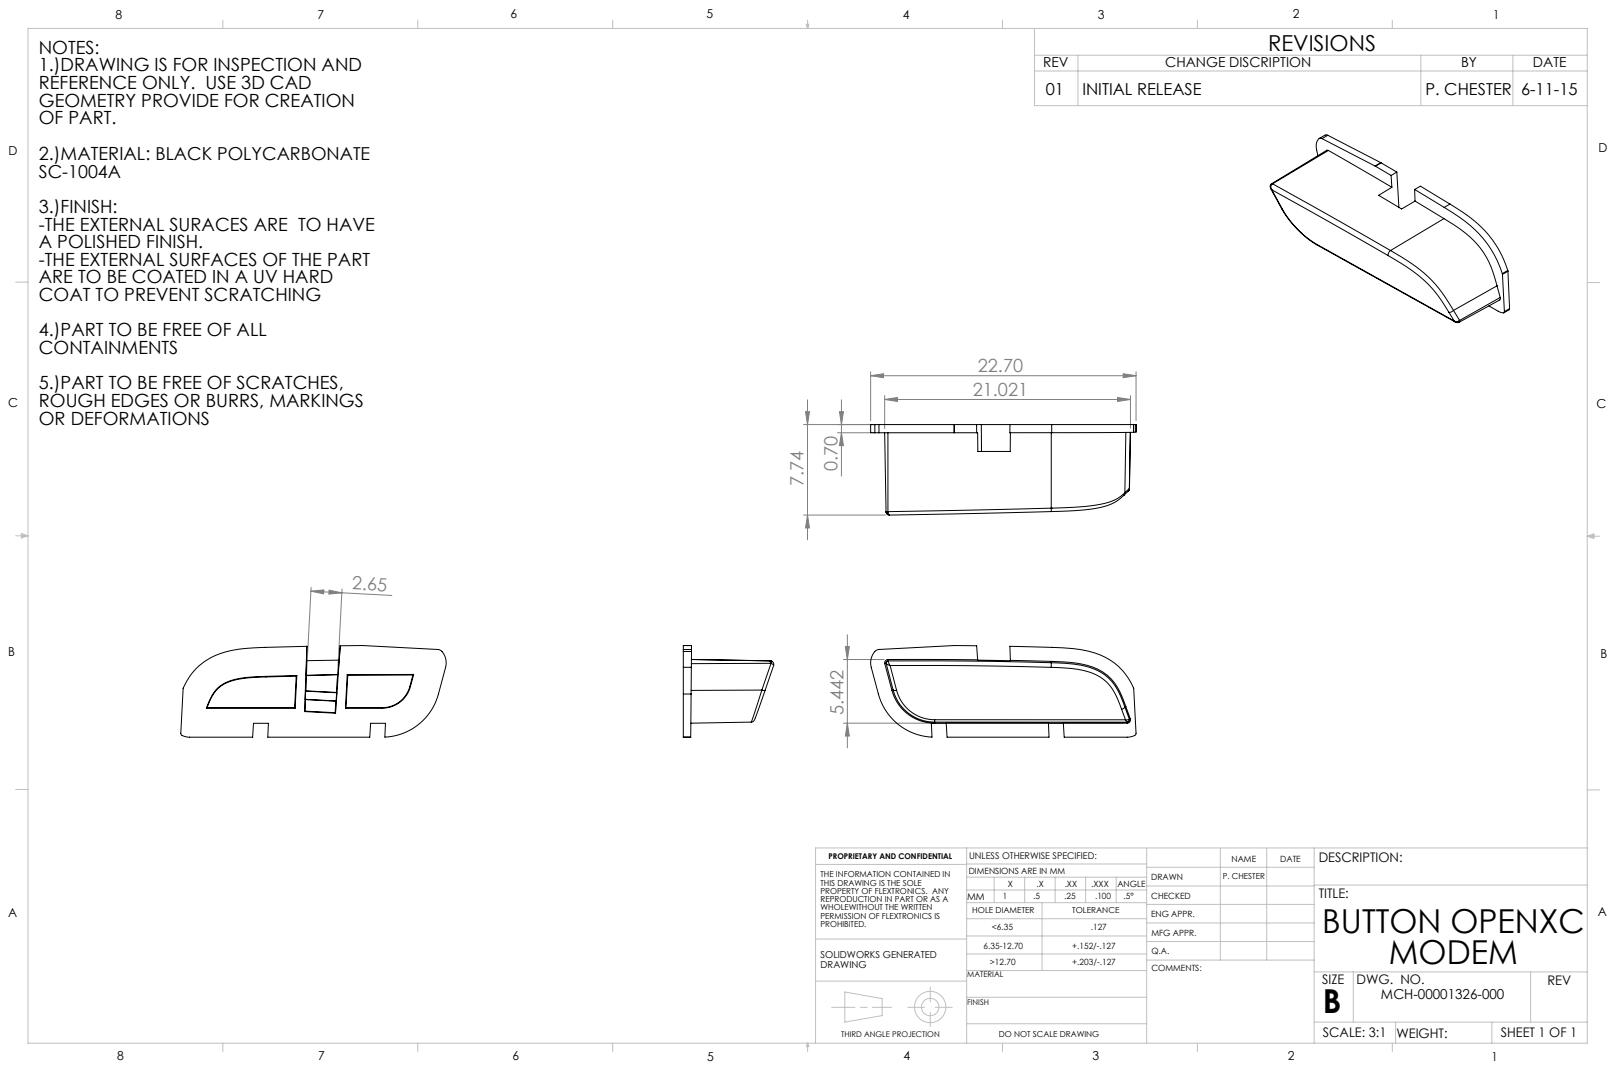
[picture p46: page 1]
ENG APPR.; MFG APPR.; DWG. NO.; REV; SCALE: 3:1 WEIGHT:; UNLESS OTHERWISE SPECIFIED:; P. CHESTER; BUTTON OPENXC; SHEET 1 OF 1; CHANGE DISCRIPTION; DATE; 01 INITIAL RELEASE; P. CHESTER 6-11-15; DIMENSIONS ARE IN MM; .XX .XXX ANGLE; HOLE DIAMETER; TOLERANCE; SOLIDWORKS GENERATED

NOTES:
1.)DRAWING IS FOR INSPECTION AND
REFERENCE ONLY. USE 3D CAD
GEOMETRY PROVIDE FOR CREATION
OF PART.
2.)MATERIAL: BLACK POLYCARBONATE
3.)FINISH:
-THE EXTERNAL SURACES ARE TO HAVE
A POLISHED FINISH.
-THE EXTERNAL SURFACES OF THE PART
ARE TO BE COATED IN A UV HARD
COAT TO PREVENT SCRATCHING
4.)PART TO BE FREE OF ALL
CONTAINMENTS
5.)PART TO BE FREE OF SCRATCHES,
ROUGH EDGES OR BURRS, MARKINGS
OR DEFORMATIONS

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

THIRD ANGLE PROJECTION

DO NOT SCALE DRAWING
