openxc/openxc-accessories/docs/mechanical/Modem/MCH-00001842-000.PDF

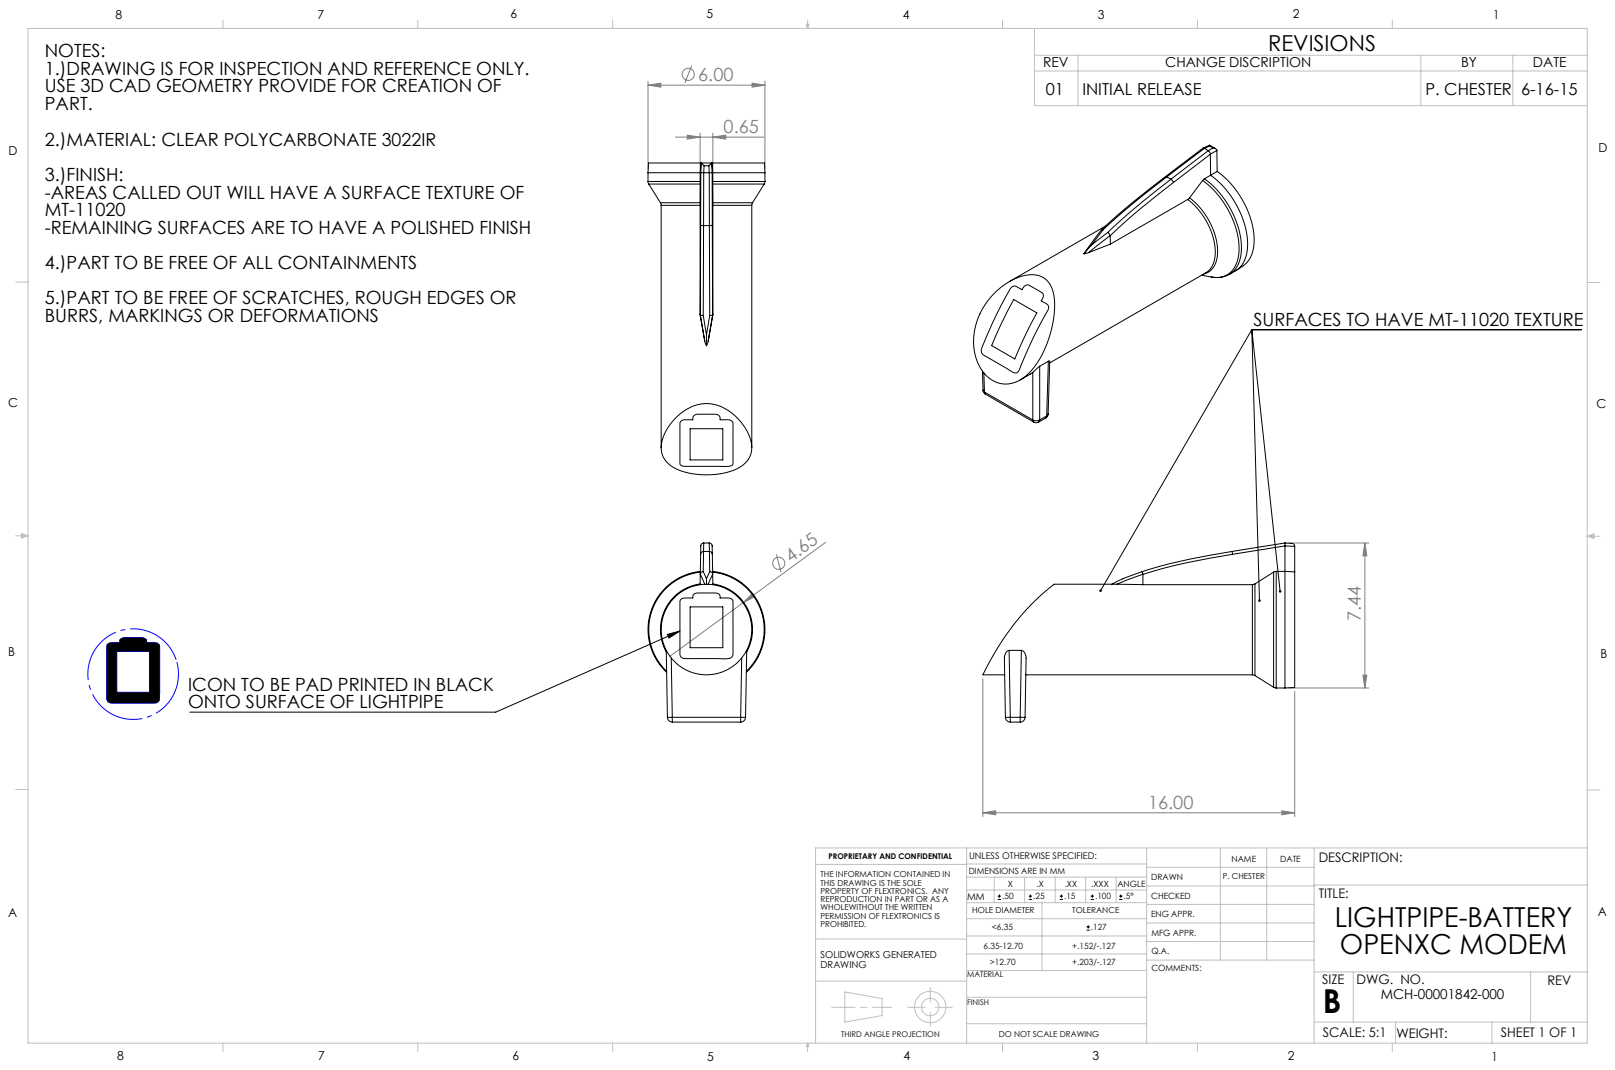
[picture p47: page 1]
ENG APPR.; MFG APPR.; DWG. NO.; REV; SCALE: 5:1 WEIGHT:; UNLESS OTHERWISE SPECIFIED:; P. CHESTER; OPENXC MODEM; SHEET 1 OF 1; CHANGE DISCRIPTION; DATE; 01 INITIAL RELEASE; P. CHESTER 6-16-15; DIMENSIONS ARE IN MM; .XX .XXX ANGLE; HOLE DIAMETER; TOLERANCE; SOLIDWORKS GENERATED

NOTES:
1.)DRAWING IS FOR INSPECTION AND REFERENCE ONLY.
USE 3D CAD GEOMETRY PROVIDE FOR CREATION OF
PART.
2.)MATERIAL: CLEAR POLYCARBONATE 3022IR
3.)FINISH:
-AREAS CALLED OUT WILL HAVE A SURFACE TEXTURE OF
-REMAINING SURFACES ARE TO HAVE A POLISHED FINISH
4.)PART TO BE FREE OF ALL CONTAINMENTS
5.)PART TO BE FREE OF SCRATCHES, ROUGH EDGES OR
BURRS, MARKINGS OR DEFORMATIONS

SURFACES TO HAVE MT-11020 TEXTURE

ICON TO BE PAD PRINTED IN BLACK
ONTO SURFACE OF LIGHTPIPE

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

THIRD ANGLE PROJECTION

DO NOT SCALE DRAWING
