openxc/openxc-accessories/docs/mechanical/Modem/TLA-00001300-001.PDF

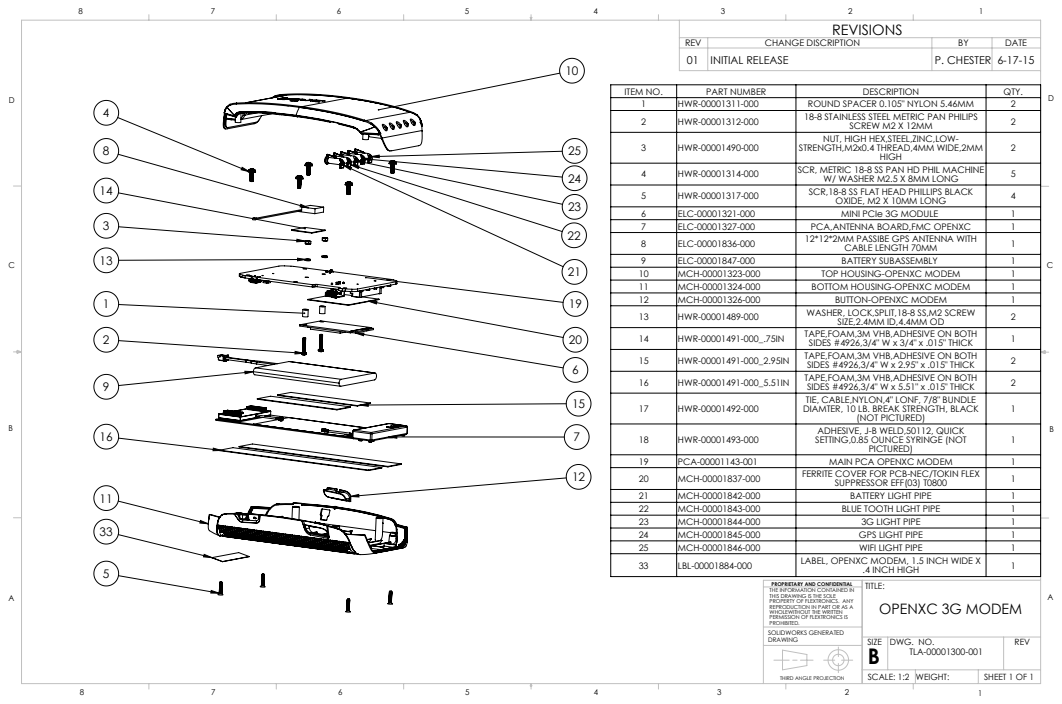
[picture p48: page 1]
PROPRIETARY AND CONFIDENTIAL; TITLE:; SIZE B; DWG. NO.; REV; SCALE: 1:2 WEIGHT:; OPENXC 3G MODEM; SHEET 1 OF 1; CHANGE DISCRIPTION; DATE; 01 INITIAL RELEASE; P. CHESTER 6-17-15

ITEM NO. | HWR-00001311-000 HWR-00001312-000 PART NUMBER | 18-8 STAINLESS STEEL METRIC PAN PHILIPS ROUND SPACER 0.105" NYLON 5.46MM DESCRIPTION | QTY. 1 2 2

SCREW M2 X 12MM | 2

3 | HWR-00001490-000 | NUT, HIGH HEX,STEEL,ZINC,LOW-STRENGTH,M2x0.4 THREAD,4MM WIDE,2MM HIGH | 2

4 | HWR-00001314-000 | SCR, METRIC 18-8 SS PAN HD PHIL MACHINE W/ WASHER M2.5 X 8MM LONG | 5
5 | HWR-00001317-000 | SCR,18-8 SS FLAT HEAD PHILLIPS BLACK OXIDE, M2 X 10MM LONG | 4
6 | ELC-00001321-000 | MINI PCIe 3G MODULE | 1
7 | ELC-00001327-000 | PCA,ANTENNA BOARD,FMC OPENXC | 1
8 | ELC-00001836-000 | 12*12*2MM PASSIBE GPS ANTENNA WITH CABLE LENGTH 70MM | 1
9 | ELC-00001847-000 | BATTERY SUBASSEMBLY | 1
10 | MCH-00001323-000 | TOP HOUSING-OPENXC MODEM | 1
11 | MCH-00001324-000 | BOTTOM HOUSING-OPENXC MODEM | 1
12 | MCH-00001326-000 | BUTTON-OPENXC MODEM | 1
13 | HWR-00001489-000 | WASHER, LOCK,SPLIT,18-8 SS,M2 SCREW SIZE,2.4MM ID,4.4MM OD | 2
14 | HWR-00001491-000_.75IN | TAPE,FOAM,3M VHB,ADHESIVE ON BOTH SIDES #4926,3/4" W x 3/4" x .015" THICK | 1
15 | HWR-00001491-000_2.95IN | TAPE,FOAM,3M VHB,ADHESIVE ON BOTH SIDES #4926,3/4" W x 2.95" x .015" THICK | 2
16 | HWR-00001491-000_5.51IN | TAPE,FOAM,3M VHB,ADHESIVE ON BOTH SIDES #4926,3/4" W x 5.51" x .015" THICK | 2
17 | HWR-00001492-000 | TIE, CABLE,NYLON,4" LONF, 7/8" BUNDLE DIAMTER, 10 LB. BREAK STRENGTH, BLACK (NOT PICTURED) | 1

18 | HWR-00001493-000 | ADHESIVE, J-B WELD,50112, QUICK SETTING,0.85 OUNCE SYRINGE (NOT PICTURED) | 1

19 | PCA-00001143-001 | MAIN PCA OPENXC MODEM | 1
20 | MCH-00001837-000 | FERRITE COVER FOR PCB-NEC/TOKIN FLEX SUPPRESSOR EFF(03) T0800 | 1
21 | MCH-00001842-000 | BATTERY LIGHT PIPE | 1
22 | MCH-00001843-000 | BLUE TOOTH LIGHT PIPE | 1
23 | MCH-00001844-000 | 3G LIGHT PIPE | 1
24 | MCH-00001845-000 | GPS LIGHT PIPE | 1
25 | MCH-00001846-000 | WIFI LIGHT PIPE | 1
33 | LBL-00001884-000 | LABEL, OPENXC MODEM, 1.5 INCH WIDE X .4 INCH HIGH | 1

THE INFORMATION CONTAINED IN
THIS DRAWING IS THE SOLE
PROPERTY OF FLEXTRONICS. ANY
REPRODUCTION IN PART OR AS A
WHOLEWITHOUT THE WRITTEN
PERMISSION OF FLEXTRONICS IS
PROHIBITED.
SOLIDWORKS GENERATED
DRAWING

THIRD ANGLE PROJECTION
