openxc/openxc-accessories/docs/mechanical/V2X/ASY-00001506-001.PDF

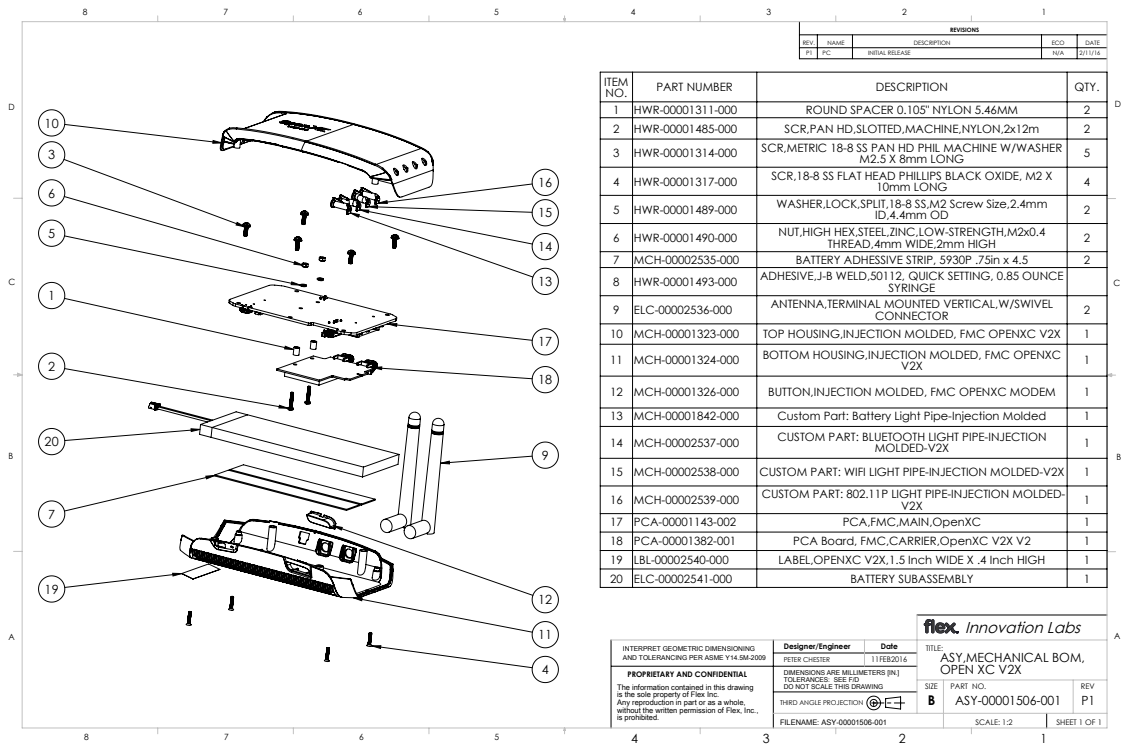
[picture p49: page 1]
INITIAL RELEASE; PART NO.; REV; SCALE: 1:2; SHEET 1 OF 1; PETER CHESTER; 11FEB2016

ITEM
NO. | HWR-00001311-000 HWR-00001485-000 HWR-00001314-000 PART NUMBER | SCR,METRIC 18-8 SS PAN HD PHIL MACHINE W/WASHER SCR,PAN HD,SLOTTED,MACHINE,NYLON,2x12m ROUND SPACER 0.105" NYLON 5.46MM DESCRIPTION | QTY. 1 2 2 2 3

M2.5 X 8mm LONG | 5

4 | HWR-00001317-000 | SCR,18-8 SS FLAT HEAD PHILLIPS BLACK OXIDE, M2 X 10mm LONG | 4
5 | HWR-00001489-000 | WASHER,LOCK,SPLIT,18-8 SS,M2 Screw Size,2.4mm ID,4.4mm OD | 2
6 | HWR-00001490-000 | NUT,HIGH HEX,STEEL,ZINC,LOW-STRENGTH,M2x0.4 THREAD,4mm WIDE,2mm HIGH | 2
7 | MCH-00002535-000 | BATTERY ADHESSIVE STRIP, 5930P .75in x 4.5 | 2
8 | HWR-00001493-000 | ADHESIVE,J-B WELD,50112, QUICK SETTING, 0.85 OUNCE SYRINGE
9 | ELC-00002536-000 | ANTENNA,TERMINAL MOUNTED VERTICAL,W/SWIVEL CONNECTOR | 2

10 | MCH-00001323-000 | TOP HOUSING,INJECTION MOLDED, FMC OPENXC V2X | 1
11 | MCH-00001324-000 | BOTTOM HOUSING,INJECTION MOLDED, FMC OPENXC V2X | 1

12 | MCH-00001326-000 | BUTTON,INJECTION MOLDED, FMC OPENXC MODEM | 1
13 | MCH-00001842-000 | Custom Part: Battery Light Pipe-Injection Molded | 1
14 | MCH-00002537-000 | CUSTOM PART: BLUETOOTH LIGHT PIPE-INJECTION MOLDED-V2X | 1

15 | MCH-00002538-000 | CUSTOM PART: WIFI LIGHT PIPE-INJECTION MOLDED-V2X | 1
16 | MCH-00002539-000 | CUSTOM PART: 802.11P LIGHT PIPE-INJECTION MOLDED-V2X | 1
17 | PCA-00001143-002 | PCA,FMC,MAIN,OpenXC | 1
18 | PCA-00001382-001 | PCA Board, FMC,CARRIER,OpenXC V2X V2 | 1
19 | LBL-00002540-000 | LABEL,OPENXC V2X,1.5 Inch WIDE X .4 Inch HIGH | 1
20 | ELC-00002541-000 | BATTERY SUBASSEMBLY | 1

Innovation Labs
ASY,MECHANICAL BOM,
OPEN XC V2X
SIZE B
ASY-00001506-001 P1

INTERPRET GEOMETRIC DIMENSIONING
AND TOLERANCING PER ASME Y14.5M-2009
PROPRIETARY AND CONFIDENTIAL
The information contained in this drawing
is the sole property of Flex Inc.
Any reproduction in part or as a whole,
without the written permission of Flex, Inc.,
is prohibited.

DIMENSIONS ARE MILLIMETERS [IN.]
TOLERANCES: SEE F/D
DO NOT SCALE THIS DRAWING
THIRD ANGLE PROJECTION
FILENAME: ASY-00001506-001
