openxc/openxc-accessories/docs/mechanical/V2X/ELC-00002541-000.PDF

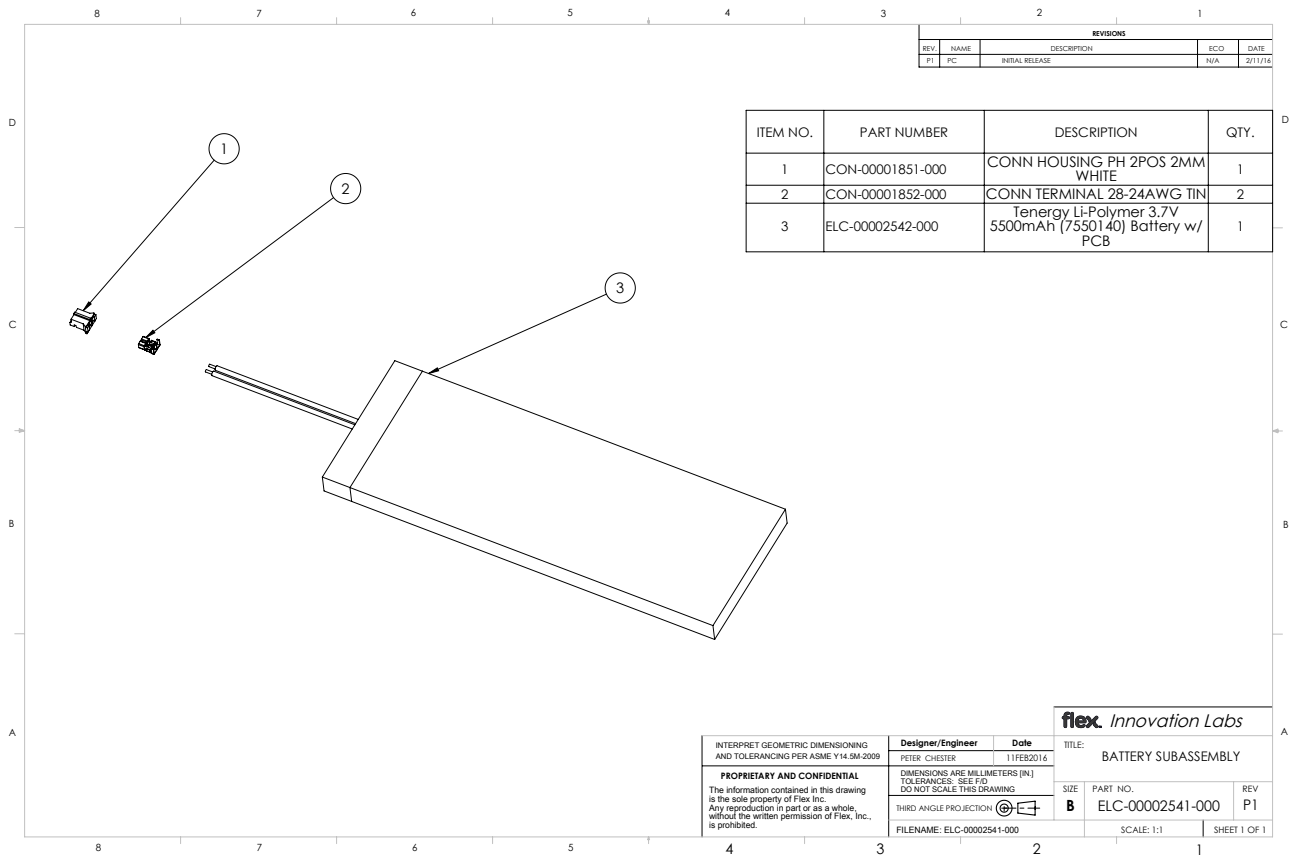
[picture p50: page 1]
INITIAL RELEASE; Innovation Labs; PART NO.; REV; SCALE: 1:1; BATTERY SUBASSEMBLY; ELC-00002541-000 P1; SHEET 1 OF 1; PETER CHESTER; 11FEB2016

ITEM NO. | PART NUMBER | DESCRIPTION | QTY.
1 | CON-00001851-000 | CONN HOUSING PH 2POS 2MM WHITE | 1
2 | CON-00001852-000 | CONN TERMINAL 28-24AWG TIN | 2
3 | ELC-00002542-000 | Tenergy Li-Polymer 3.7V 5500mAh (7550140) Battery w/ PCB | 1

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

DIMENSIONS ARE MILLIMETERS [IN.]
TOLERANCES: SEE F/D
DO NOT SCALE THIS DRAWING
THIRD ANGLE PROJECTION
FILENAME: ELC-00002541-000
