openxc/openxc-accessories/docs/mechanical/V2X/MCH-00001324-000.PDF

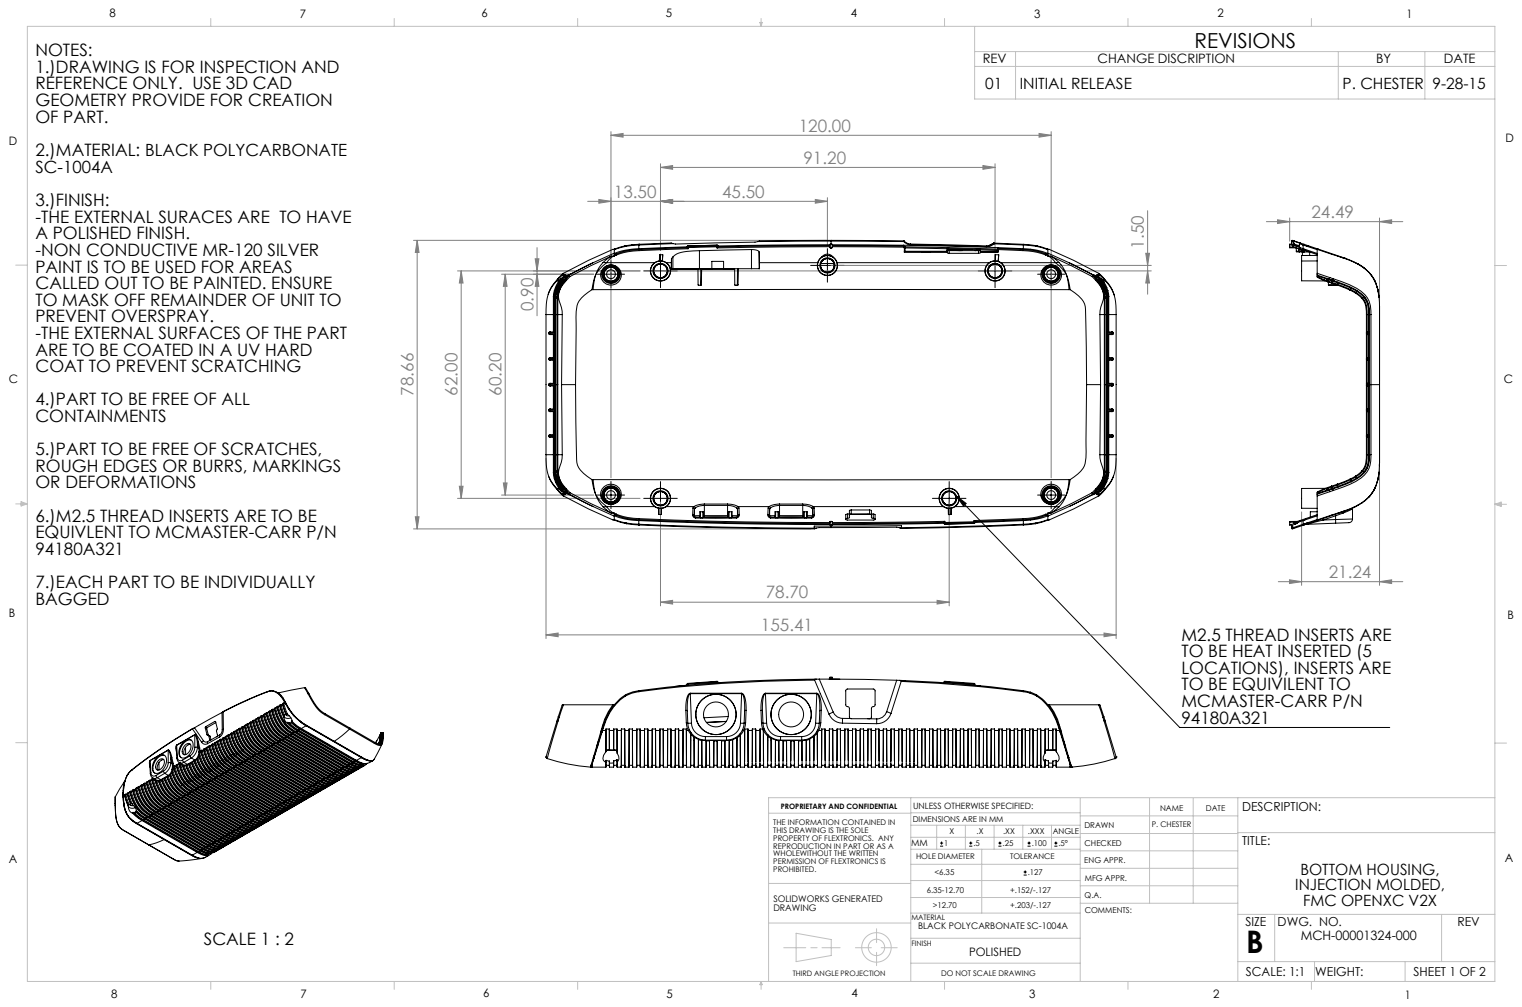
[picture p53: page 1]
SCALE 1 : 2; BLACK POLYCARBONATE SC-1004A; ENG APPR.; MFG APPR.; DWG. NO.; REV; SCALE: 1:1 WEIGHT:; UNLESS OTHERWISE SPECIFIED:; P. CHESTER; BOTTOM HOUSING, INJECTION MOLDED, FMC OPENXC V2X; SHEET 1 OF 2; CHANGE DISCRIPTION; DATE; 01 INITIAL RELEASE; P. CHESTER 9-28-15; DIMENSIONS ARE IN MM; .XX .XXX ANGLE; HOLE DIAMETER; TOLERANCE; SOLIDWORKS GENERATED

NOTES:
1.)DRAWING IS FOR INSPECTION AND
REFERENCE ONLY. USE 3D CAD
GEOMETRY PROVIDE FOR CREATION
OF PART.
2.)MATERIAL: BLACK POLYCARBONATE
3.)FINISH:
-THE EXTERNAL SURACES ARE TO HAVE
A POLISHED FINISH.
-NON CONDUCTIVE MR-120 SILVER
PAINT IS TO BE USED FOR AREAS
CALLED OUT TO BE PAINTED. ENSURE
TO MASK OFF REMAINDER OF UNIT TO
PREVENT OVERSPRAY.
-THE EXTERNAL SURFACES OF THE PART
ARE TO BE COATED IN A UV HARD
COAT TO PREVENT SCRATCHING
4.)PART TO BE FREE OF ALL
CONTAINMENTS
5.)PART TO BE FREE OF SCRATCHES,
ROUGH EDGES OR BURRS, MARKINGS
OR DEFORMATIONS
6.)M2.5 THREAD INSERTS ARE TO BE
EQUIVLENT TO MCMASTER-CARR P/N
7.)EACH PART TO BE INDIVIDUALLY
BAGGED

M2.5 THREAD INSERTS ARE
TO BE HEAT INSERTED (5
LOCATIONS), INSERTS ARE
TO BE EQUIVILENT TO
MCMASTER-CARR P/N

PROPRIETARY AND CONFIDENTIAL
THE INFORMATION CONTAINED IN
THIS DRAWING IS THE SOLE
PROPERTY OF FLEXTRONICS. ANY
REPRODUCTION IN PART OR AS A
WHOLEWITHOUT THE WRITTEN
PERMISSION OF FLEXTRONICS IS
PROHIBITED.

THIRD ANGLE PROJECTION

DO NOT SCALE DRAWING

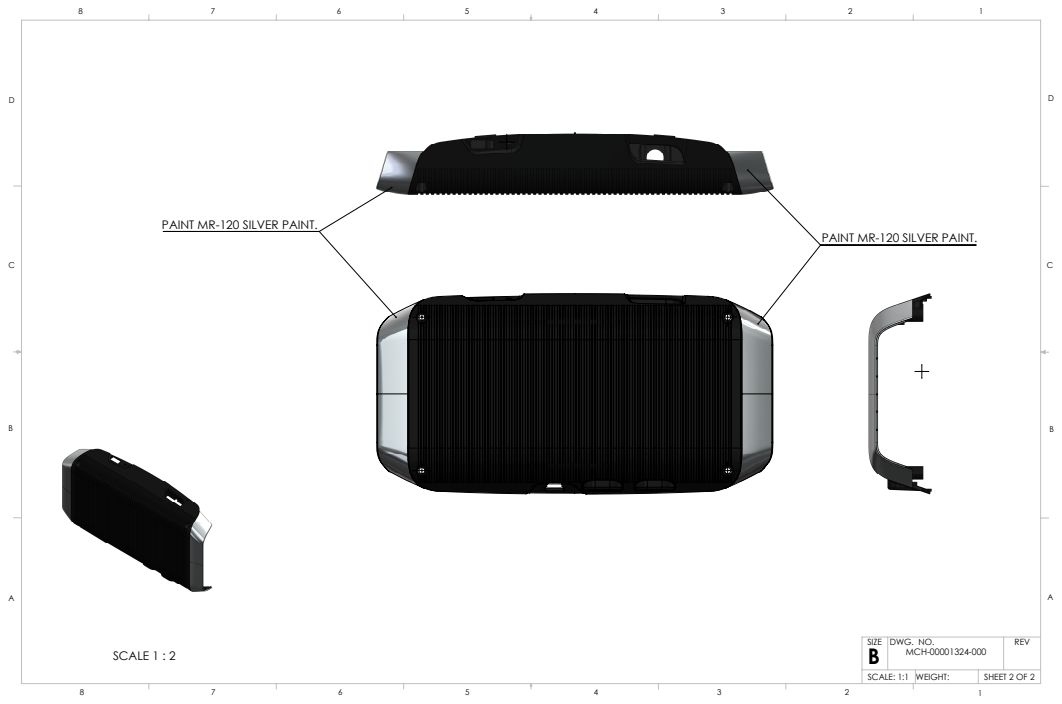
[picture p54: page 2]
SCALE 1 : 2; DWG. NO.; REV; SCALE: 1:1 WEIGHT:; SHEET 2 OF 2

PAINT MR-120 SILVER PAINT.
