openxc/openxc-accessories/docs/mechanical/V2X/MCH-00002535-000.PDF

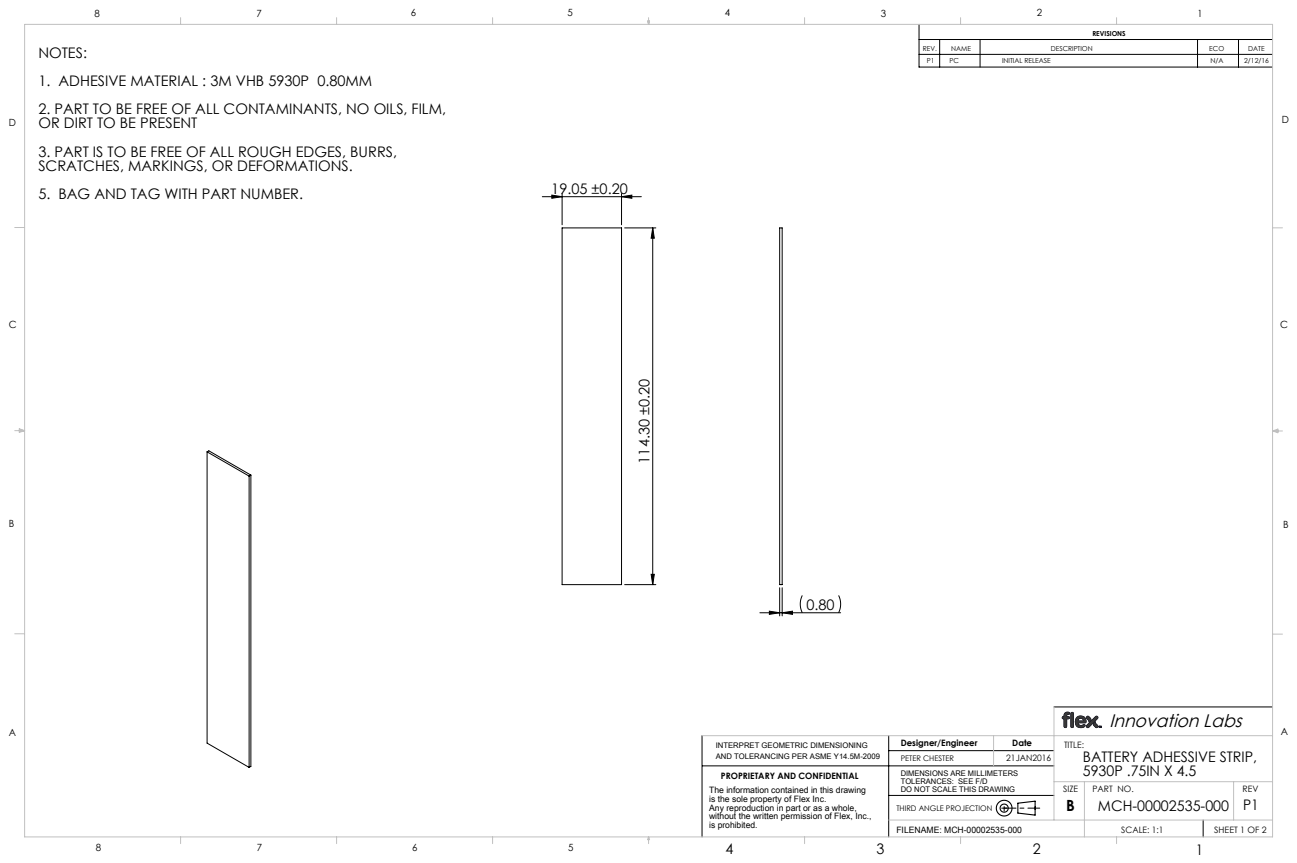
[picture p55: page 1]
INITIAL RELEASE; Innovation Labs; PART NO.; REV; SCALE: 1:1; BATTERY ADHESSIVE STRIP, 5930P .75IN X 4.5; MCH-00002535-000 P1; SHEET 1 OF 2; PETER CHESTER; 21JAN2016

NOTES:
1. ADHESIVE MATERIAL : 3M VHB 5930P 0.80MM
2. PART TO BE FREE OF ALL CONTAMINANTS, NO OILS, FILM,
OR DIRT TO BE PRESENT
3. PART IS TO BE FREE OF ALL ROUGH EDGES, BURRS,
SCRATCHES, MARKINGS, OR DEFORMATIONS.
5. BAG AND TAG WITH PART NUMBER.

INTERPRET GEOMETRIC DIMENSIONING
AND TOLERANCING PER ASME Y14.5M-2009
PROPRIETARY AND CONFIDENTIAL
The information contained in this drawing
is the sole property of Flex Inc.
Any reproduction in part or as a whole,
without the written permission of Flex, Inc.,
is prohibited.

DIMENSIONS ARE MILLIMETERS
TOLERANCES: SEE F/D
DO NOT SCALE THIS DRAWING
THIRD ANGLE PROJECTION
FILENAME: MCH-00002535-000

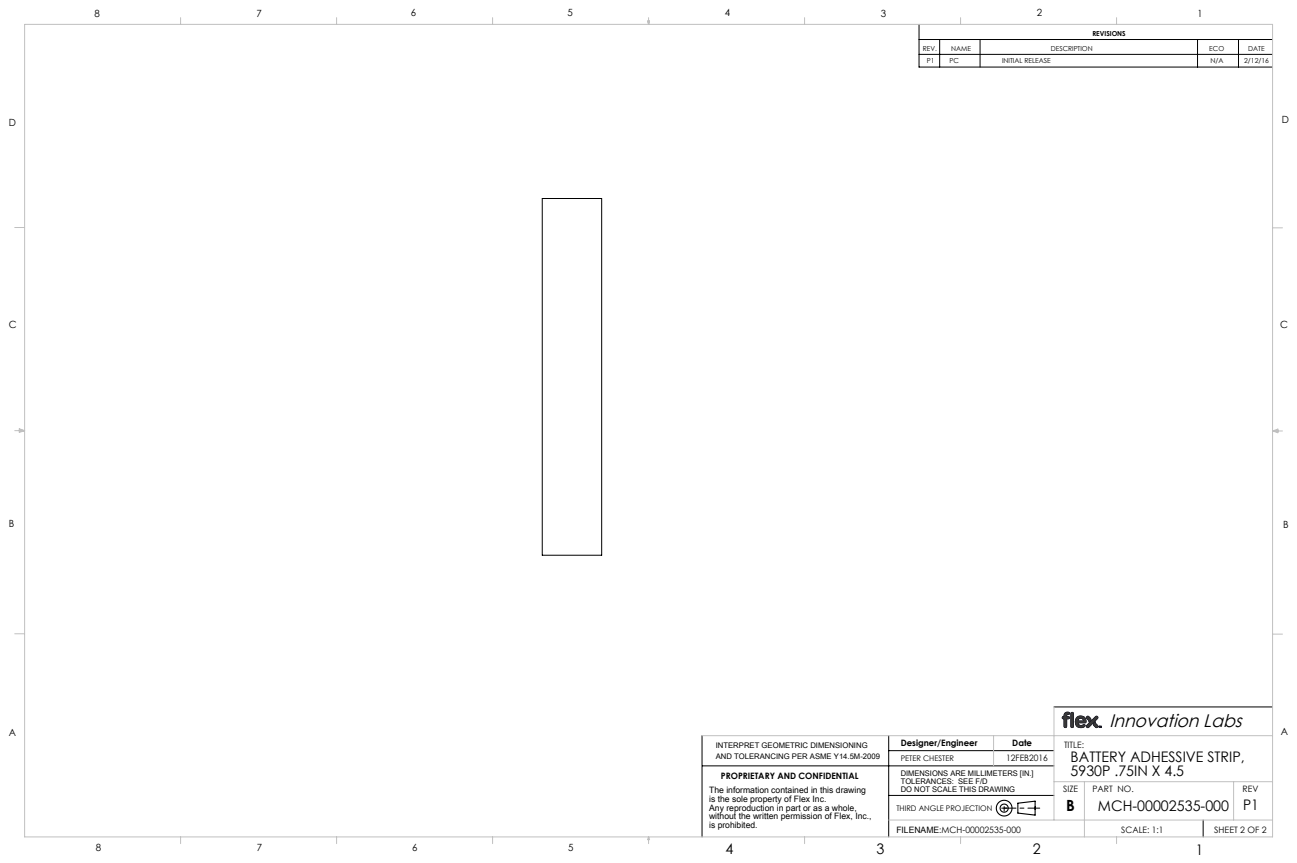
[picture p56: page 2]
INITIAL RELEASE; Innovation Labs; PART NO.; REV; SCALE: 1:1; BATTERY ADHESSIVE STRIP, 5930P .75IN X 4.5; MCH-00002535-000 P1; SHEET 2 OF 2; PETER CHESTER; 12FEB2016

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

DIMENSIONS ARE MILLIMETERS [IN.]
TOLERANCES: SEE F/D
DO NOT SCALE THIS DRAWING
THIRD ANGLE PROJECTION
FILENAME:MCH-00002535-000
