openxc/openxc-accessories/docs/electrical/Modem/DWG-00001143-002-PCB_assembly_bottom.pdf

# ART FILM - ASB

TP20

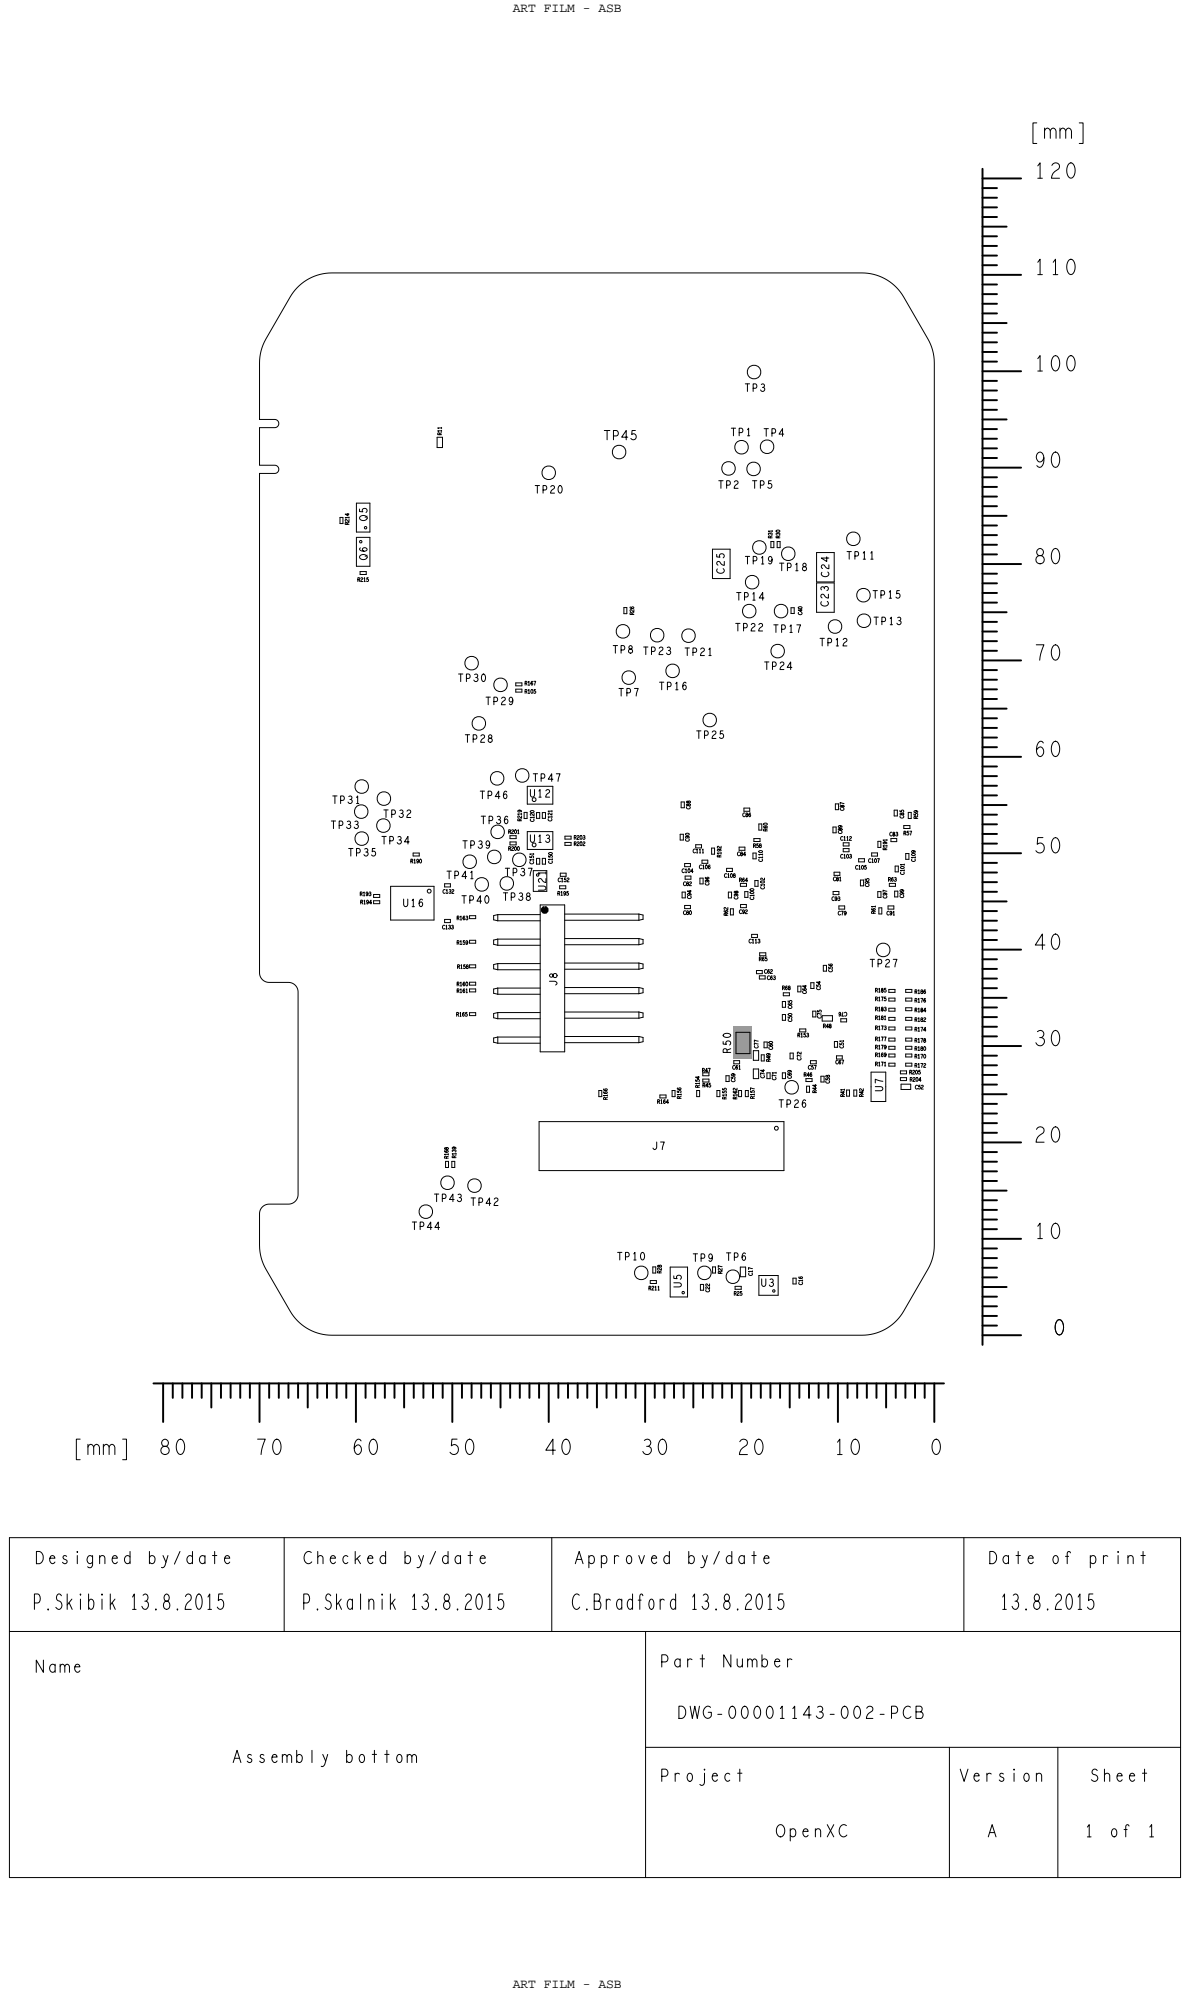
[picture p57: page 1]

Designed by/date | Checked by/date P.Skalnik 13.8.2015 | Approved by/date C.Bradford 13.8.2015 | Date of print 13.8.2015

Name Assembly bottom | Part Number DWG-00001143-002-PCB

Project OpenXC | Version A | Sheet
