openxc/openxc-accessories/docs/electrical/Modem/DWG-00001143-002-PCB_assembly_top.pdf

# ART FILM - AST

# R9 R7 D6

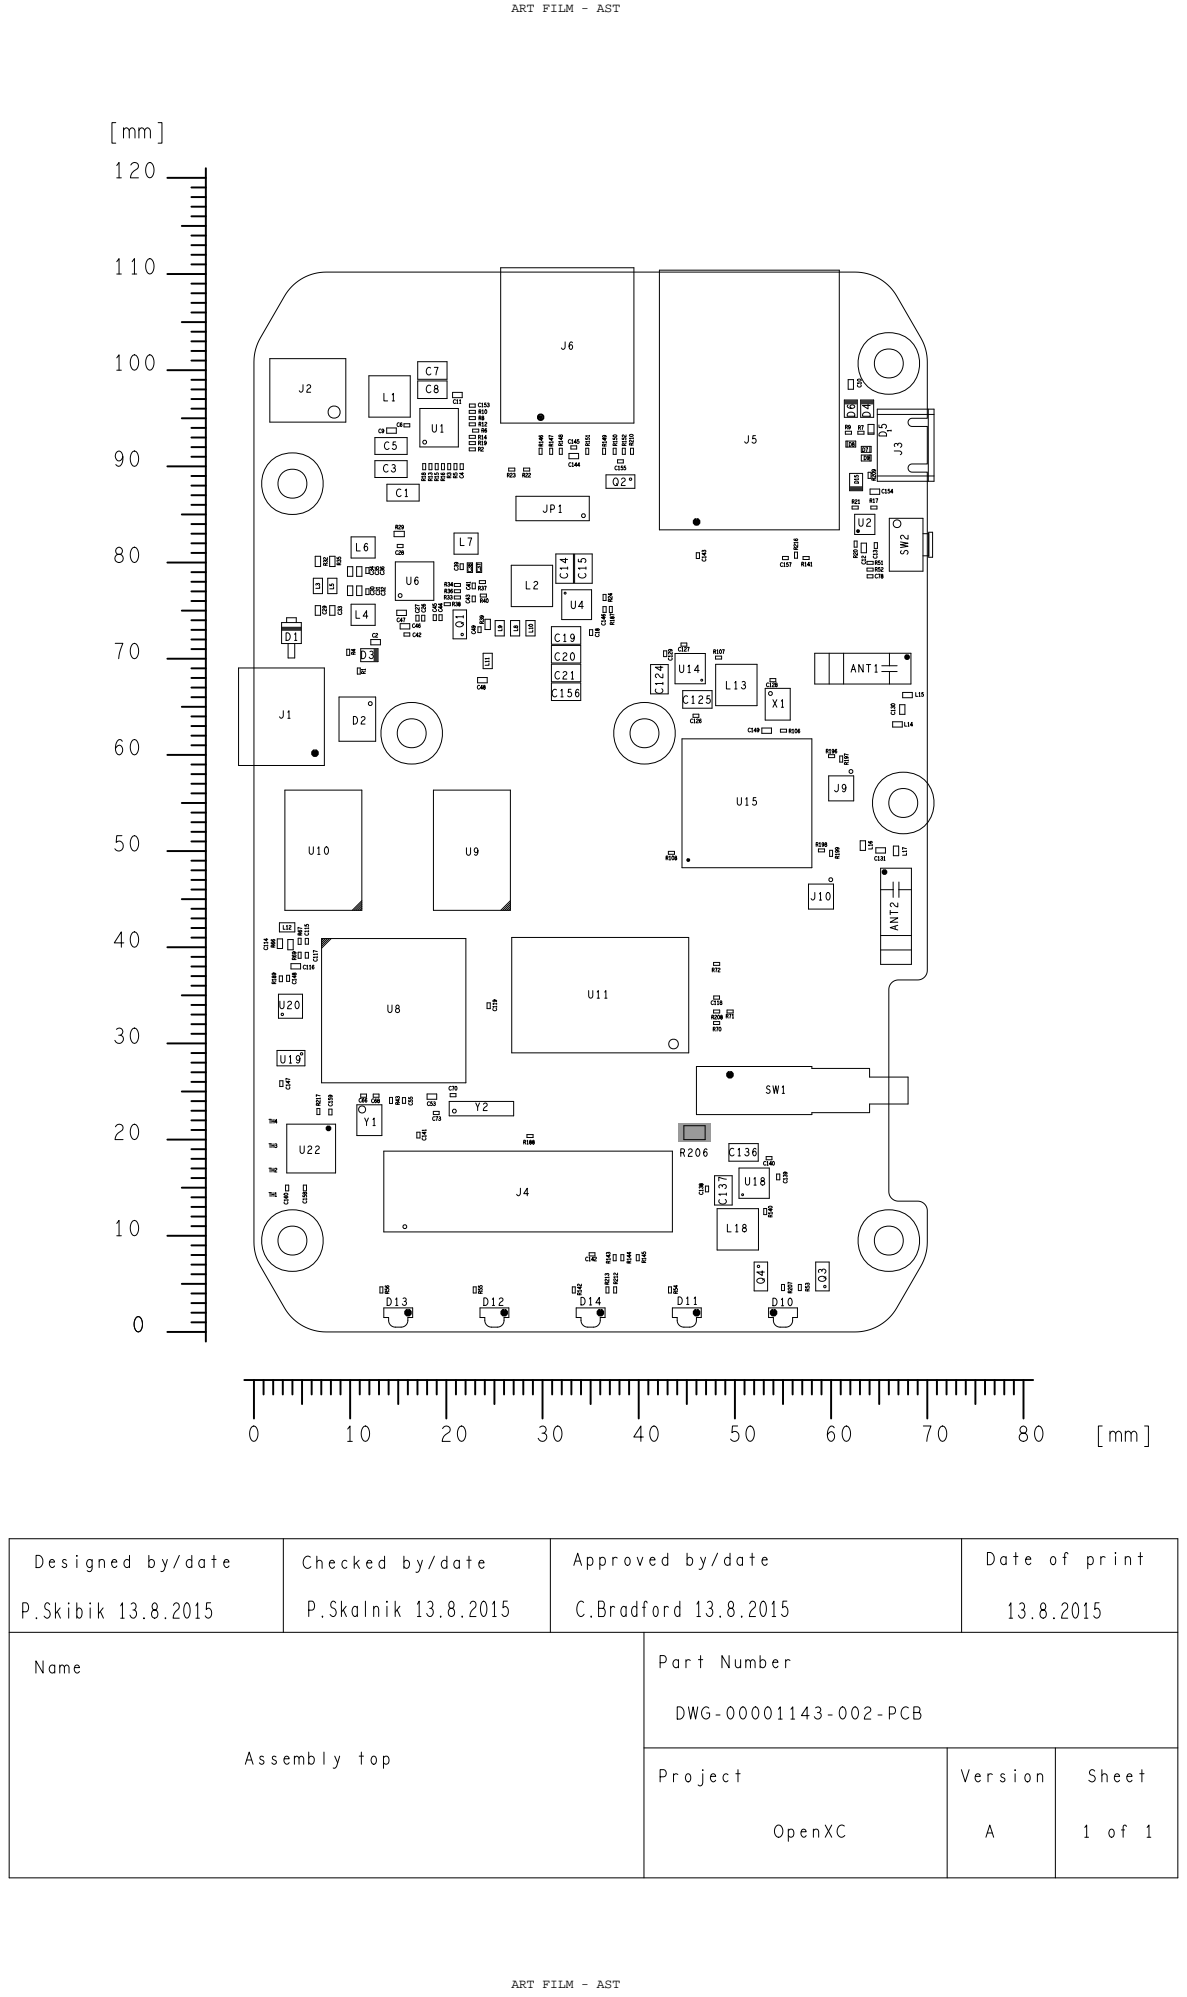
[picture p58: page 1]
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

Name Assembly top | Part Number DWG-00001143-002-PCB

Project OpenXC | Version A | Sheet
