openxc/openxc-accessories/docs/electrical/Modem/SCHEMATIC-01-Title Revision.pdf

# Schematic: OpenXC Modem

SHEET | SHEET NAME

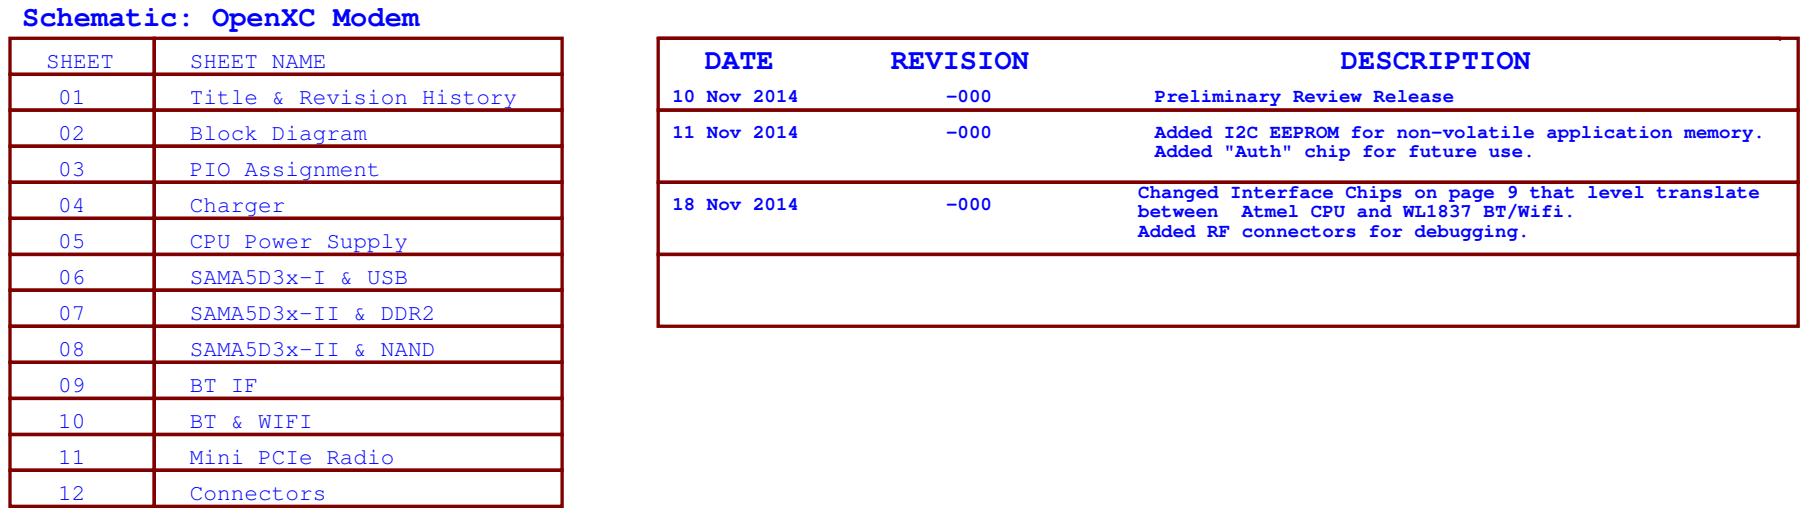
[picture p59: page 1]
Block Diagram; SAMA5D3x-I & USB; SAMA5D3x-II & NAND; Connectors; SAMA5D3x-II & DDR2; PIO Assignment; DATE; REVISION; DESCRIPTION; 10 Nov 2014; Preliminary Review Release; BT & WIFI; 11 Nov 2014; Added I2C EEPROM for non-volatile application memory.; 18 Nov 2014; Changed Interface Chips on page 9 that level translate between; Atmel CPU and WL1837 BT/Wifi.; Title; Size; Document Number; Rev; Date:; Sheet; DWG-00001143-002-SCH; Custom; Monday, June 08, 2015

Title & Revision History

Added "Auth" chip for future use.

Charger
CPU Power Supply

Added RF connectors for debugging.

Mini PCIe Radio

OpenXC Modem, Main
