openxc/openxc-accessories/docs/electrical/Modem/SCHEMATIC-03-PIO Assignment.pdf

# PIO MUXING

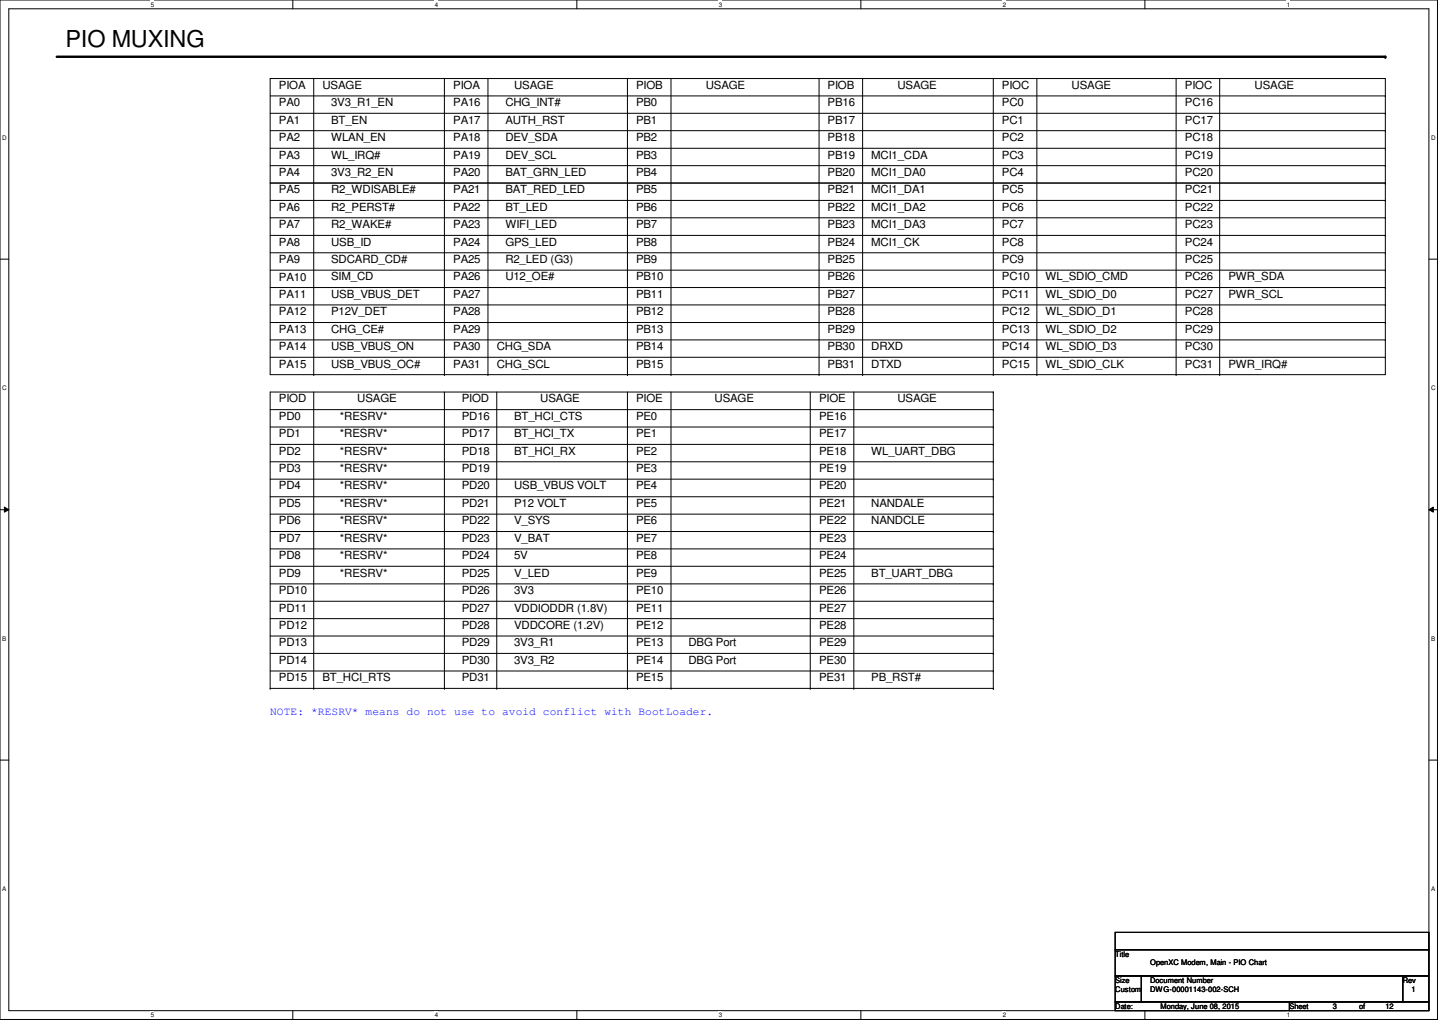
[picture p60: page 1]
MCI1_CDA; MCI1_DA0; MCI1_DA1; MCI1_DA2; MCI1_DA3; MCI1_CK; DRXD; DTXD; WL_SDIO_D2; WL_SDIO_D3; WL_SDIO_CLK; WL_SDIO_CMD; WL_SDIO_D0; WL_SDIO_D1; PWR_SCL; PWR_IRQ#; SDCARD_CD#; USB_VBUS_OC#; CHG_INT#; WL_IRQ#; USB_VBUS_DET; NANDCLE; P12V_DET; CHG_SCL; CHG_SDA; PIOA; PIOB; PIOC; USAGE; PWR_SDA; V_SYS; USB_ID; USB_VBUS_ON; CHG_CE#; WLAN_EN; DEV_SDA; DEV_SCL; BAT_GRN_LED; BAT_RED_LED; BT_LED; GPS_LED; WIFI_LED; *RESRV*; R2_WDISABLE#; R2_PERST#; R2_WAKE#; SIM_CD; AUTH_RST; R2_LED (G3); Title; Size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

PIOD | USAGE | PIOD | USAGE | PIOE | USAGE | PIOE | USAGE
PD0 | *RESRV* | PD16 | BT_HCI_CTS | PE0 | | PE16
PD1 | *RESRV* | PD17 | BT_HCI_TX | PE1 | | PE17
PD2 | *RESRV* | PD18 | BT_HCI_RX | PE2 | | PE18 | WL_UART_DBG
PD3 | *RESRV* | PD19 | | PE3 | | PE19
PD4 | *RESRV* | PD20 | USB_VBUS VOLT | PE4 | | PE20
PD5 | *RESRV* | PD21 | P12 VOLT | PE5 | | PE21 | NANDALE

PD7 | *RESRV* | PD23 | V_BAT | PE7 | | PE23
PD8 | *RESRV* | PD24 | 5V | PE8 | | PE24
PD9 | *RESRV* | PD25 | V_LED | PE9 | | PE25 | BT_UART_DBG
PD10 | | PD26 | 3V3 | PE10 | | PE26
PD11 | | PD27 | VDDIODDR (1.8V) | PE11 | | PE27
PD12 | | PD28 | VDDCORE (1.2V) | PE12 | | PE28
PD13 | | PD29 | 3V3_R1 | PE13 | DBG Port | PE29
PD14 | | PD30 | 3V3_R2 | PE14 | DBG Port | PE30
PD15 | BT_HCI_RTS | PD31 | | PE15 | | PE31 | PB_RST#

NOTE: *RESRV* means do not use to avoid conflict with BootLoader.

OpenXC Modem, Main - PIO Chart
