openxc/openxc-accessories/docs/electrical/Modem/SCHEMATIC-04-Charger.pdf

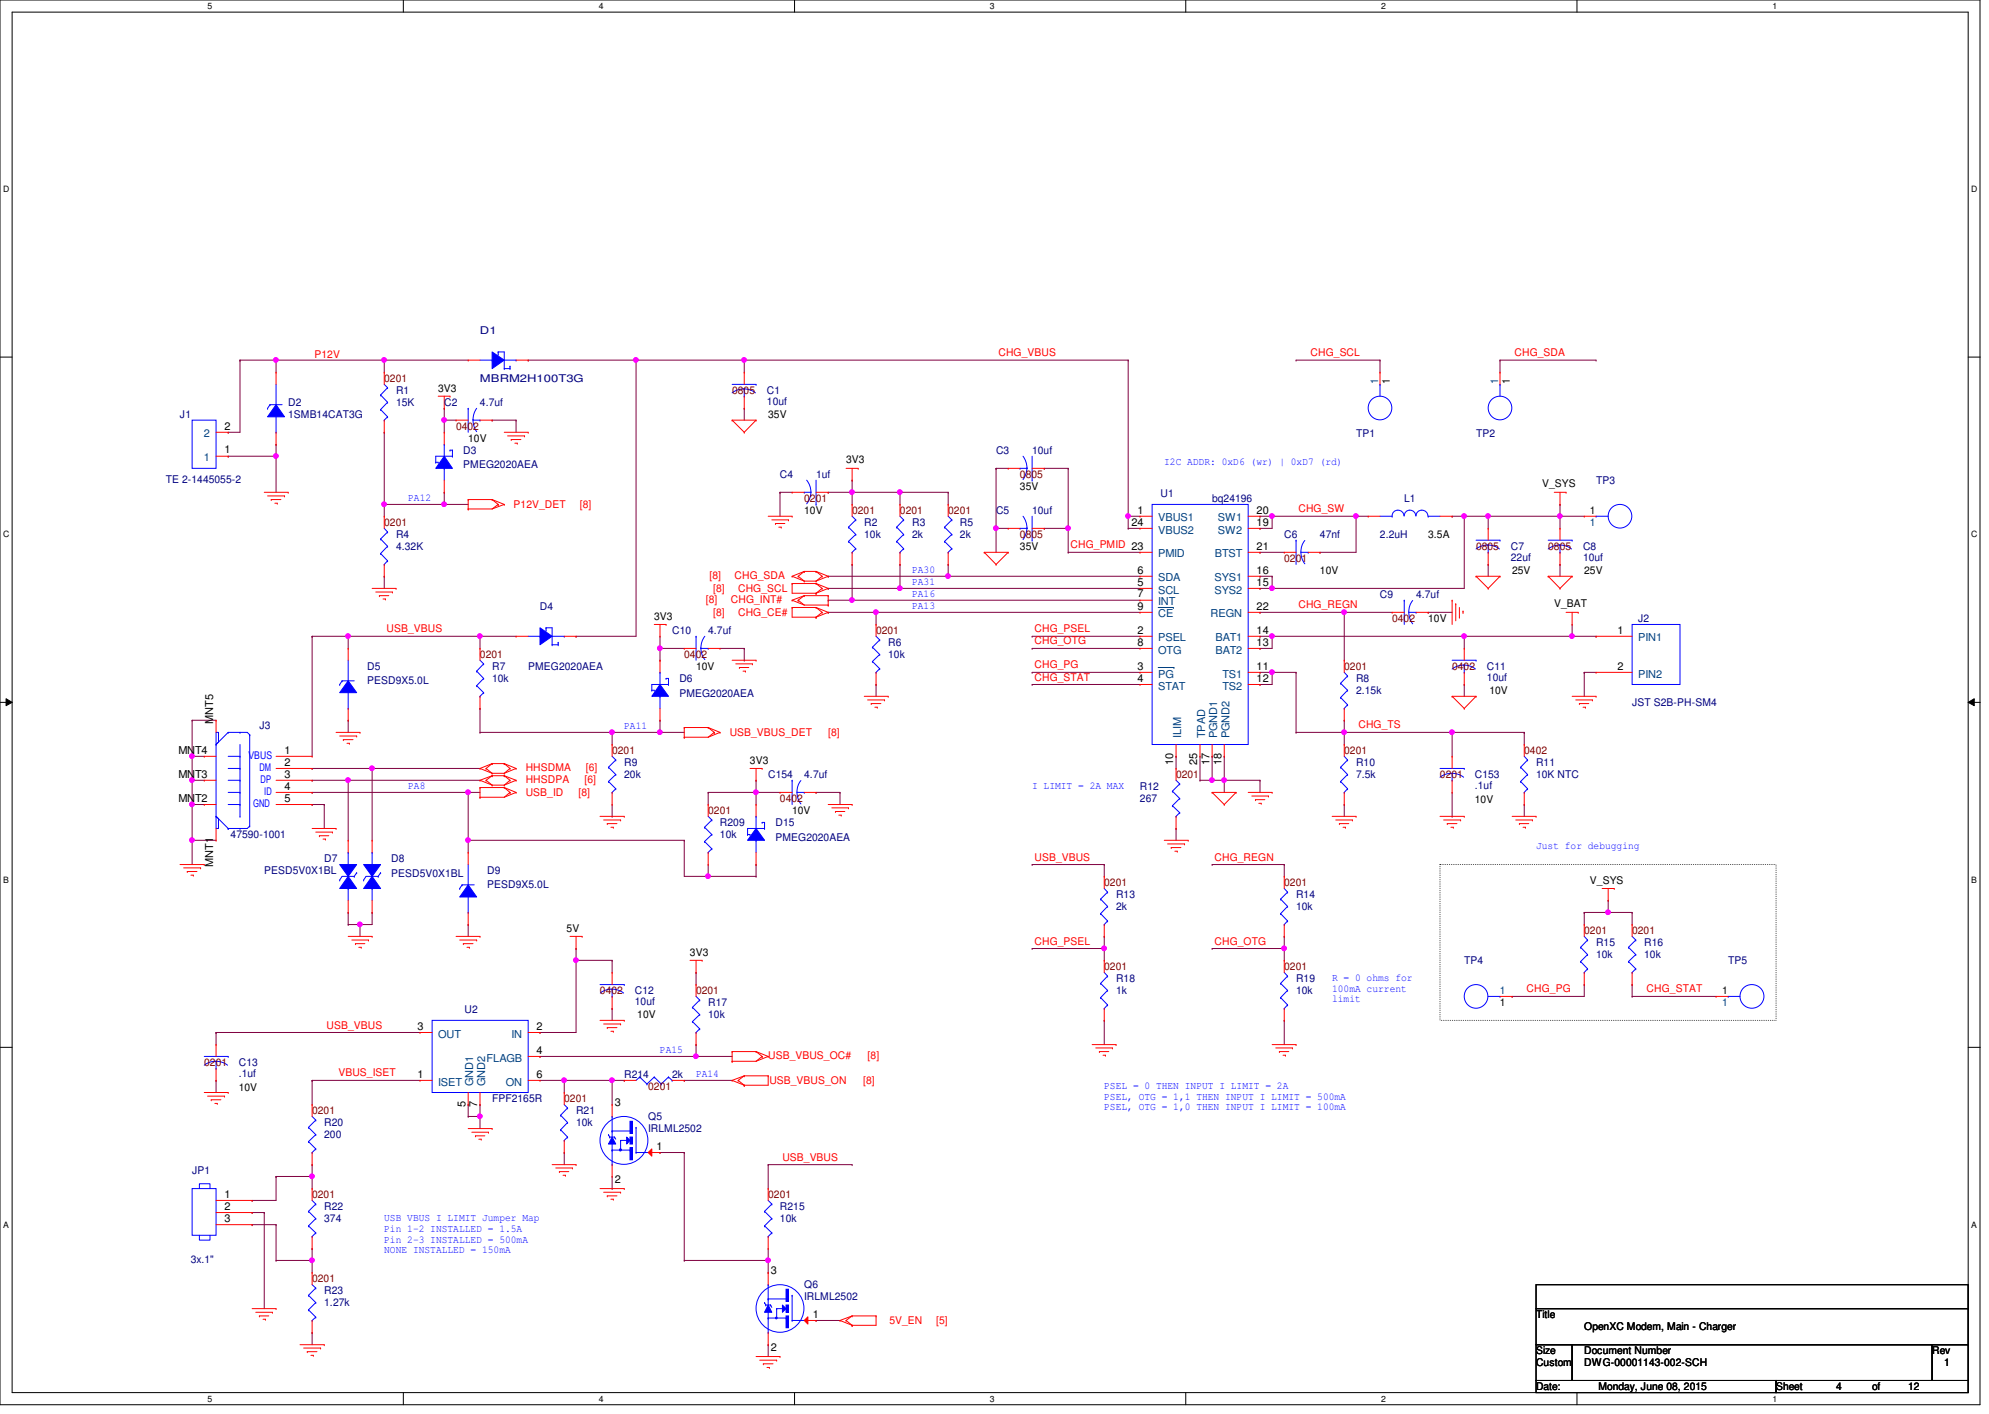
[picture p61: page 1]

PSEL = 0 THEN INPUT I LIMIT = 2A
PSEL, OTG = 1,1 THEN INPUT I LIMIT = 500mA
PSEL, OTG = 1,0 THEN INPUT I LIMIT = 100mA

USB VBUS I LIMIT Jumper Map
Pin 1-2 INSTALLED = 1.5A
Pin 2-3 INSTALLED = 500mA
NONE INSTALLED = 150mA

OpenXC Modem, Main - Charger
