openxc/openxc-accessories/docs/electrical/Modem/SCHEMATIC-05-CPU Power Supp.pdf

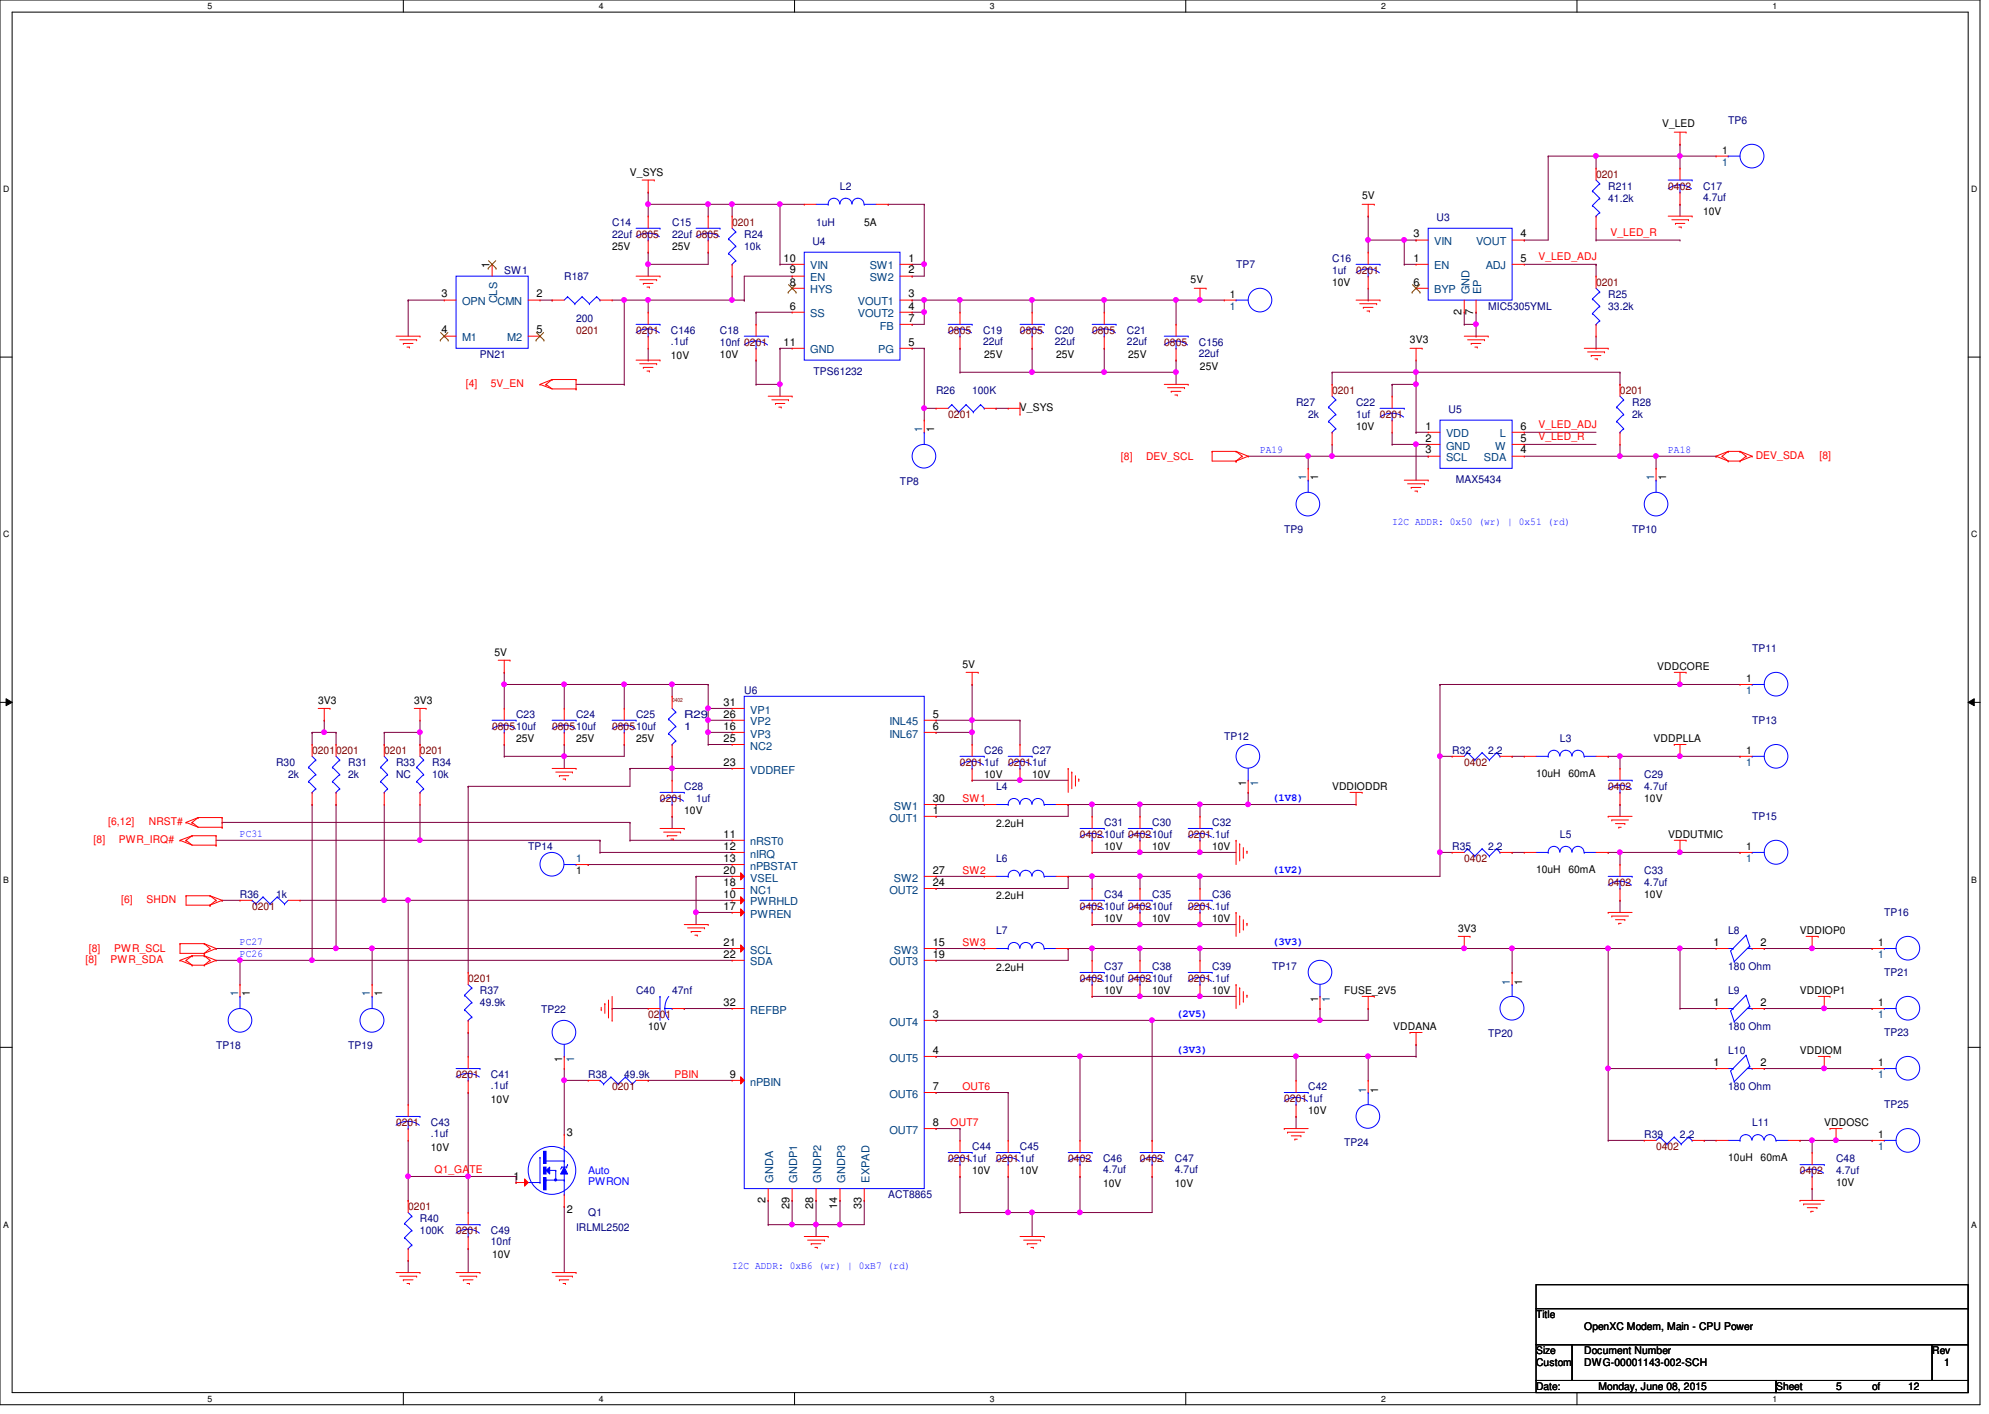
[picture p62: page 1]

OpenXC Modem, Main - CPU Power
