openxc/openxc-accessories/docs/electrical/Modem/SCHEMATIC-06-SAMA5D3x USB.pdf

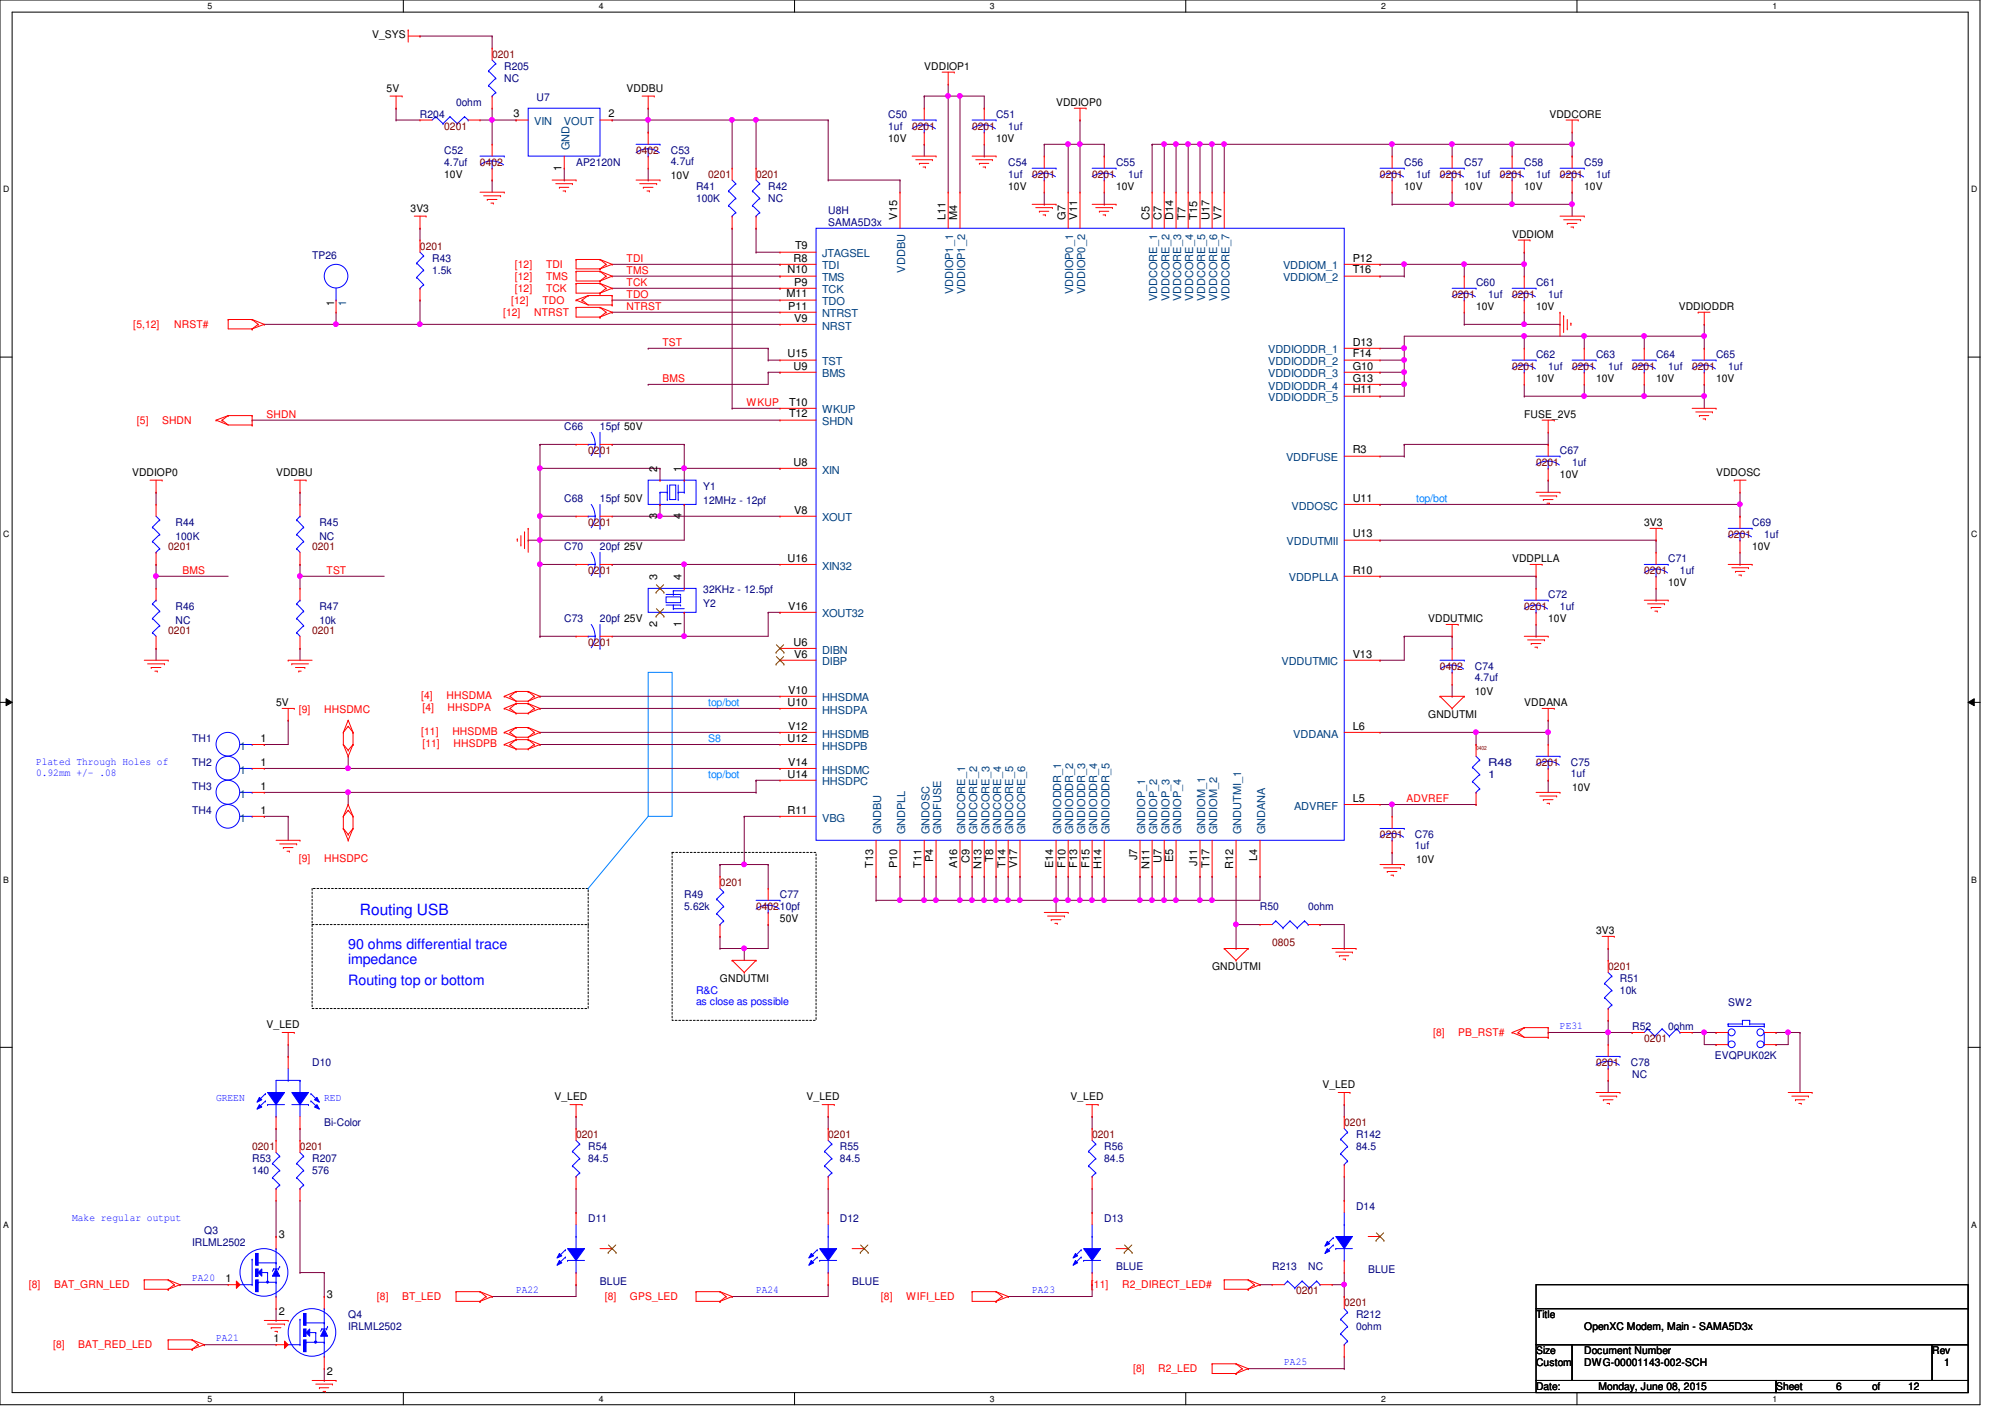
[picture p63: page 1]

VDDIOP1

Plated Through Holes of

90 ohms differential trace
impedance
Routing top or bottom
