openxc/openxc-accessories/docs/electrical/Modem/SCHEMATIC-07-SAMA5D3x DDR2.pdf

## DDR2 SDRAM

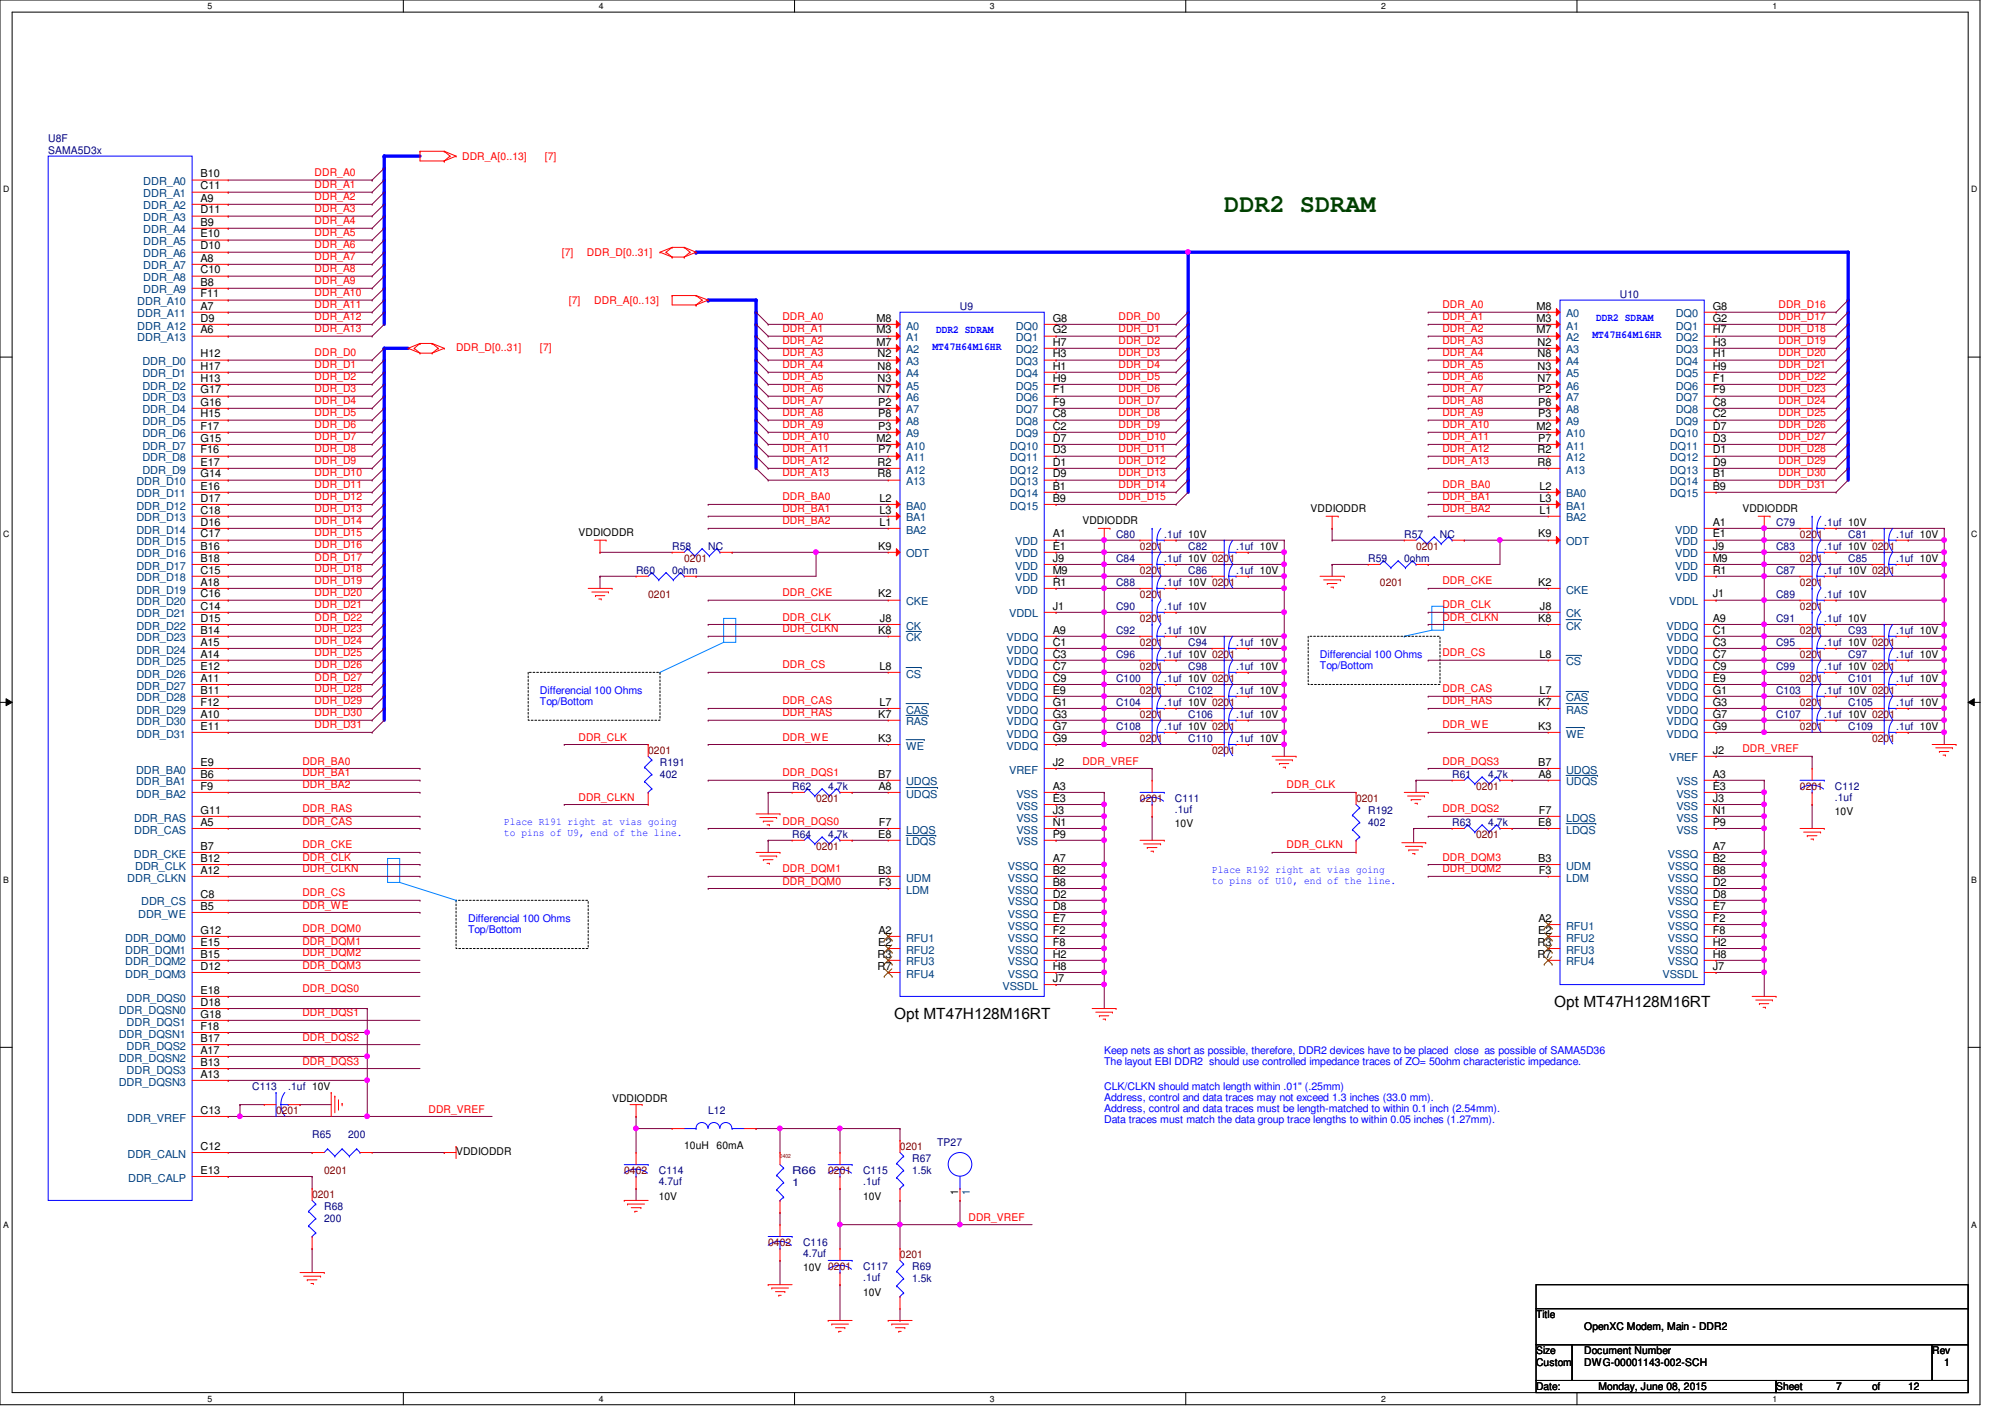
[picture p64: page 1]

Place R191 right at vias going
to pins of U9, end of the line.

Place R192 right at vias going
to pins of U10, end of the line.

Keep nets as short as possible, therefore, DDR2 devices have to be placed close as possible of SAMA5D36
The layout EBI DDR2 should use controlled impedance traces of ZO= 50ohm characteristic impedance.

CLK/CLKN should match length within .01" (.25mm)
Address, control and data traces may not exceed 1.3 inches (33.0 mm).
Address, control and data traces must be length-matched to within 0.1 inch (2.54mm).
Data traces must match the data group trace lengths to within 0.05 inches (1.27mm).
