openxc/openxc-accessories/docs/electrical/Modem/SCHEMATIC-10-BT WIFI.pdf

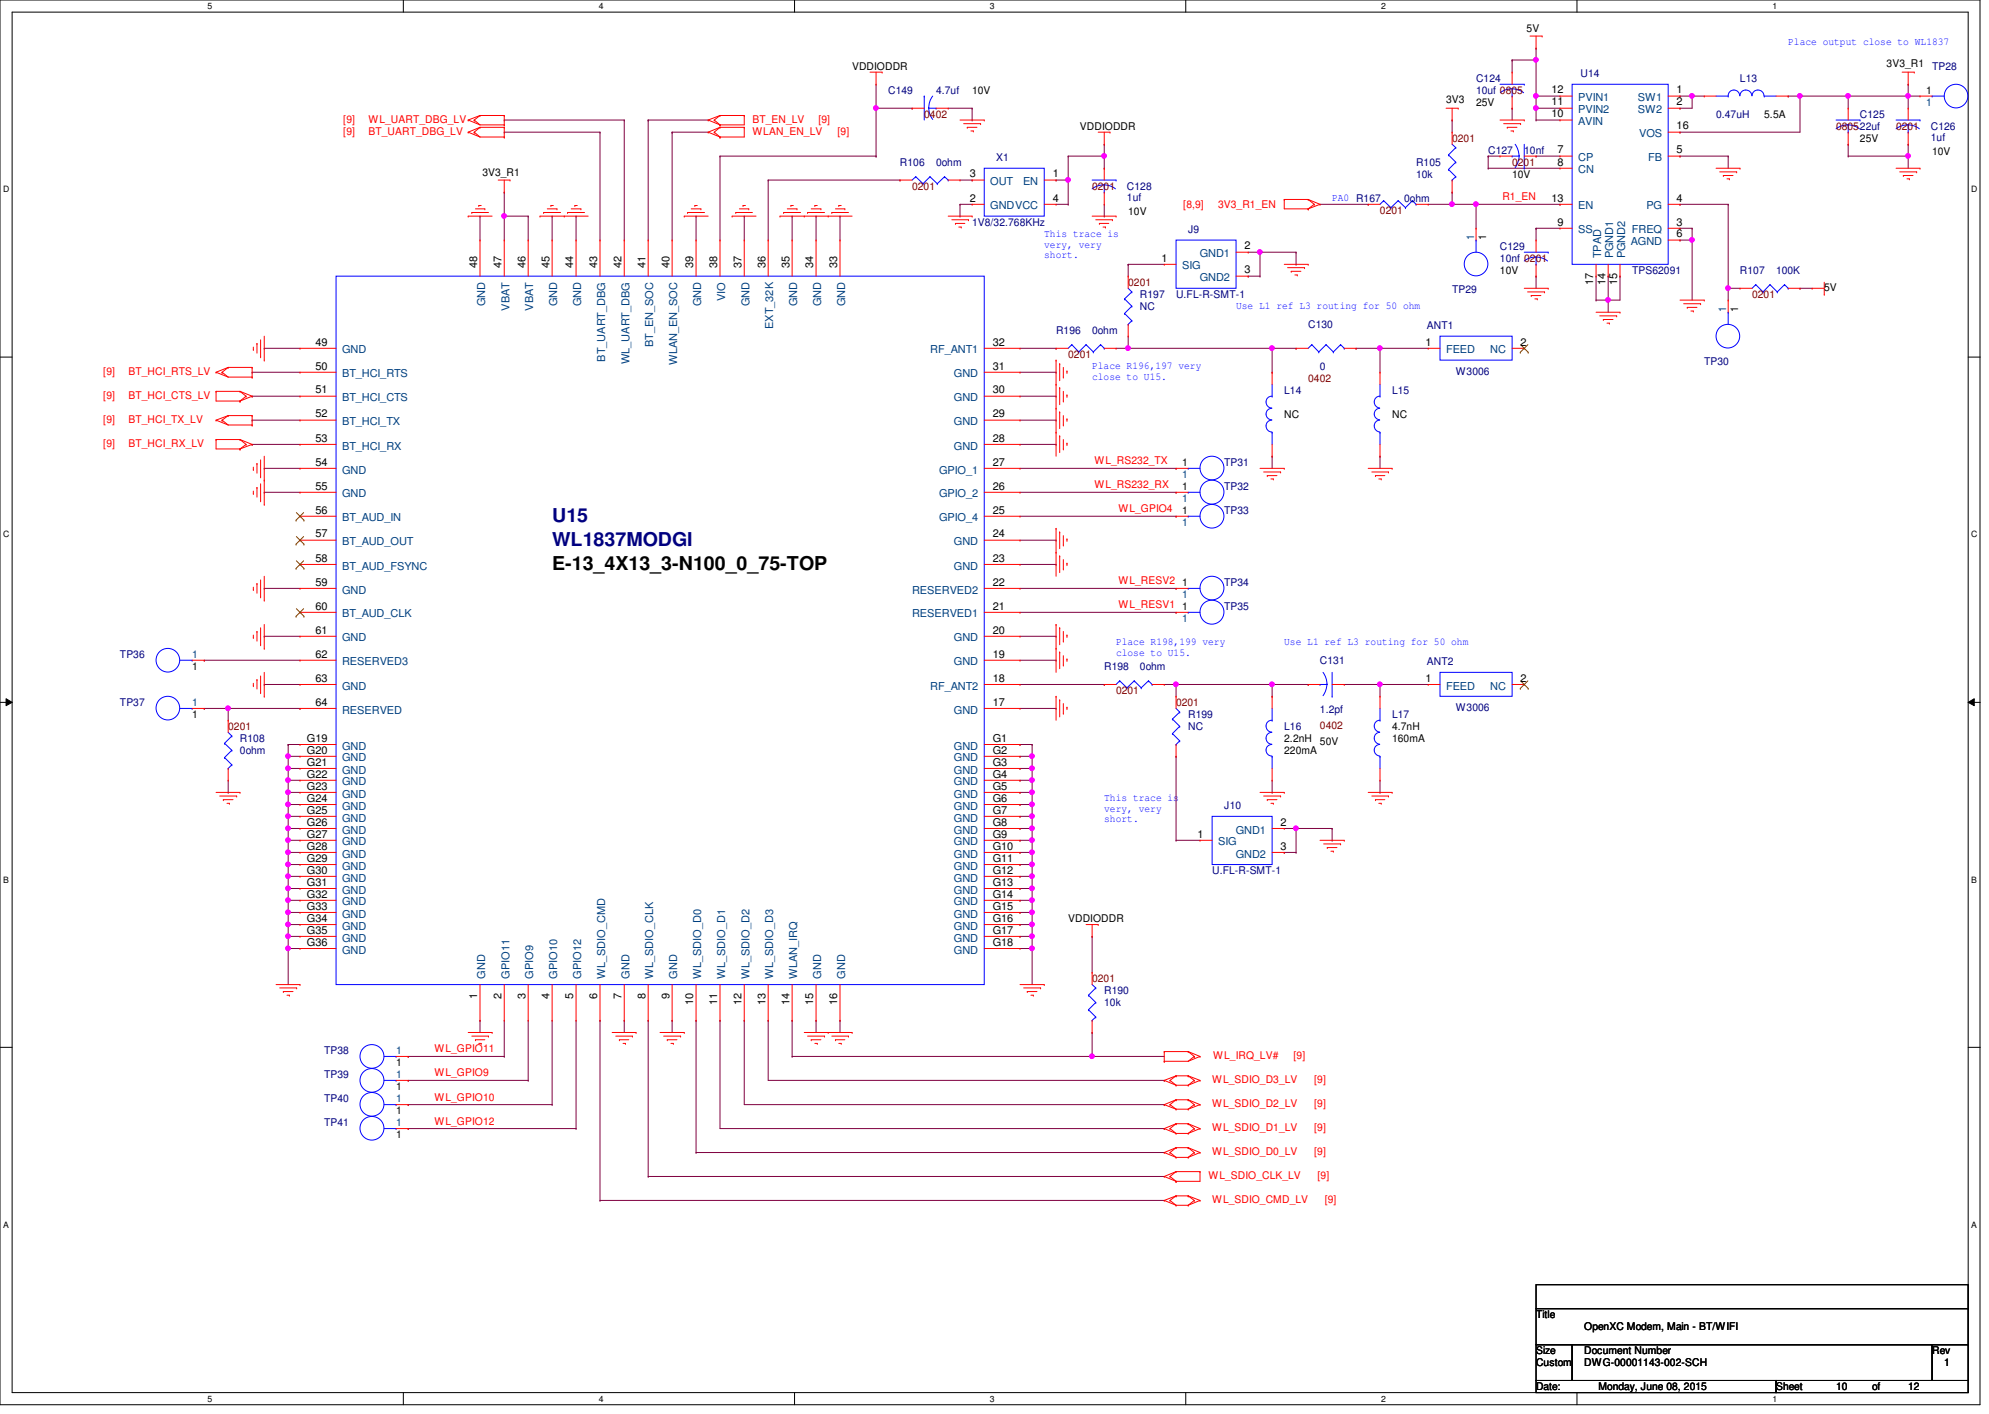
[picture p65: page 1]

Place output close to WL1837

Use L1 ref L3 routing for 50 ohm

OpenXC Modem, Main - BT/WIFI
