openxc/openxc-accessories/docs/electrical/Modem/SCHEMATIC-12-Connectors.pdf

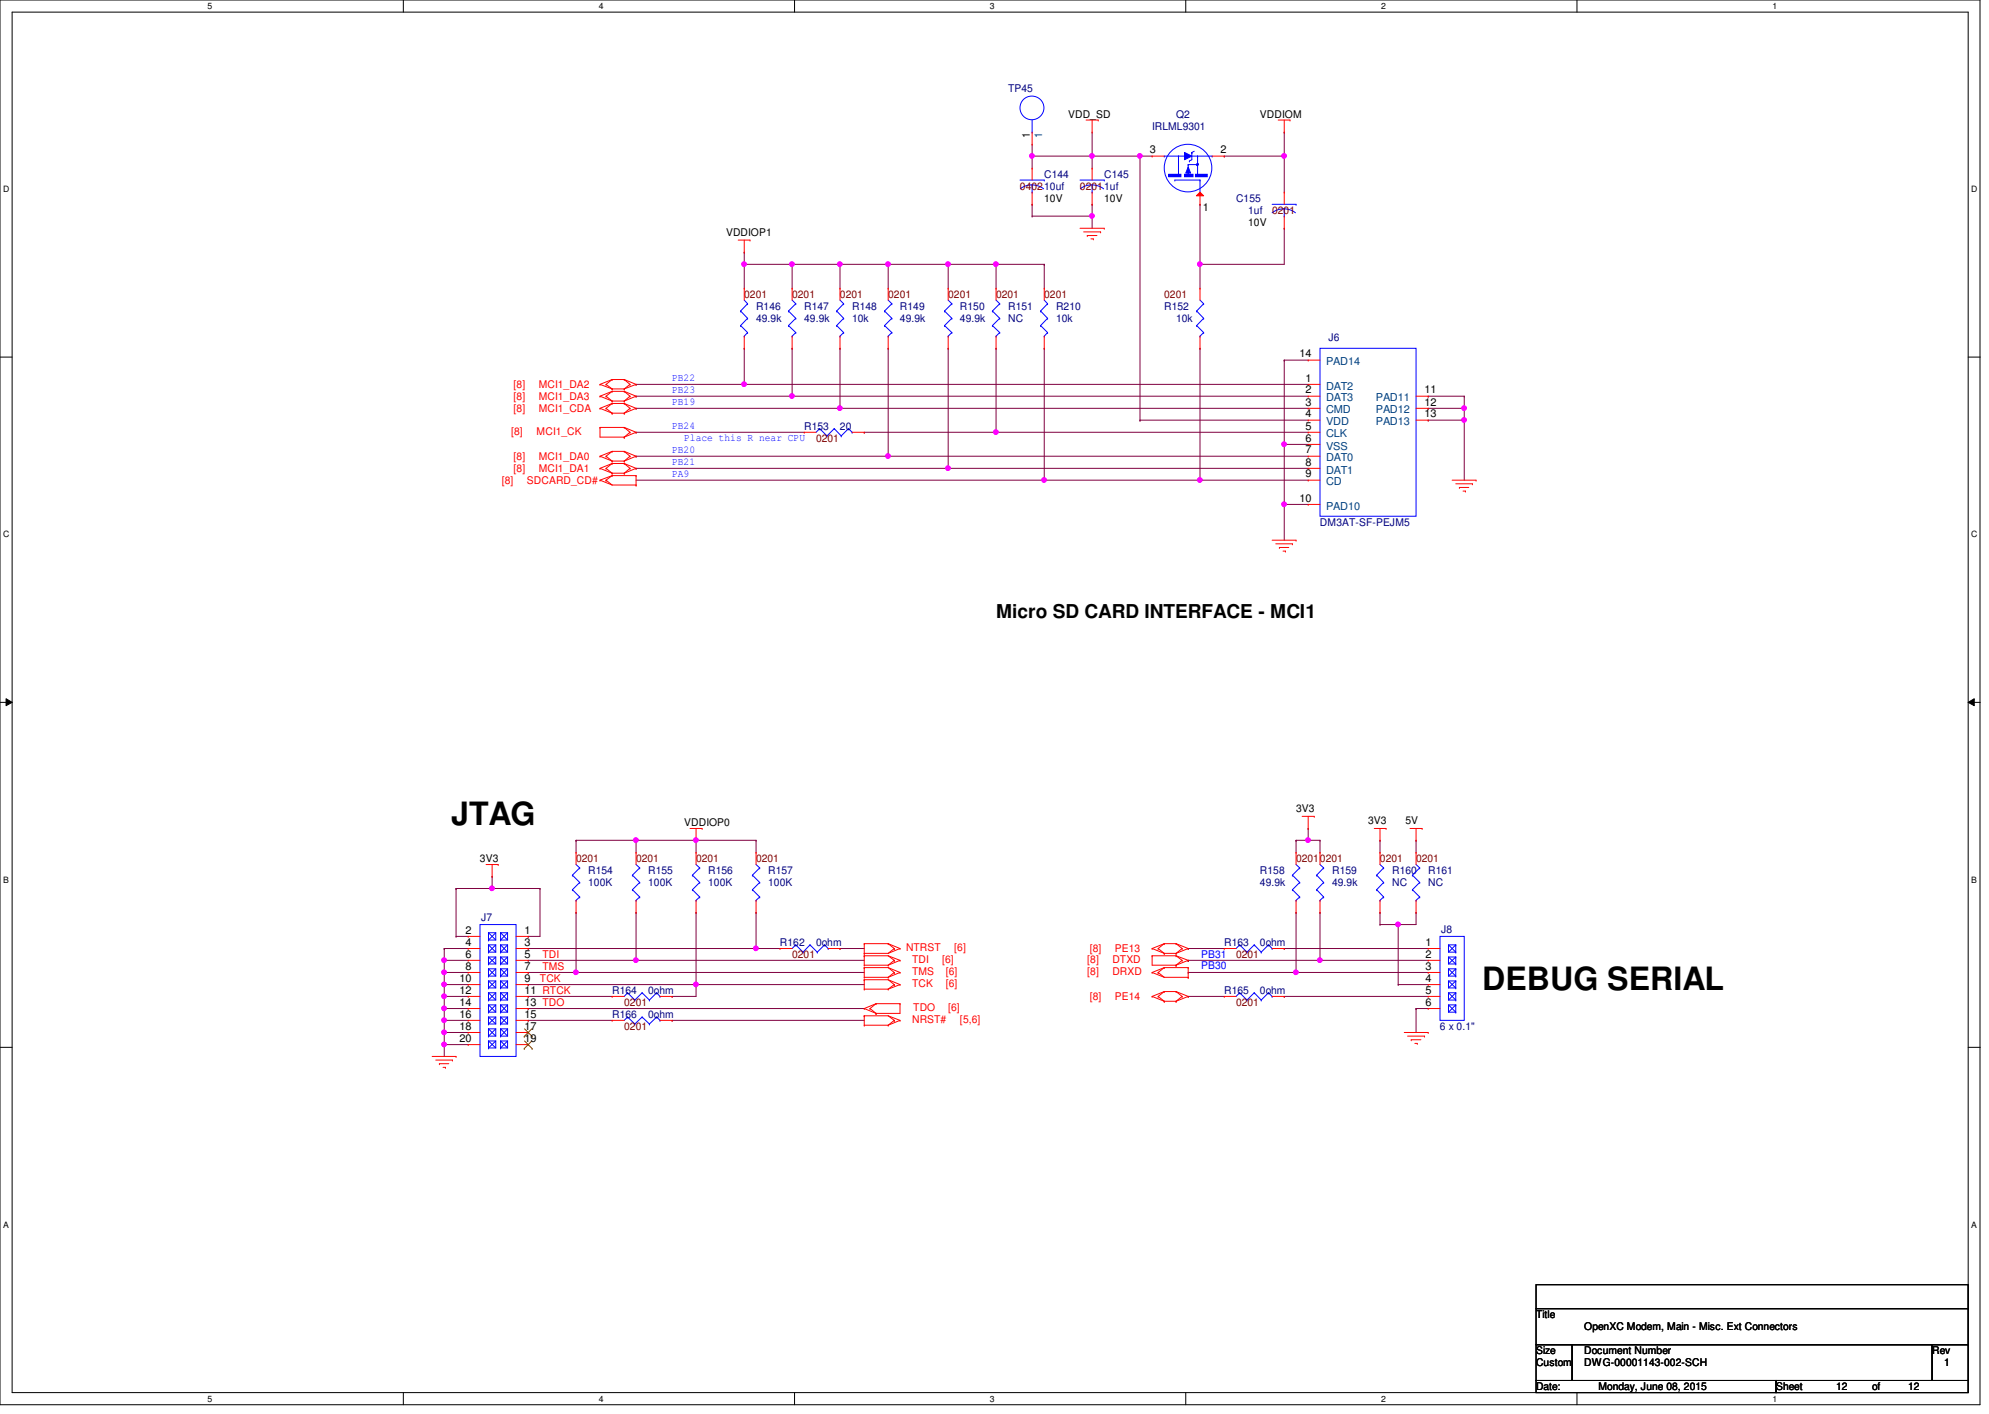
[picture p66: page 1]

Place this R near CPU

Micro SD CARD INTERFACE - MCI1

OpenXC Modem, Main - Misc. Ext Connectors
