openxc/openxc-accessories/docs/mechanical/Modem/MCH-00001323-000.PDF

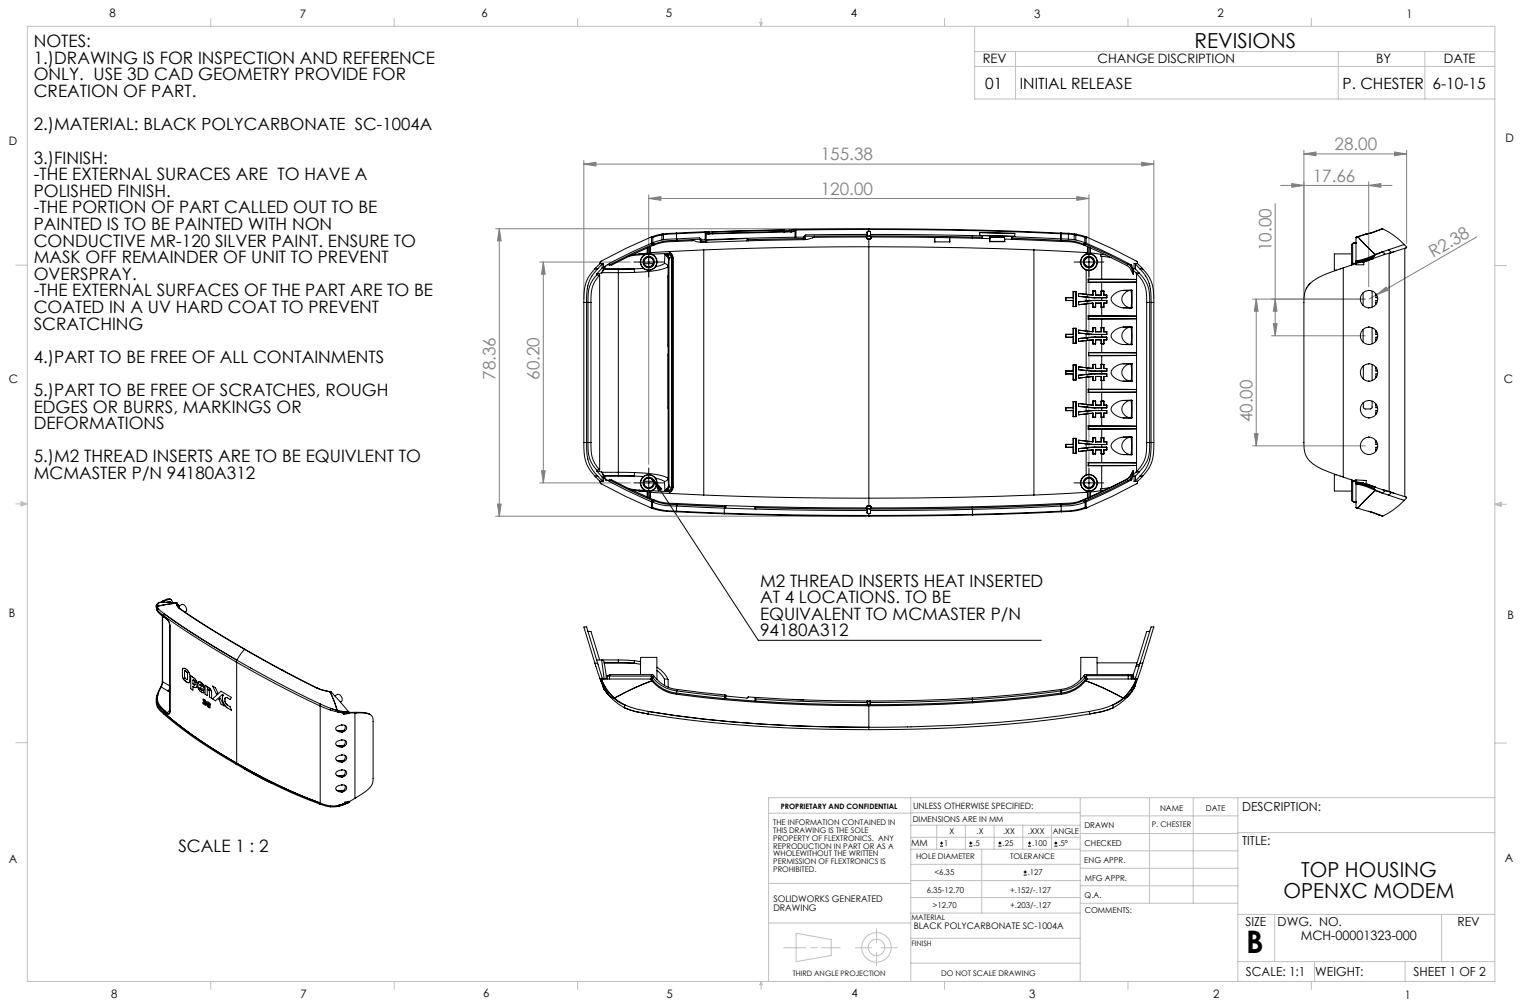
[picture p67: page 1]
SCALE 1 : 2; BLACK POLYCARBONATE SC-1004A; ENG APPR.; MFG APPR.; DWG. NO.; REV; SCALE: 1:1 WEIGHT:; UNLESS OTHERWISE SPECIFIED:; P. CHESTER; TOP HOUSING OPENXC MODEM; SHEET 1 OF 2; CHANGE DISCRIPTION; DATE; 01 INITIAL RELEASE; P. CHESTER 6-10-15; DIMENSIONS ARE IN MM; .XX .XXX ANGLE; HOLE DIAMETER; TOLERANCE; SOLIDWORKS GENERATED

NOTES:
1.)DRAWING IS FOR INSPECTION AND REFERENCE
ONLY. USE 3D CAD GEOMETRY PROVIDE FOR
CREATION OF PART.
2.)MATERIAL: BLACK POLYCARBONATE SC-1004A
3.)FINISH:
-THE EXTERNAL SURACES ARE TO HAVE A
POLISHED FINISH.
-THE PORTION OF PART CALLED OUT TO BE
PAINTED IS TO BE PAINTED WITH NON
CONDUCTIVE MR-120 SILVER PAINT. ENSURE TO
MASK OFF REMAINDER OF UNIT TO PREVENT
OVERSPRAY.
-THE EXTERNAL SURFACES OF THE PART ARE TO BE
COATED IN A UV HARD COAT TO PREVENT
SCRATCHING
4.)PART TO BE FREE OF ALL CONTAINMENTS
5.)PART TO BE FREE OF SCRATCHES, ROUGH
EDGES OR BURRS, MARKINGS OR
DEFORMATIONS
5.)M2 THREAD INSERTS ARE TO BE EQUIVLENT TO
MCMASTER P/N 94180A312

M2 THREAD INSERTS HEAT INSERTED
AT 4 LOCATIONS. TO BE
EQUIVALENT TO MCMASTER P/N

PROPRIETARY AND CONFIDENTIAL
THE INFORMATION CONTAINED IN
THIS DRAWING IS THE SOLE
PROPERTY OF FLEXTRONICS. ANY
REPRODUCTION IN PART OR AS A
WHOLEWITHOUT THE WRITTEN
PERMISSION OF FLEXTRONICS IS
PROHIBITED.

THIRD ANGLE PROJECTION

DO NOT SCALE DRAWING

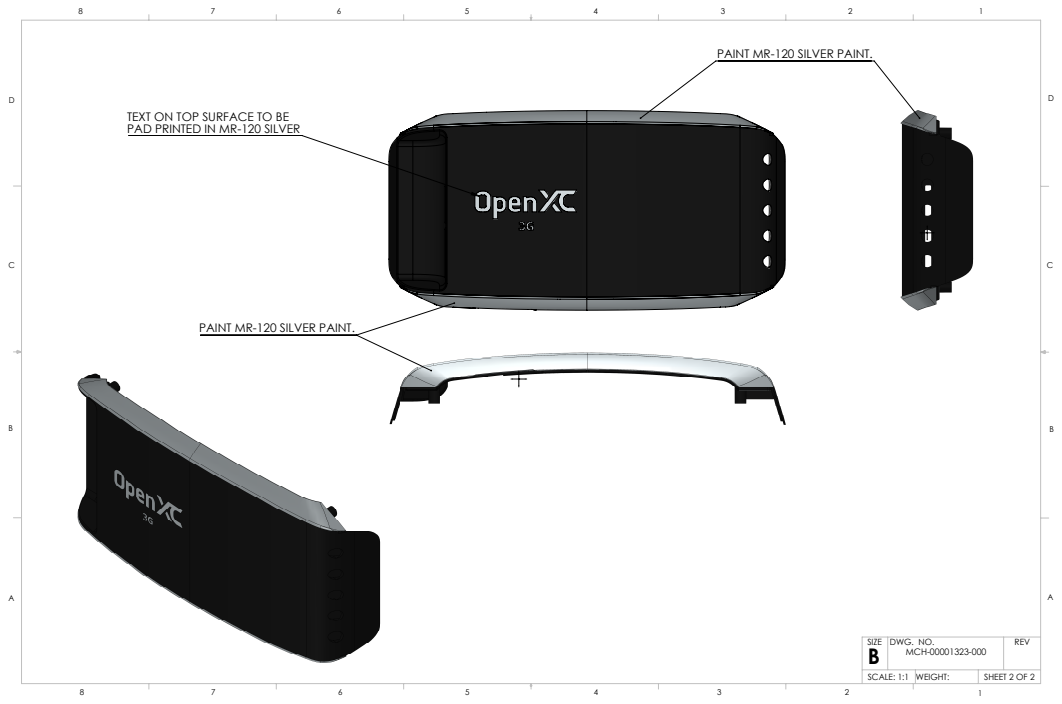
[picture p68: page 2]
DWG. NO.; REV; SCALE: 1:1 WEIGHT:; SHEET 2 OF 2

PAINT MR-120 SILVER PAINT.

TEXT ON TOP SURFACE TO BE
PAD PRINTED IN MR-120 SILVER
