openxc/openxc-accessories/docs/electrical/Modem/PCB-00001143-002_FAB_DRAWING.pdf

A

8

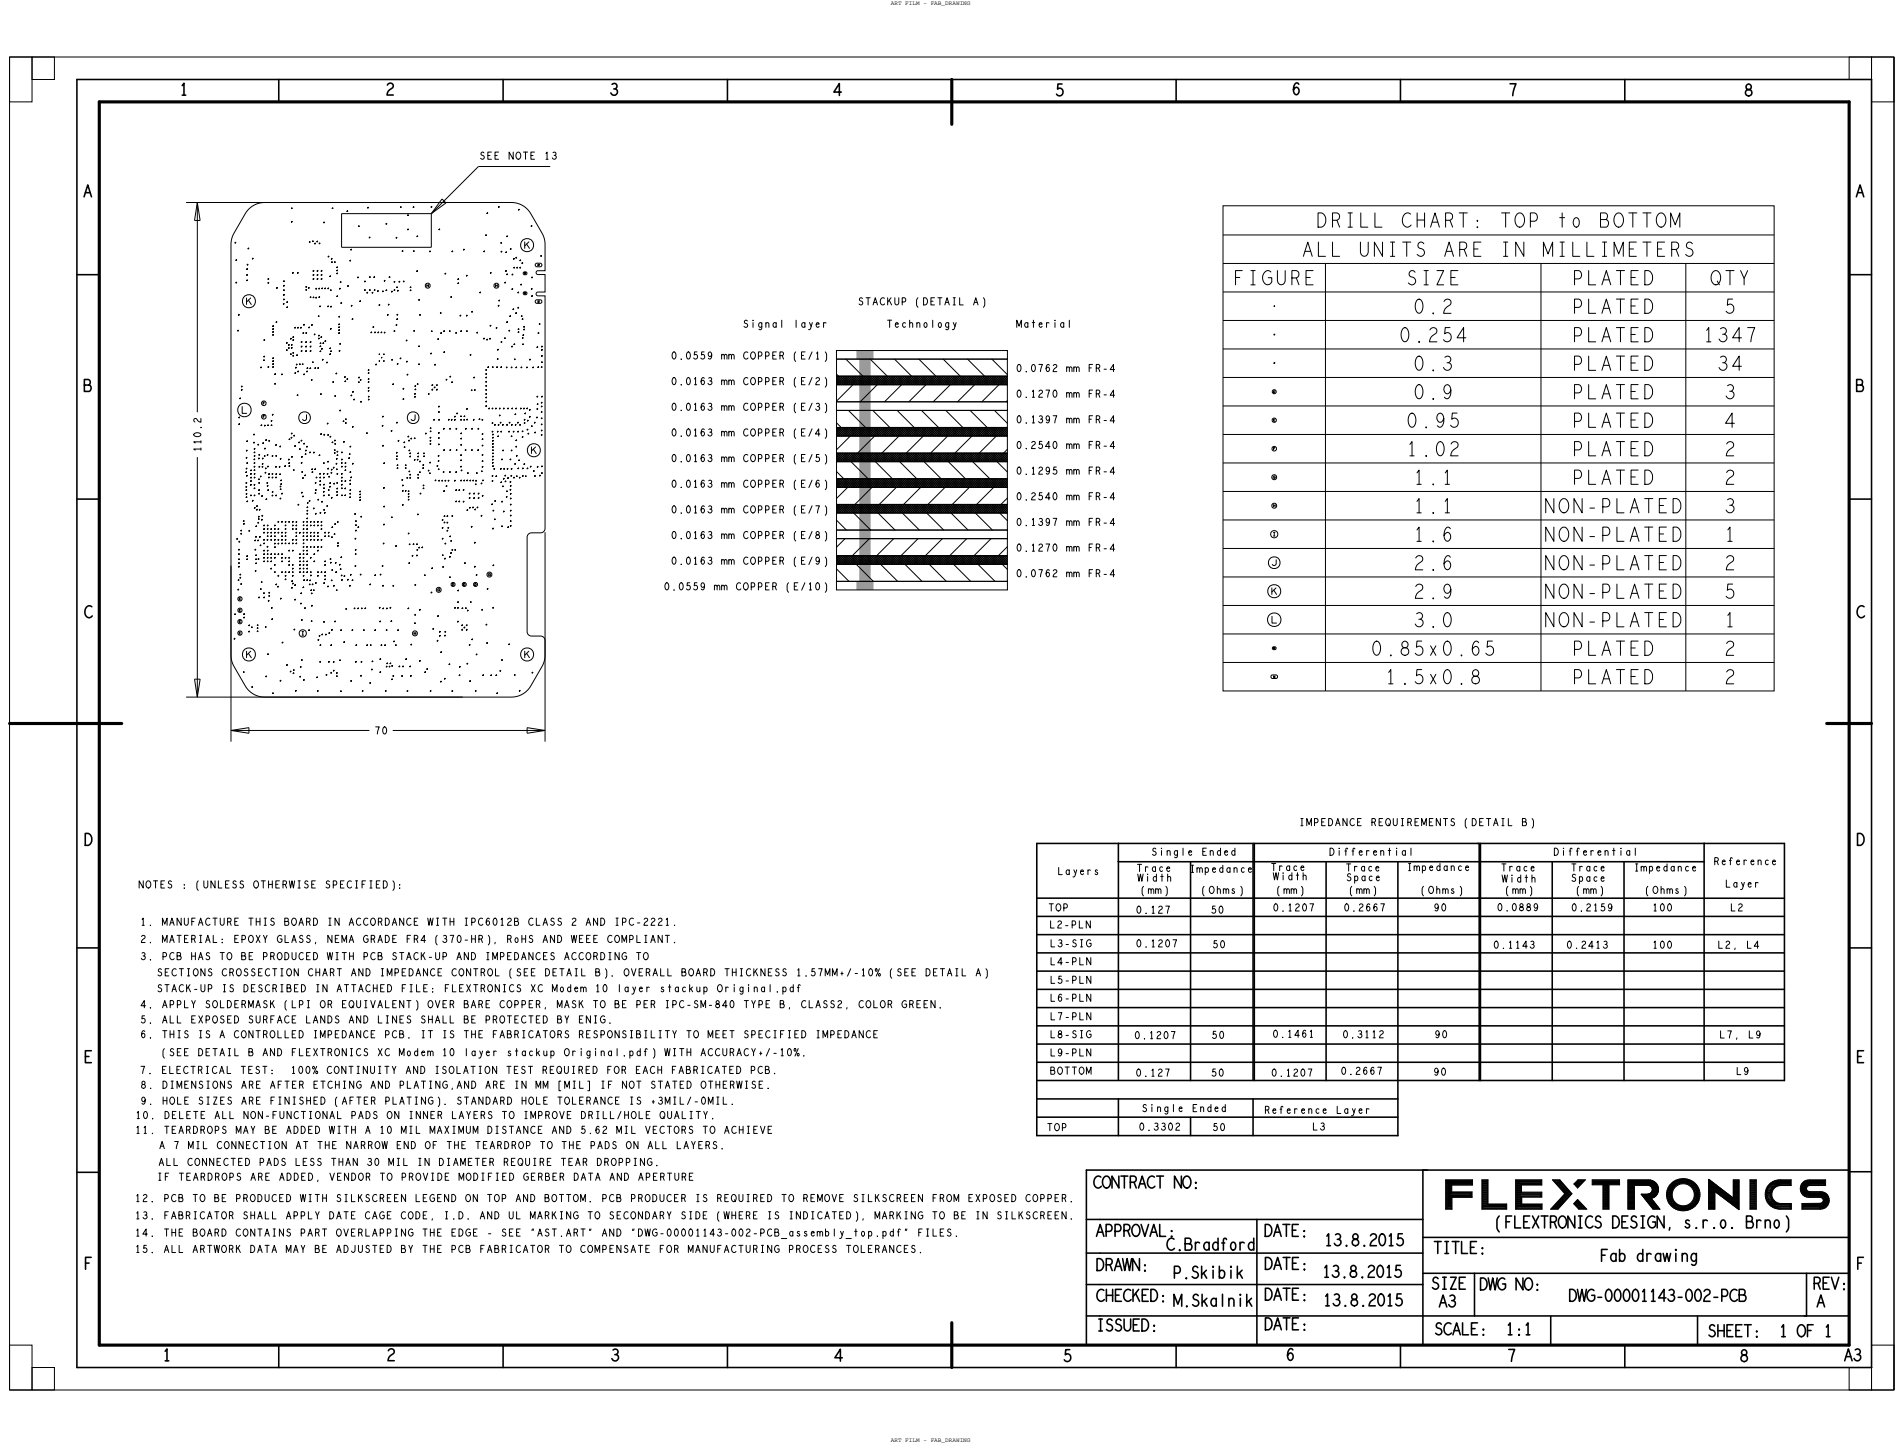
[picture p71: page 1]
ART FILM - FAB_DRAWING; QTY; Layer; Reference; SHEET:; Impedance; (Ohms); Fab; drawing; PLATED; Trace Space; NON-PLATED; Differential; Trace Width; TITLE:; SIZE; Reference Layer; FIGURE; Single Ended; Layers; L2-PLN; TOP; L3-SIG; L5-PLN; L4-PLN; L7-PLN; L6-PLN; L9-PLN; L8-SIG; BOTTOM; Material; Technology; STACKUP (DETAIL A); Signal layer; 0.0559 mm COPPER (E/1); 0.0163 mm COPPER (E/2); 0.0163 mm COPPER (E/3); 0.0163 mm COPPER (E/5); 0.0163 mm COPPER (E/4); 0.0163 mm COPPER (E/6)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

DRILL CHART: TOP to BOTTOM
ALL UNITS ARE IN MILLIMETERS

IMPEDANCE REQUIREMENTS (DETAIL B)

NOTES : (UNLESS OTHERWISE SPECIFIED):

1. MANUFACTURE THIS BOARD IN ACCORDANCE WITH IPC6012B CLASS 2 AND IPC-2221.

2. MATERIAL: EPOXY GLASS, NEMA GRADE FR4 (370-HR), RoHS AND WEEE COMPLIANT.

3. PCB HAS TO BE PRODUCED WITH PCB STACK-UP AND IMPEDANCES ACCORDING TO

SECTIONS CROSSECTION CHART AND IMPEDANCE CONTROL (SEE DETAIL B). OVERALL BOARD THICKNESS 1.57MM+/-10% (SEE DETAIL A)

STACK-UP IS DESCRIBED IN ATTACHED FILE: FLEXTRONICS XC Modem 10 layer stackup Original.pdf

4. APPLY SOLDERMASK (LPI OR EQUIVALENT) OVER BARE COPPER, MASK TO BE PER IPC-SM-840 TYPE B, CLASS2, COLOR GREEN.

5. ALL EXPOSED SURFACE LANDS AND LINES SHALL BE PROTECTED BY ENIG.
6. THIS IS A CONTROLLED IMPEDANCE PCB. IT IS THE FABRICATORS RESPONSIBILITY TO MEET SPECIFIED IMPEDANCE

(SEE DETAIL B AND FLEXTRONICS XC Modem 10 layer stackup Original.pdf) WITH ACCURACY+/-10%.

7. ELECTRICAL TEST: 100% CONTINUITY AND ISOLATION TEST REQUIRED FOR EACH FABRICATED PCB.
8. DIMENSIONS ARE AFTER ETCHING AND PLATING,AND ARE IN MM [MIL] IF NOT STATED OTHERWISE.

9. HOLE SIZES ARE FINISHED (AFTER PLATING). STANDARD HOLE TOLERANCE IS +3MIL/-0MIL.
10. DELETE ALL NON-FUNCTIONAL PADS ON INNER LAYERS TO IMPROVE DRILL/HOLE QUALITY.
11. TEARDROPS MAY BE ADDED WITH A 10 MIL MAXIMUM DISTANCE AND 5.62 MIL VECTORS TO ACHIEVE

A 7 MIL CONNECTION AT THE NARROW END OF THE TEARDROP TO THE PADS ON ALL LAYERS.

ALL CONNECTED PADS LESS THAN 30 MIL IN DIAMETER REQUIRE TEAR DROPPING.
IF TEARDROPS ARE ADDED, VENDOR TO PROVIDE MODIFIED GERBER DATA AND APERTURE

CONTRACT NO:

12. PCB TO BE PRODUCED WITH SILKSCREEN LEGEND ON TOP AND BOTTOM. PCB PRODUCER IS REQUIRED TO REMOVE SILKSCREEN FROM EXPOSED COPPER.

13. FABRICATOR SHALL APPLY DATE CAGE CODE, I.D. AND UL MARKING TO SECONDARY SIDE (WHERE IS INDICATED), MARKING TO BE IN SILKSCREEN.

(FLEXTRONICS DESIGN, s.r.o. Brno)

14. THE BOARD CONTAINS PART OVERLAPPING THE EDGE - SEE "AST.ART" AND "DWG-00001143-002-PCB_assembly_top.pdf" FILES.

APPROVAL: C.Bradford | DATE: 13.8.2015

15. ALL ARTWORK DATA MAY BE ADJUSTED BY THE PCB FABRICATOR TO COMPENSATE FOR MANUFACTURING PROCESS TOLERANCES.

DRAWN: P.Skibik | DATE: 13.8.2015

SIZE A3 | DWG NO: DWG-00001143-002-PCB | REV: A

CHECKED: M.Skalnik | DATE: 13.8.2015

ISSUED: | DATE: | SCALE: 1:1
