openxc/openxc-accessories/docs/electrical/Modem/SCHEMATIC-08-SAMA5D3x NAND.pdf

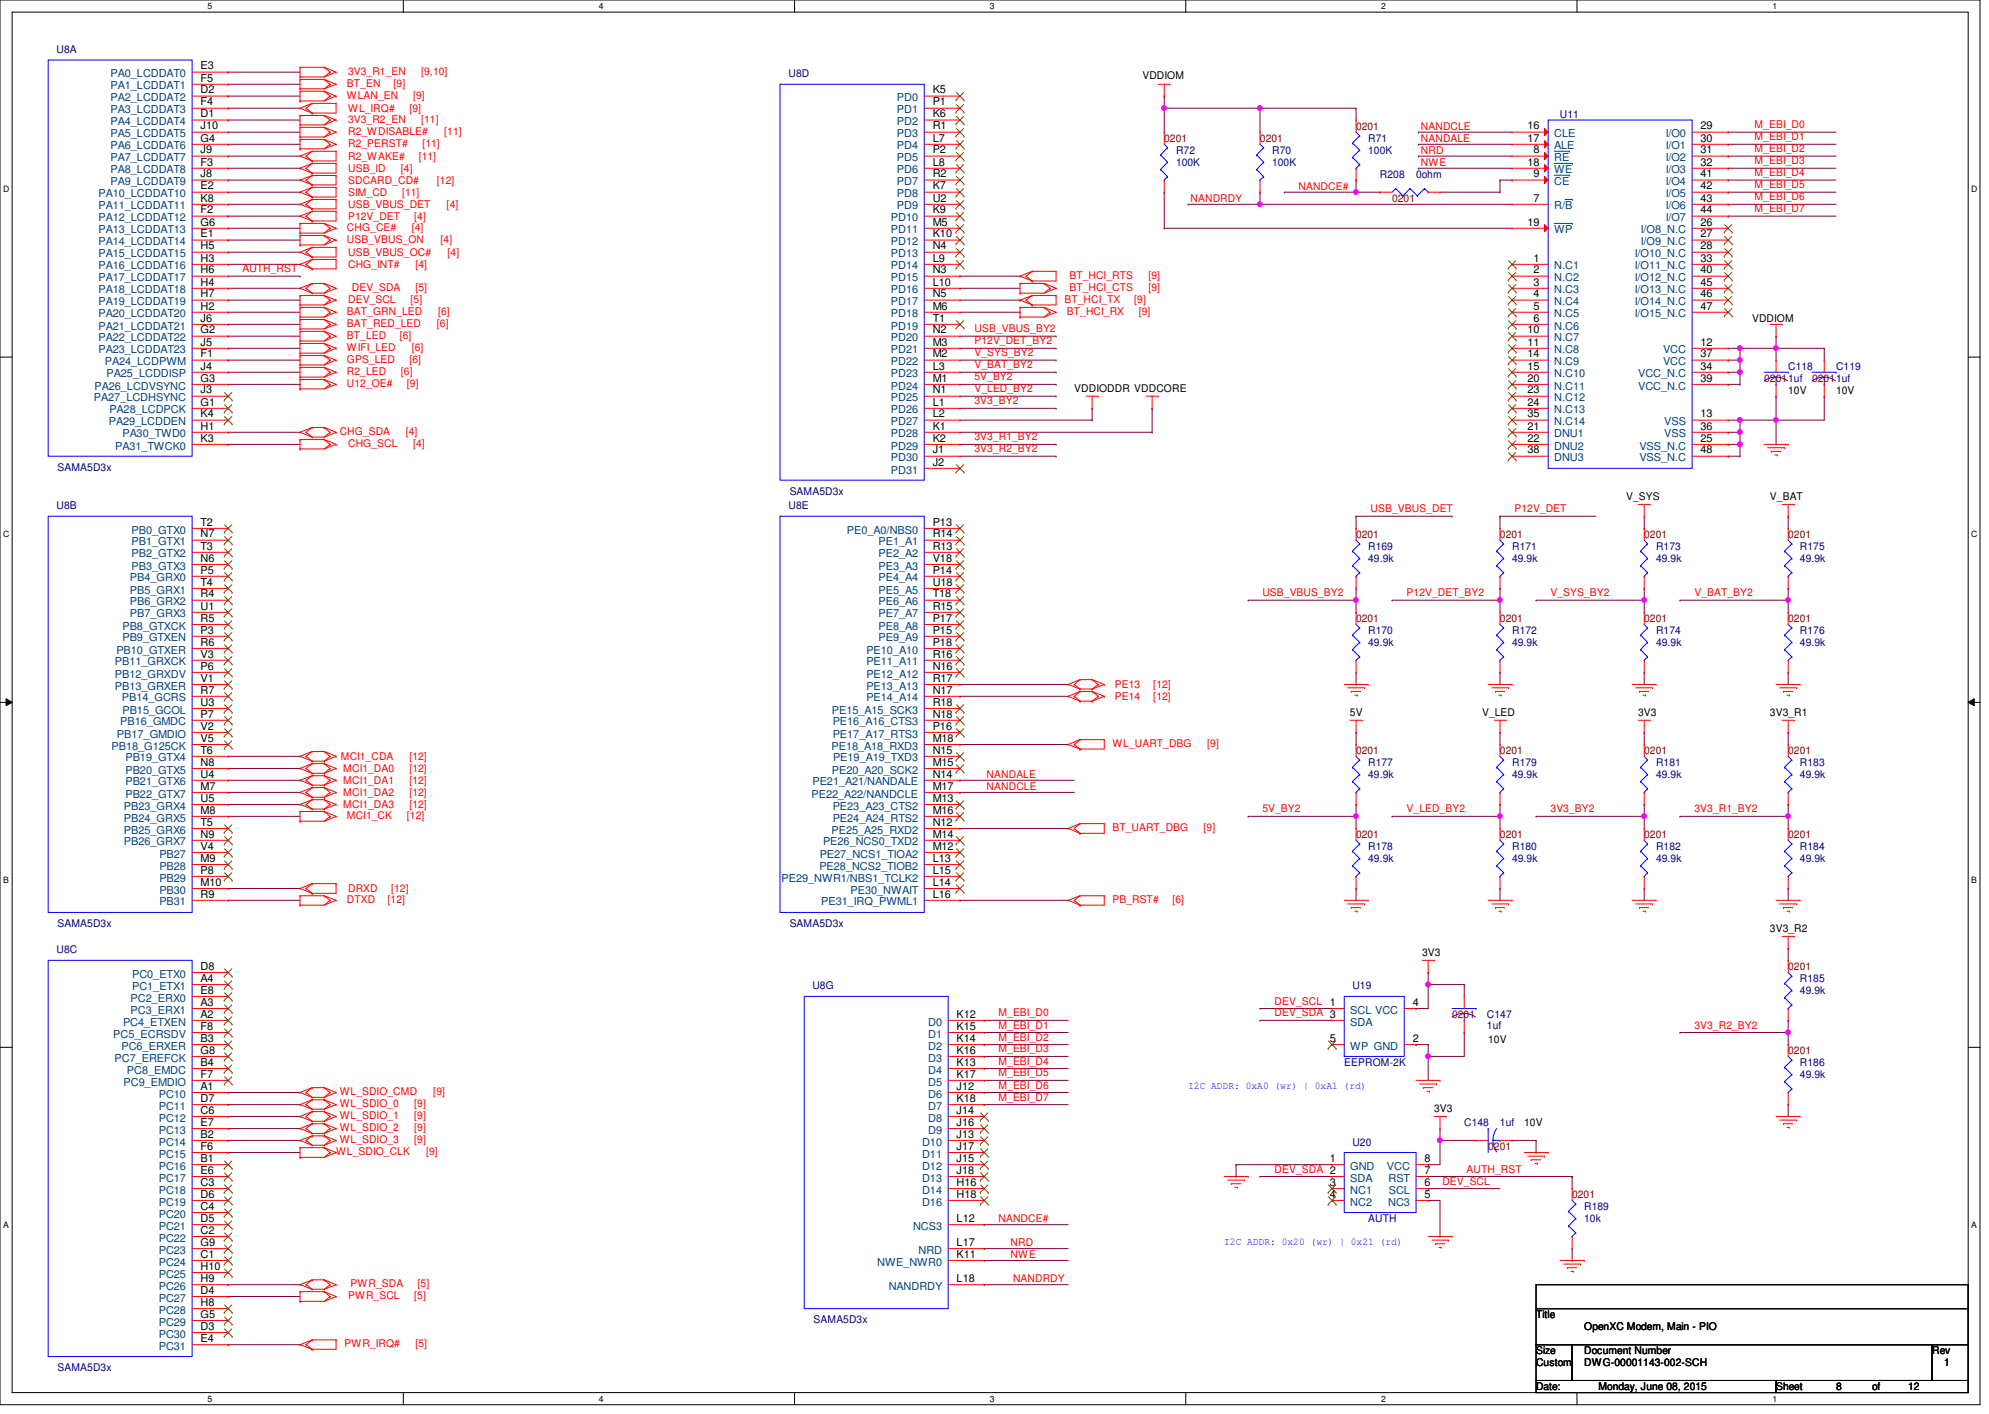
[picture p72: page 1]

OpenXC Modem, Main - PIO
