openxc/openxc-accessories/docs/electrical/Modem/SCHEMATIC-09-BT IF.pdf

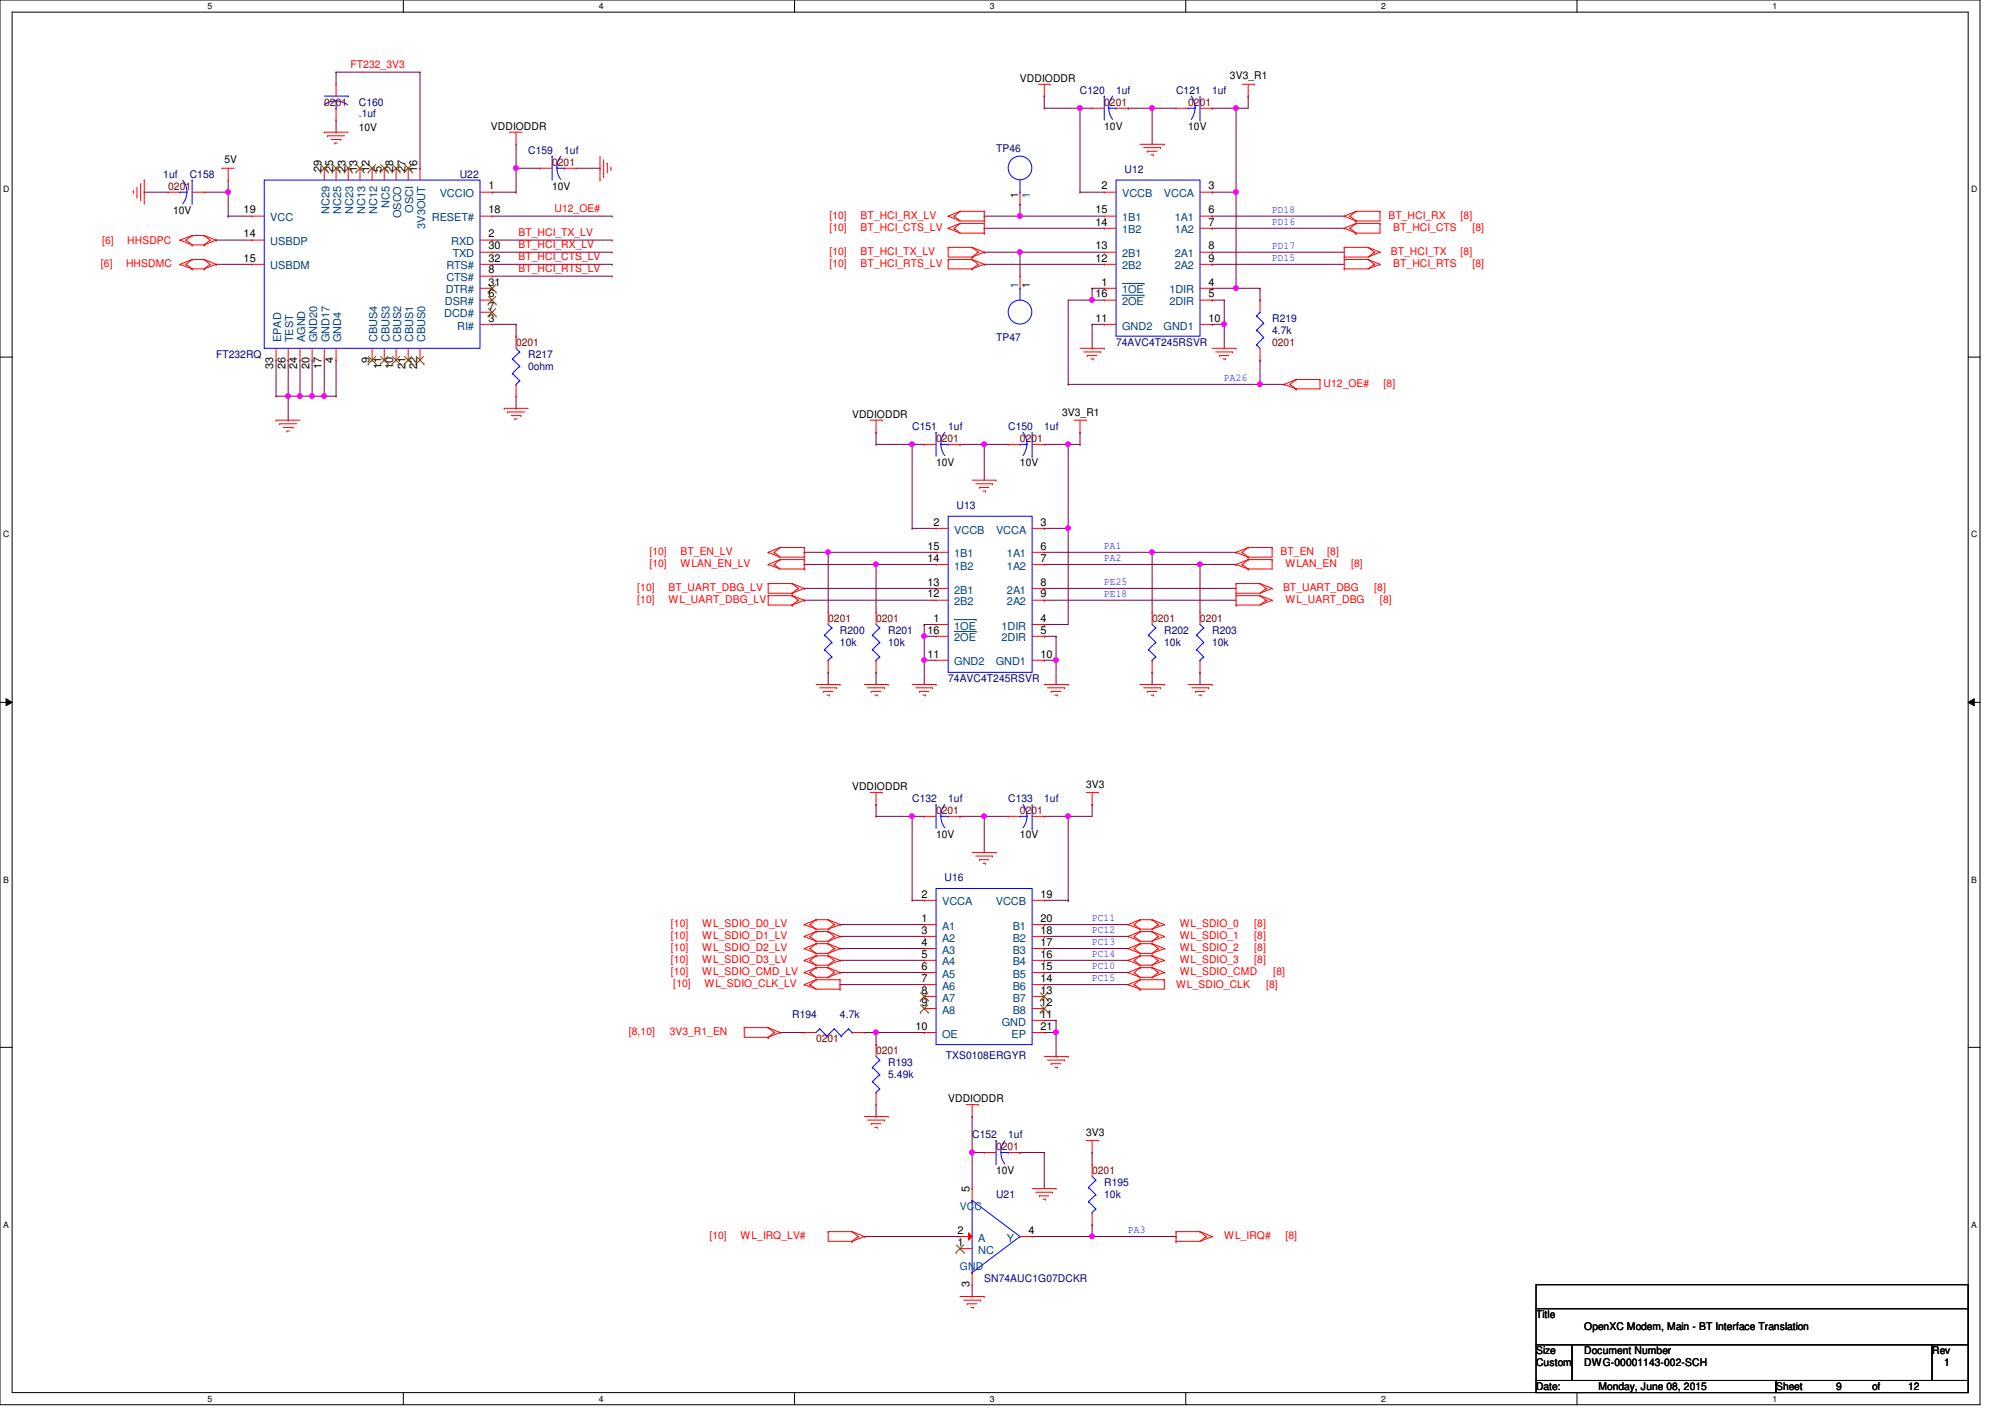
[picture p73: page 1]

OpenXC Modem, Main - BT Interface Translation
