openxc/openxc-accessories/docs/electrical/Modem/SCHEMATIC-11-Mini PCIe Radio.pdf

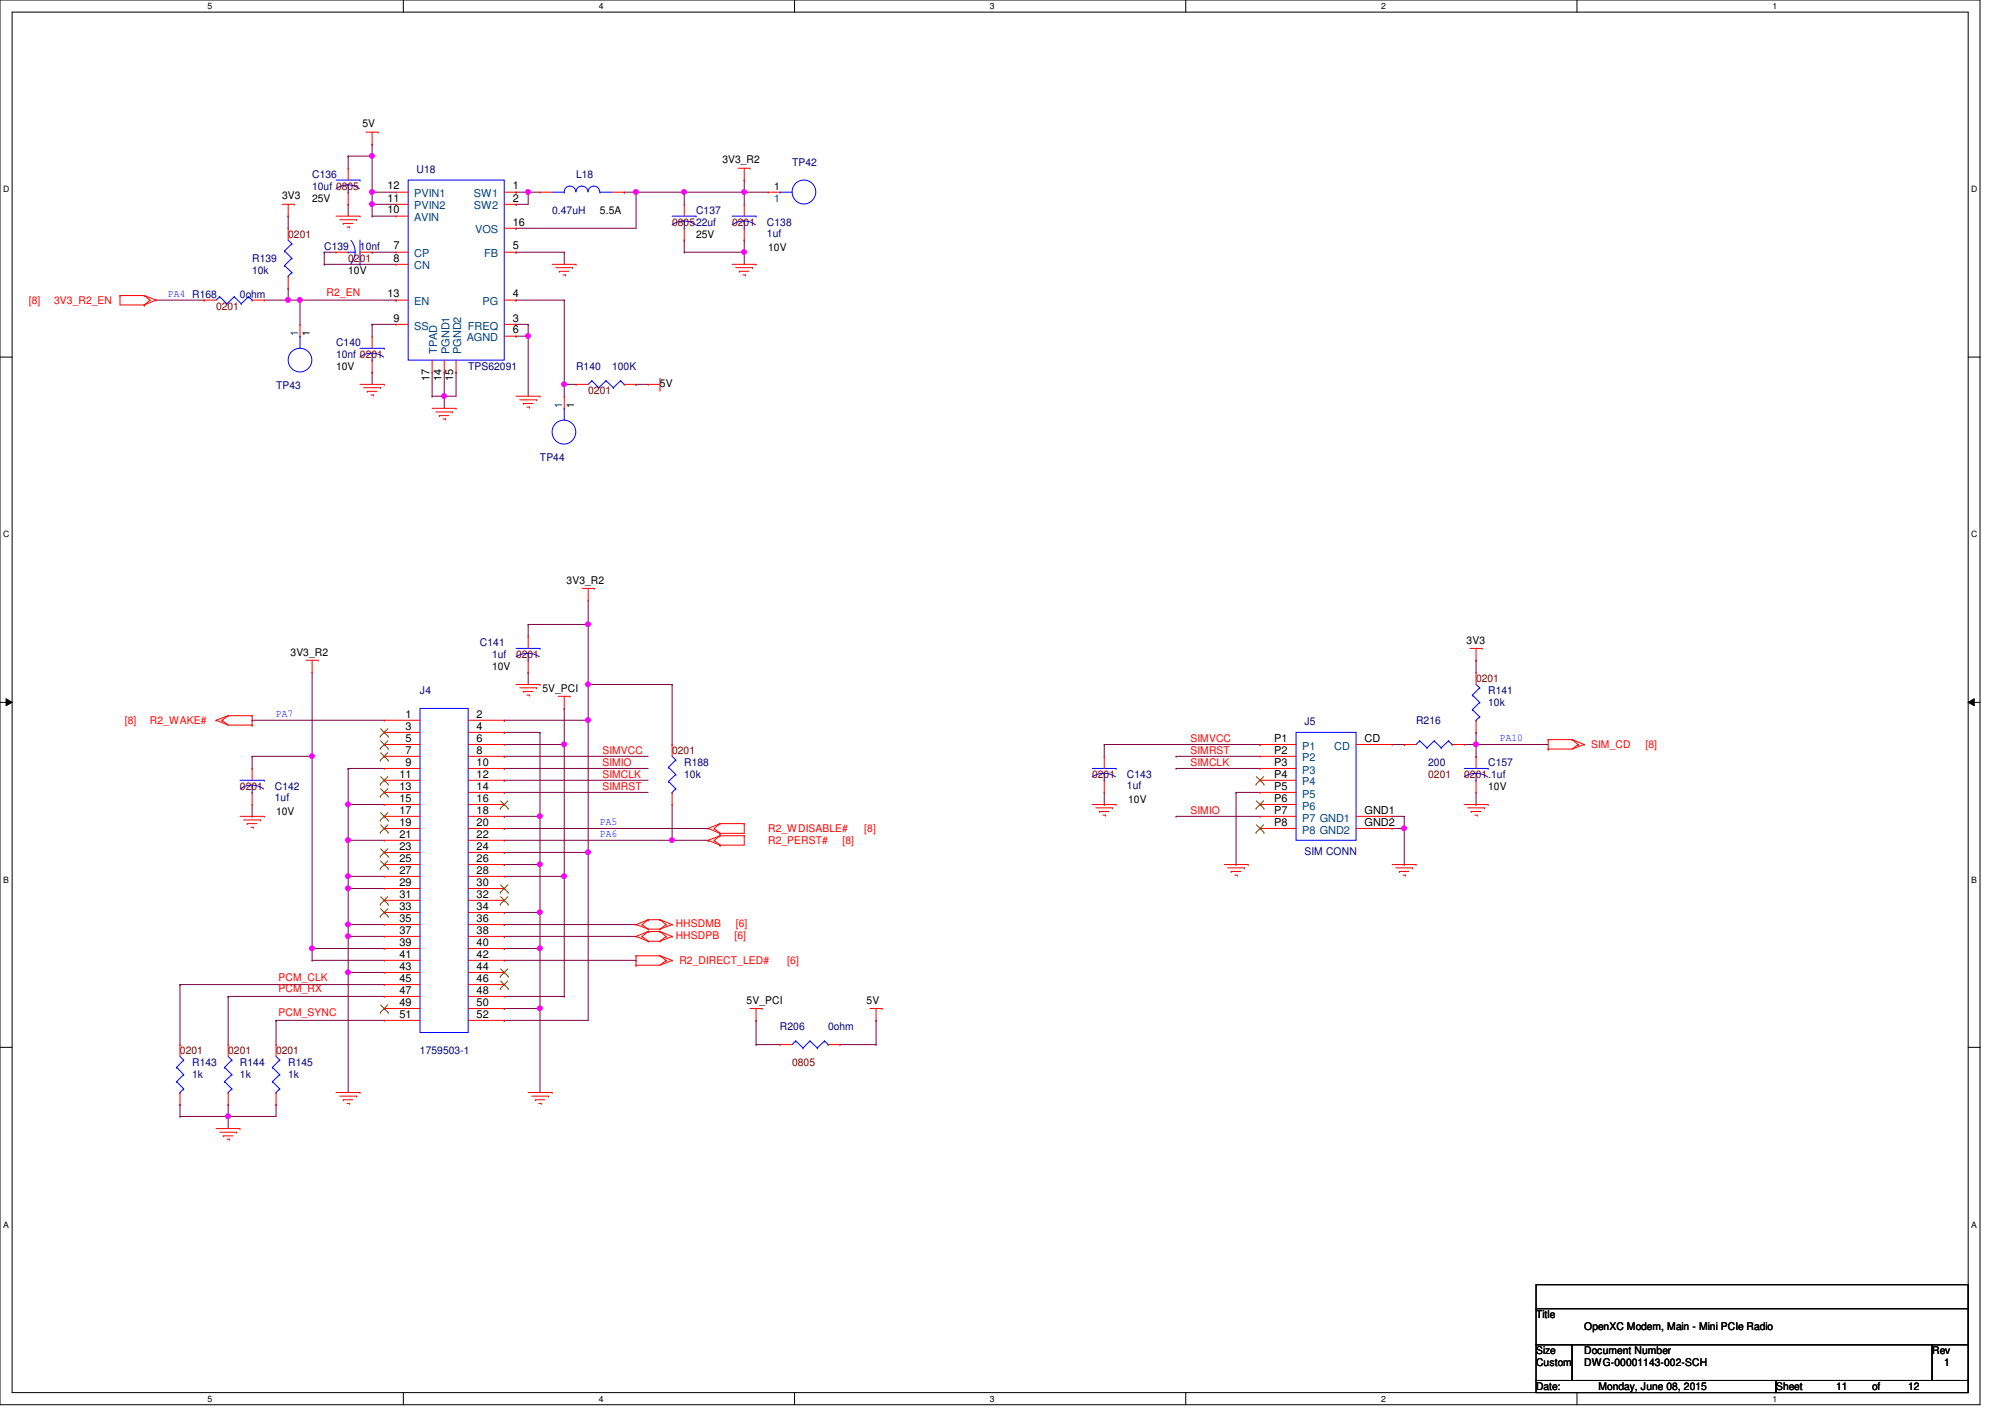
[picture p74: page 1]

OpenXC Modem, Main - Mini PCIe Radio
