openxc/openxc-accessories/docs/electrical/V2X/80211p carrier pcb v1 dvt revb.pdf

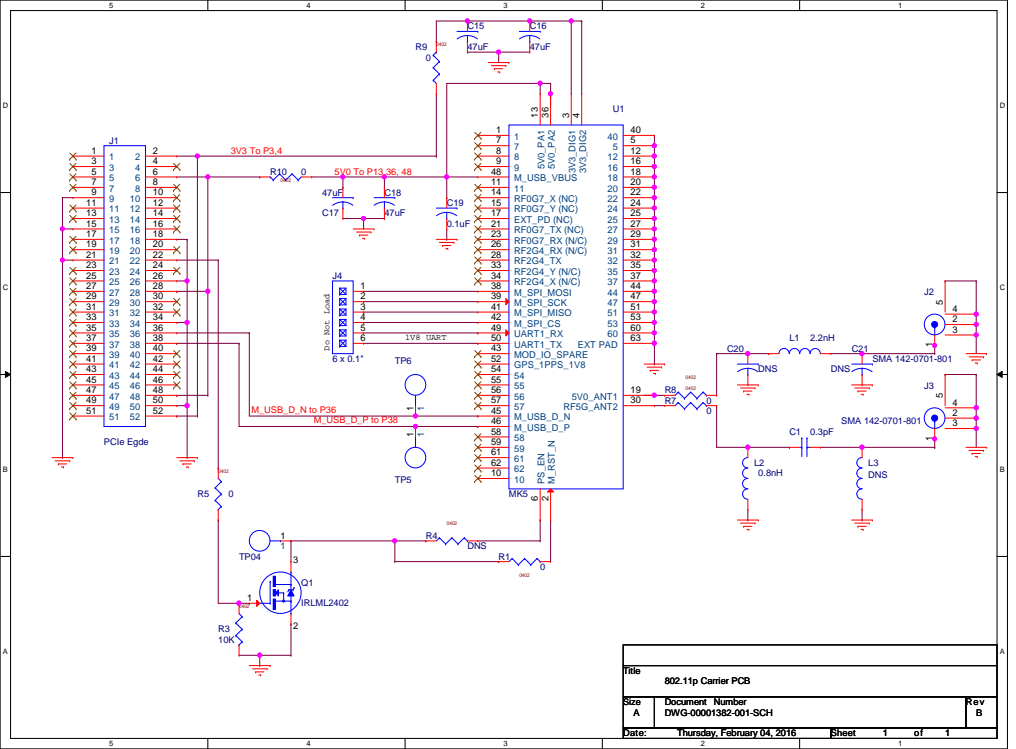
[picture p75: page 1]
