openxc/openxc-accessories/(list of files, drawings)

Other design files:
docs/electrical/Modem/XCMODEM_R3.dsn
docs/electrical/Modem/xcmodem_r3.opj
