openxc/openxc-accessories/(commit log)

2015-09-14 more RTD structure. BOM. Enabler apk
    [Modem_COSTED_BOM_QUOTE.xlsx]
2016-09-30 Updated USB driver
2017-01-26 Add FTDI driver
2017-02-23 Add device overview
2017-02-28 Add Notes and Power Saving Mode
2017-02-28 Add LEDs
2017-11-17 added new v2x files. Re-organized the modem files
    [BOM_DVT_20160208.xls, ELC-00002541-000.IGS, MCH-00001326-000.IGS, MCH-00001842-000.IGS, MCH-00001843-000.IGS, MCH-00001844-000.IGS, MCH-00001845-000.IGS, MCH-00001846-000.IGS]
